amber-sile-yang/Pi-Hub-PCB/Rev A/Media/PCB_NFC_PI_1.png

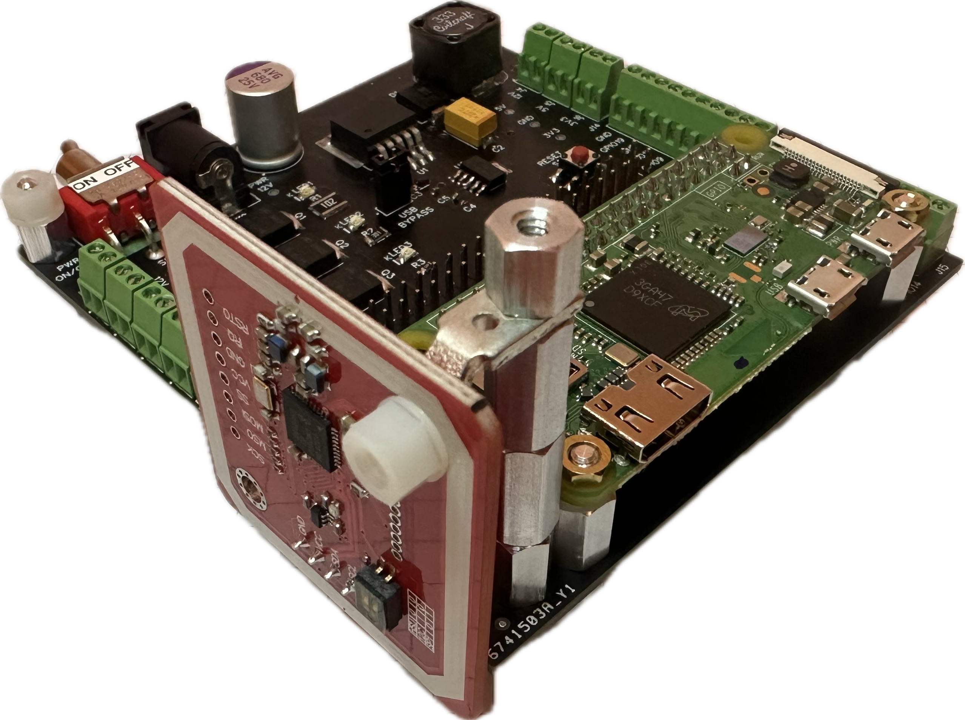
Rev A/Media/PCB_NFC_PI_1.png
