amber-sile-yang/Pi-Hub-PCB/Rev A/Media/PCB_Front_Side_View_1600_840.png

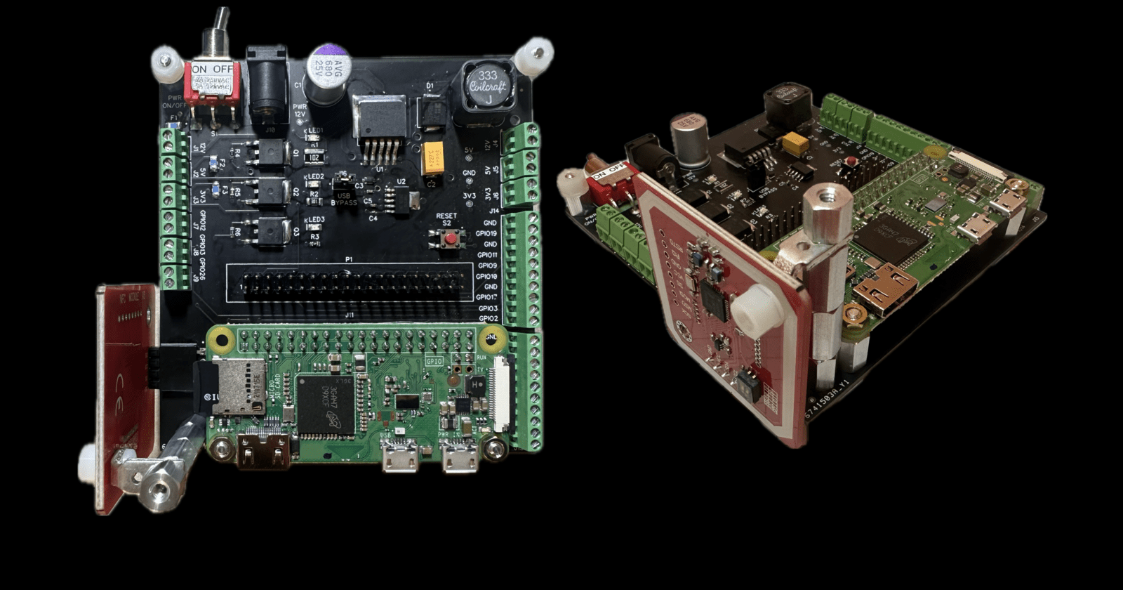
Rev A/Media/PCB_Front_Side_View_1600_840.png
