amber-sile-yang/Pi-Hub-PCB/Rev A/Regulator Circuit/TPS79633_5 to 3V_Regulator Circuit.pdf

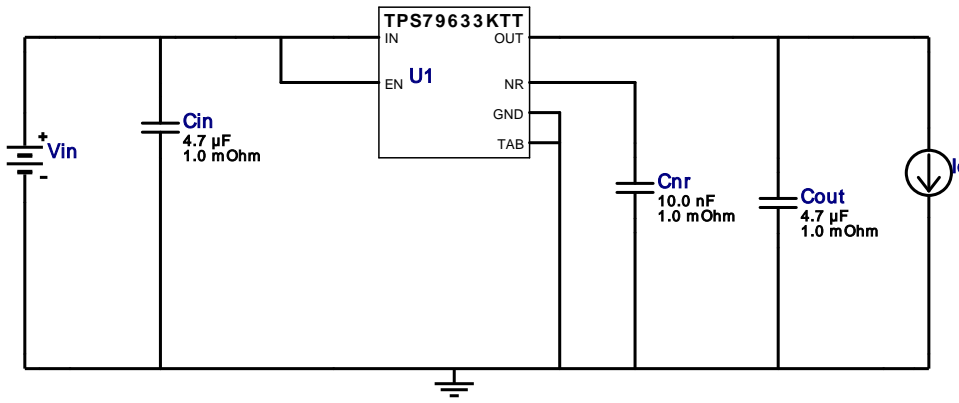
[picture p7: figure]
Cin 4.7 µF 1.0 m Ohm; Cnr 10.0 nF 1.0 m Ohm; Cout 4.7 µF 1.0 m Ohm; TPS7 9 6 3 3 KTT; GND; OUT; TAB; Vin

Copyright © 2023, Texas Instruments Incorporated | 1 | ti.com/webench

WEBENCH®
Design Report TPS79633KTTR : TPS79633KTTR 3.64V-5.08V to 3.30V @ 1A October 2, 2023 13:13:07 GMT-05:00

## WEBENCH ® Design Report

Design : 3 TPS79633KTTR
TPS79633KTTR 3.64V-5.08V to 3.30V @ 1A

VinMin = 3.64V
VinMax = 5.08V
Vout = 3.3V
Iout = 1.0A

Device = TPS79633KTTR
Topology = LDO
Created = 2023-10-02 13:11:06.164 BOM Cost = $1.58
BOM Count = 4
Total Pd = 1.78W

Vout = 3.3V
Iout = 1.0A

Iout

## Electrical BOM

Name | Manufacturer | Part Number | Properties | Qty Price | Footprint
Cin | MuRata | GRM155R60J475ME87D Series= X5R | Cap= 4.7 uF ESR= 1.0 mOhm VDC= 6.3 V IRMS= 0.0 A
1 | $0.01
| | | | | 0402_065 3 mm²
Cnr | MuRata | GRM033R70J103KA01D (http://search.murata.co.jp/Ceramy/PnsearchViewAction.do) Series= X7R

Cap= 10.0 nF
ESR= 1.0 mOhm
VDC= 6.3 V
IRMS= 0.0 A

1 $0.01
0201 2 mm²
Cout | MuRata | GRM155R60J475ME87D Series= X5R

Cap= 4.7 uF
ESR= 1.0 mOhm
VDC= 6.3 V
IRMS= 0.0 A

1 $0.01
0402_065 3 mm²
U1 | Texas Instruments | TPS79633KTTR (http://www.ti.com/product/TPS796) | Switcher | 1 | $1.55

KTT0005A_N 210 mm²

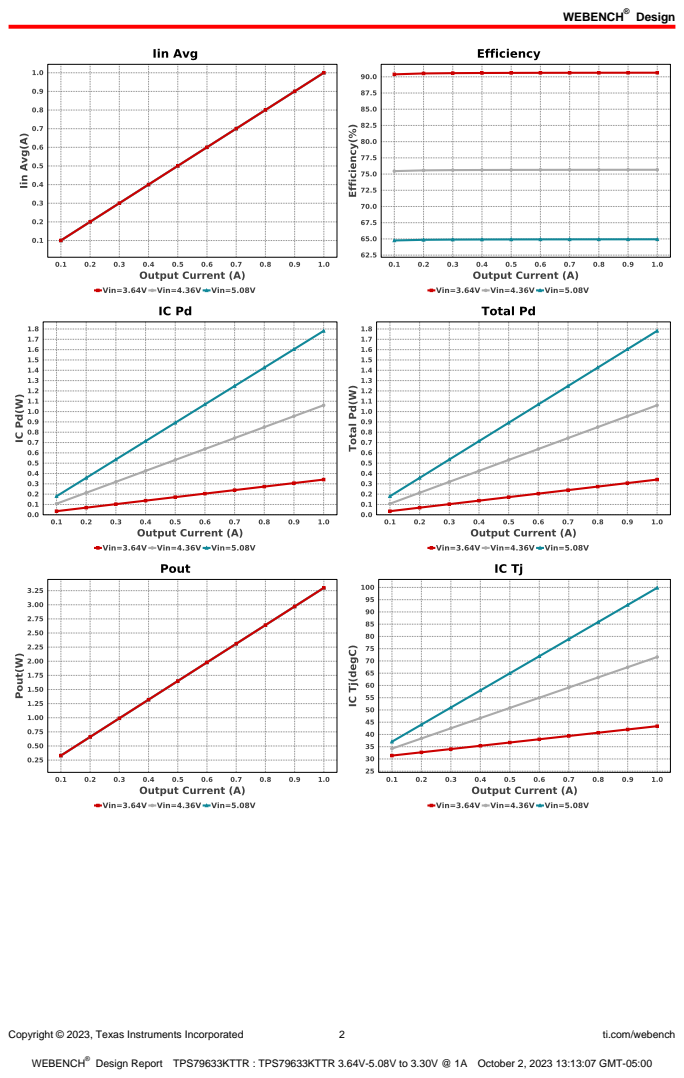
[picture p8: page 2]
Design; Copyright © 2023, Texas Instruments Incorporated; ti.com/webench

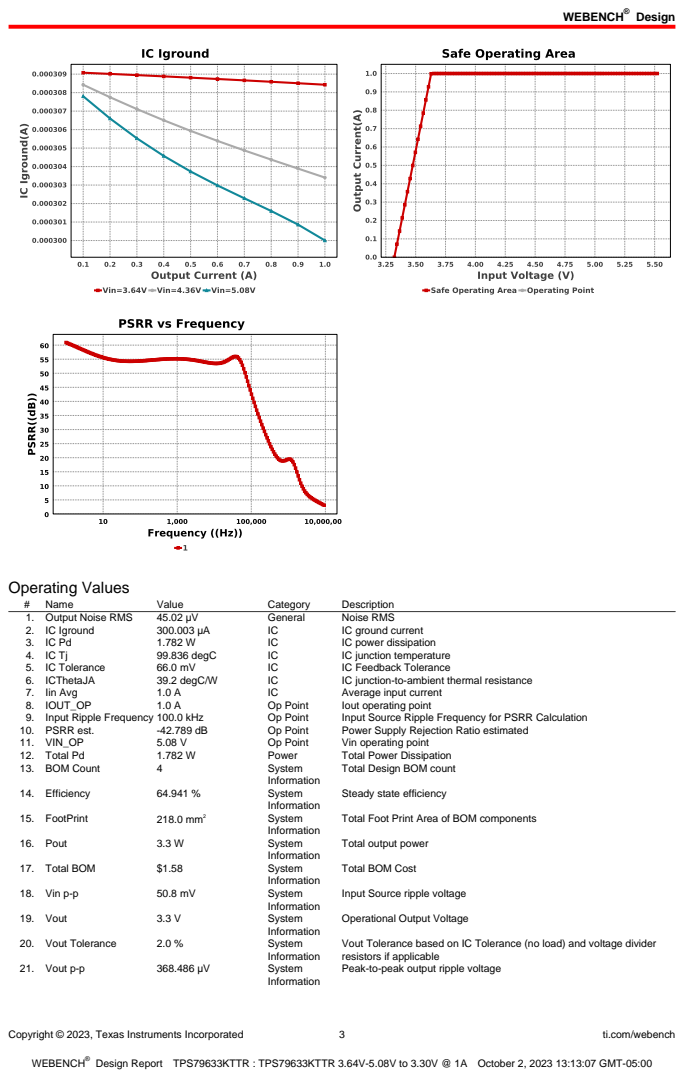
[picture p9: page 3]
Copyright © 2023, Texas Instruments Incorporated; ti.com/webench; Operating Values; Name; Value; Category; Description; 1. Output Noise RMS; General; Noise RMS; 2. IC Iground; IC ground current; IC power dissipation; 99.836 degC; IC junction temperature; 5. IC Tolerance; IC Feedback Tolerance; 6. ICThetaJA; 39.2 degC/W; IC junction-to-ambient thermal resistance; 7. Iin Avg; Average input current; 8. IOUT_OP; Op Point; Iout operating point; 9. Input Ripple Frequency 100.0 kHz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

Total Design BOM count

Steady state efficiency

Total Foot Print Area of BOM components

Total output power

Total BOM Cost

Input Source ripple voltage

Operational Output Voltage

Vout Tolerance based on IC Tolerance (no load) and voltage divider
resistors if applicable
Peak-to-peak output ripple voltage

Copyright © 2023, Texas Instruments Incorporated | 4 | ti.com/webench

## Design Inputs

Name | Value | Description
Iout | 1.0 | Maximum Output Current
VinMax | 5.08 | Maximum input voltage
VinMin | 3.64 | Minimum input voltage
Vout | 3.3 | Output Voltage
base_pn | TPS79633 | Base Product Number
source | DC | Input Source Type
Ta | 30.0 | Ambient temperature


Copyright © 2023, Texas Instruments Incorporated | 5 | ti.com/webench

## Assembly

## Component Testing

Some published data on components in datasheets such as Capacitor ESR and Inductor DC resistance is based on conservative values that will guarantee that the components always exceed the specification. For design purposes it is usually better to work with typical values. Since this data is not always available it is a good practice to measure the Capacitance and ESR values of Cin and Cout, and the inductance and DC resistance of L1 before assembly of the board. Any large discrepancies in values should be electrically simulated in WEBENCH to check for instabilities and thermally simulated in WebTHERM to make sure critical temperatures are not exceeded.

## Soldering Component to Board

If board assembly is done in house it is best to tack down one terminal of a component on the board then solder the other terminal. For surface mount parts with large tabs, such as the DPAK, the tab on the back of the package should be pre-tinned with solder, then tacked into place by one of the pins. To solder the tab town to the board place the iron down on the board while resting against the tab, heating both surfaces simultaneously. Apply light pressure to the top of the plastic case until the solder flows around the part and the part is flush with the PCB. If the solder is not flowing around the board you may need a higher wattage iron (generally 25W to 30W is enough).

## Initial Startup of Circuit

It is best to initially power up the board by setting the input supply voltage to the lowest operating input voltage 3.64V and set the input supply's current limit to zero. With the input supply off connect up the input supply to Vin and GND. Connect a digital volt meter and a load if needed to set the minimum Iout of the design from Vout and GND. Turn on the input supply and slowly turn up the current limit on the input supply.
If the voltage starts to rise on the input supply continue increasing the input supply current limit while watching the output voltage. If the current increases on the input supply, but the voltage remains near zero, then there may be a short or a component misplaced on the board. Power down the board and visually inspect for solder bridges and recheck the diode and capacitor polarities. Once the power supply circuit is operational then more extensive testing may include full load testing, transient load and line tests to compare with simulation results.

## Load Testing

The setup is the same as the initial startup, except that an additional digital voltmeter is connected between Vin and GND, a load is connected between Vout and GND and a current meter is connected in series between Vout and the load. The load must be able to handle at least rated output power + 50% ( 7.5 watts for this design). Ideally the load is supplied in the form of a variable load test unit. It can also be done in the form of suitably large power resistors. When using an oscilloscope to measure waveforms on the prototype board, the ground leads of the oscilloscope probes should be as short as possible and the area of the loop formed by the ground lead should be kept to a minimum. This will help reduce ground lead inductance and eliminate EMI noise that is not actually present in the circuit.

## Design Assistance

1.
2. Master key : 29F0C5E535570A6F9FC1D70942BDB839[v1]
3. TPS79633 Product Folder : http://www.ti.com/product/TPS796 : contains the data sheet and other resources.

Copyright © 2023, Texas Instruments Incorporated | 6 | ti.com/webench

Important Notice and Disclaimer

TI provides technical and reliability data (including datasheets), design resources (including reference designs), application or other design advice, web tools, safety information, and other resources AS IS and with all faults, and disclaims all warranties. These resources are intended for skilled developers designing with TI products. You are solely responsible for (1) selecting the appropriate TI products for your application, (2) designing, validating and testing your application, and (3) ensuring your application meets applicable standards, and any other safety, security, or other requirements.

These resources are subject to change without notice. TI grants you permission to use these resources only for development of an application that uses the TI products described in the resource. Other reproduction and display of these resources is prohibited. No license is granted to any other TI intellectual property right or to any third party intellectual property right. TI disclaims responsibility for, and you will fully indemnify TI and its representatives against, any claims, damages, costs, losses, and liabilities arising out of your use of these resources.

Providing these resources does not expand or otherwise alter TI's applicable Terms of Sale or other applicable terms available either on ti.com or provided in conjunction with TI products.
