amber-sile-yang/Pi-Hub-PCB/Rev A/History/PCB Connector Pinouts.pdf

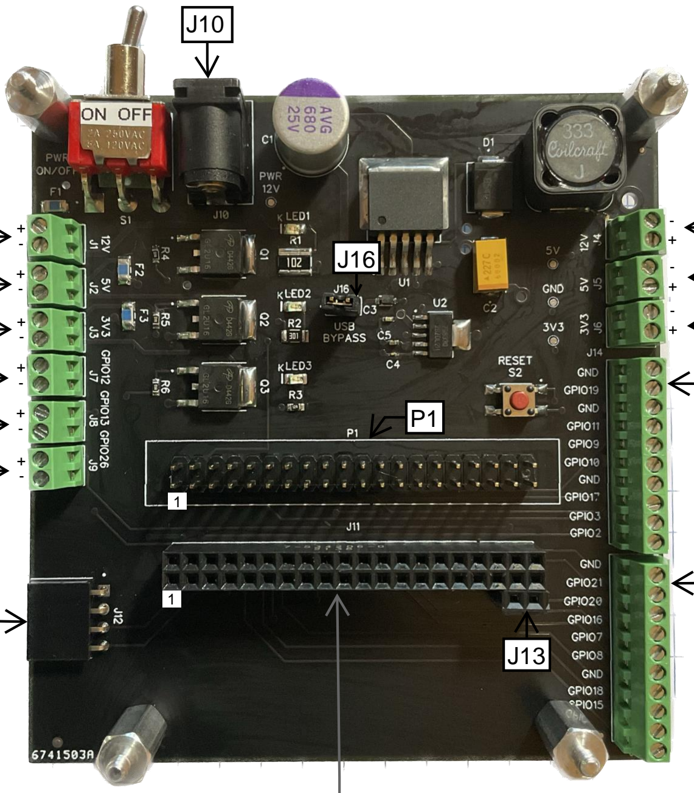
[picture p11: figure]
