amber-sile-yang/Pi-Hub-PCB/Rev A/Pinout_Rev A/PCB Connector Pinouts Diagram.pdf

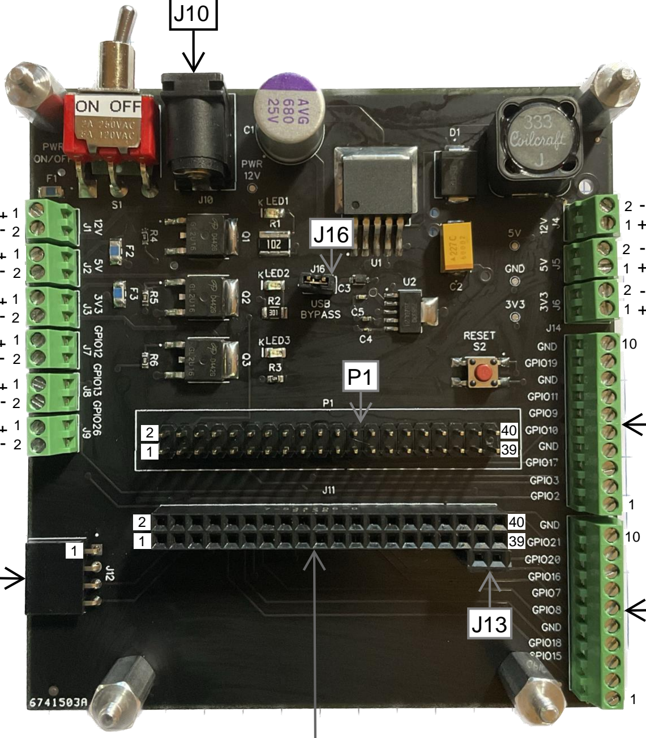
[picture p12: figure]
