amber-sile-yang/Pi-Hub-PCB/Rev A/Other/PCB_Invoice.pdf

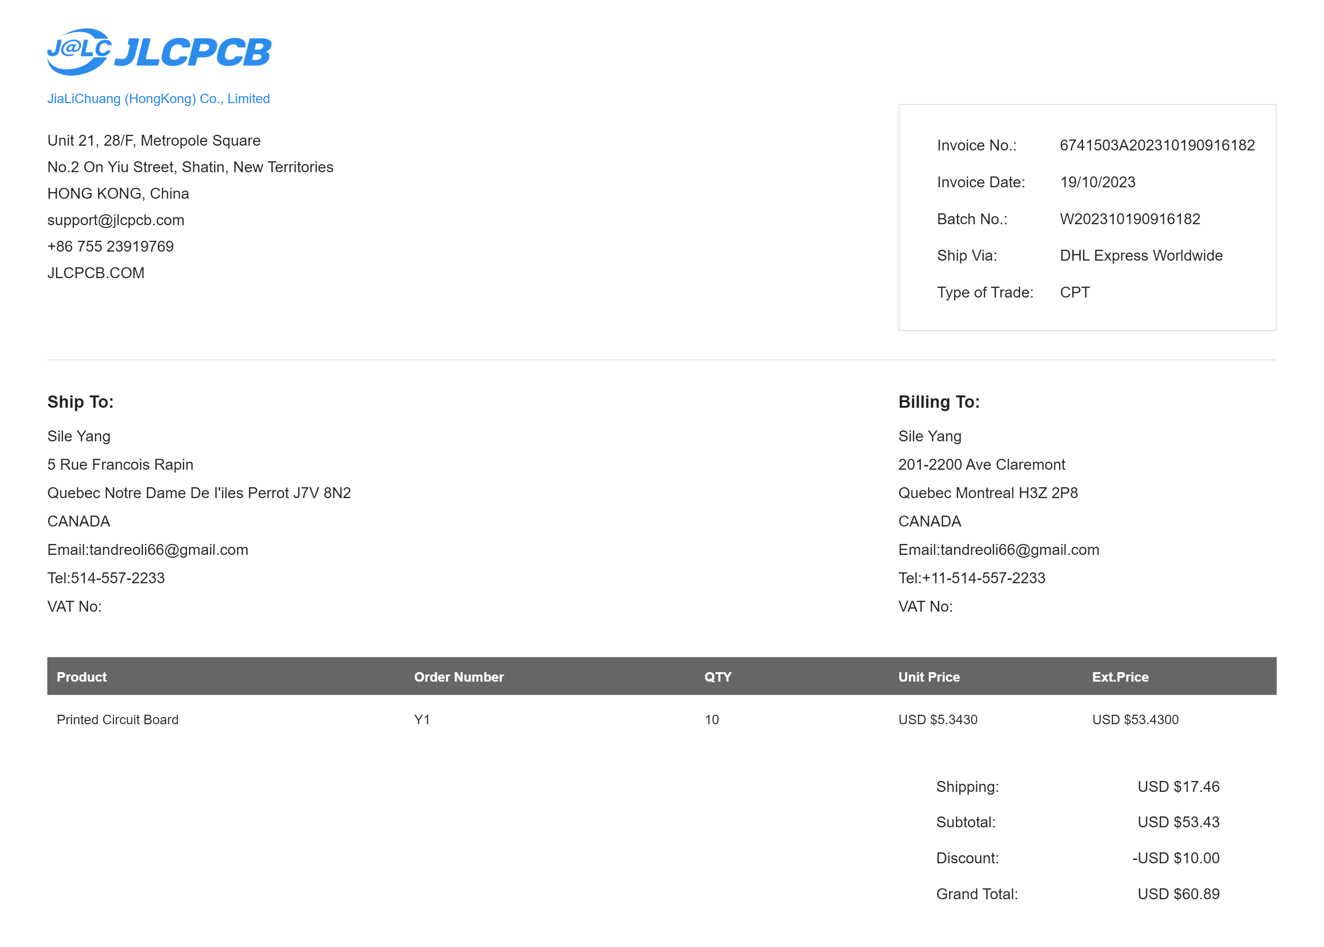
[picture p13: figure]
