amber-sile-yang/Pi-Hub-PCB/Layout_Rev B/Saturn_2A_Trace.png

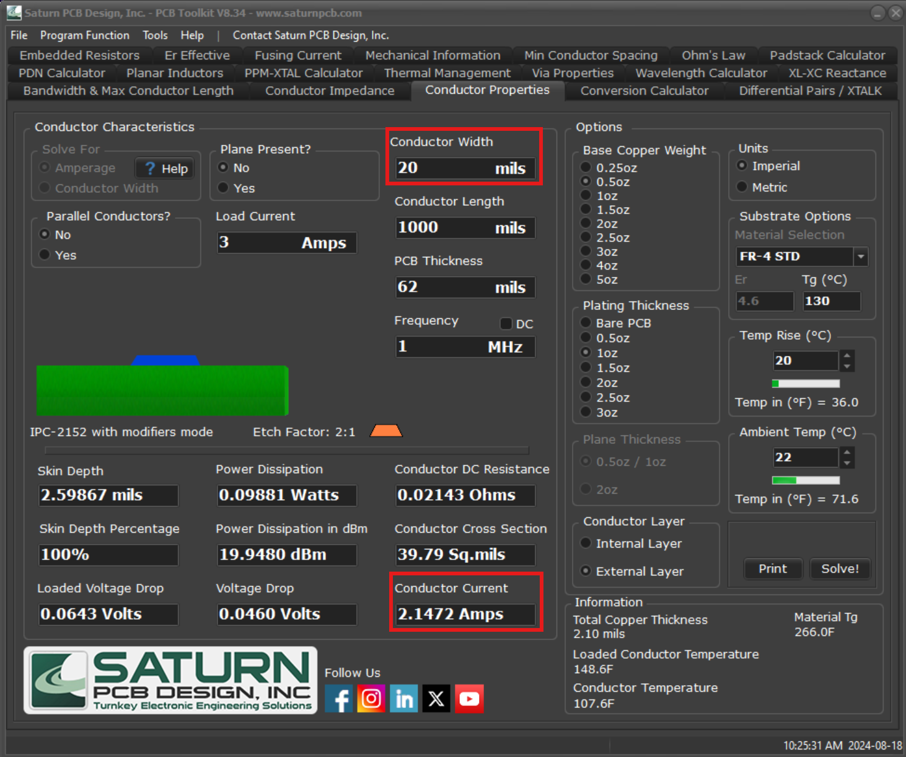
Layout_Rev B/Saturn_2A_Trace.png
