amber-sile-yang/Pi-Hub-PCB/Rev A/3D Model_Rev A/3D3.png

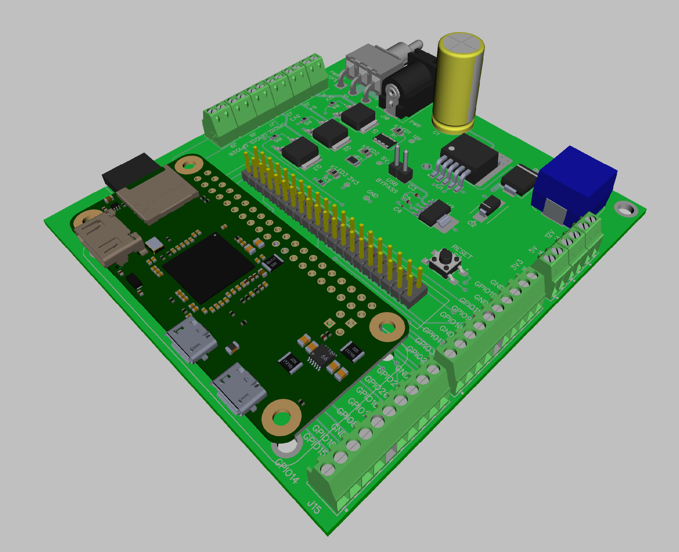
Rev A/3D Model_Rev A/3D3.png
