amber-sile-yang/Pi-Hub-PCB/Rev A/3D Model_Rev A/3D4.png

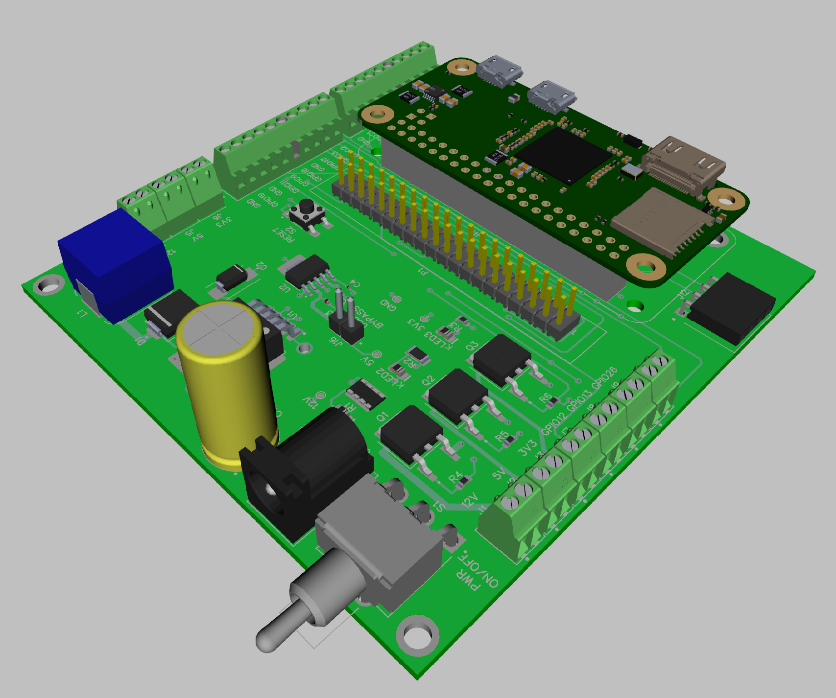
Rev A/3D Model_Rev A/3D4.png
