amber-sile-yang/Pi-Hub-PCB/Rev A/3D Model_Rev A/collage.jpg

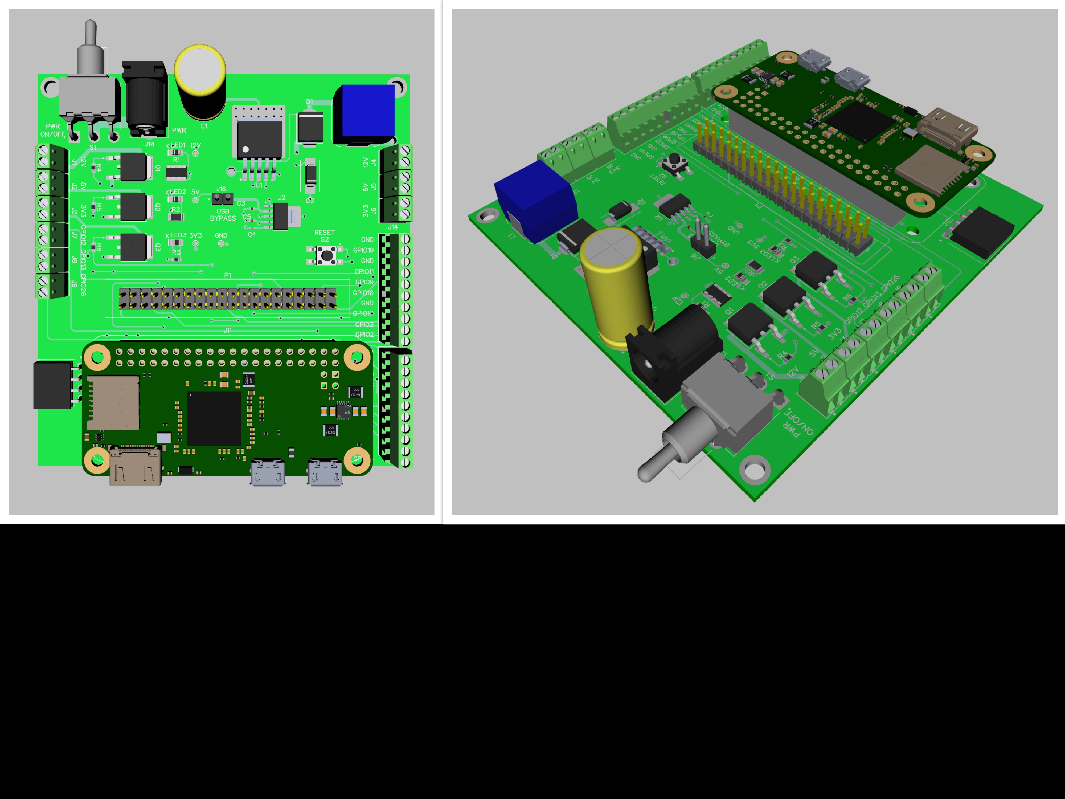
Rev A/3D Model_Rev A/collage.jpg
