amber-sile-yang/Pi-Hub-PCB/Rev A/History/Black PCB Design.png

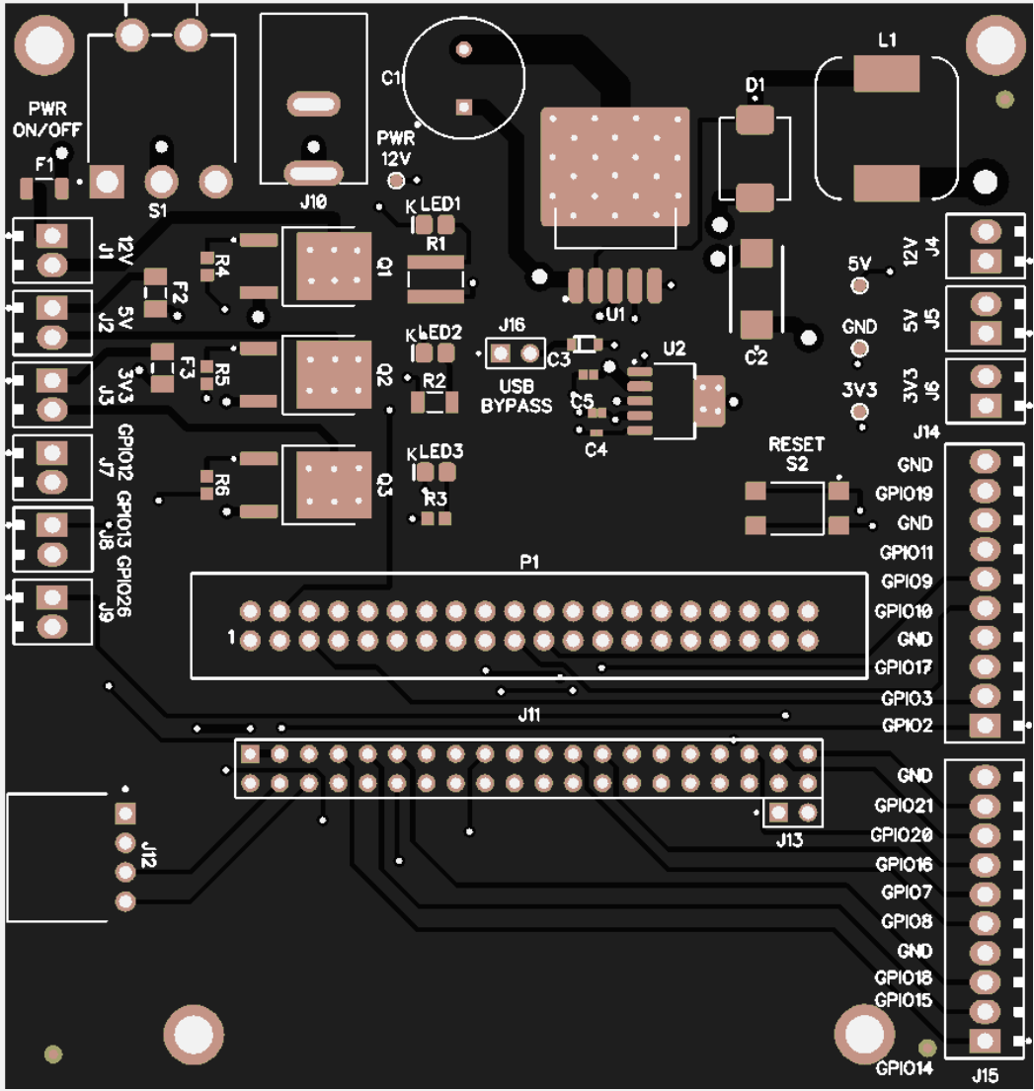
Rev A/History/Black PCB Design.png
