amber-sile-yang/Pi-Hub-PCB/Rev A/Layout_Rev A/Rev--.png

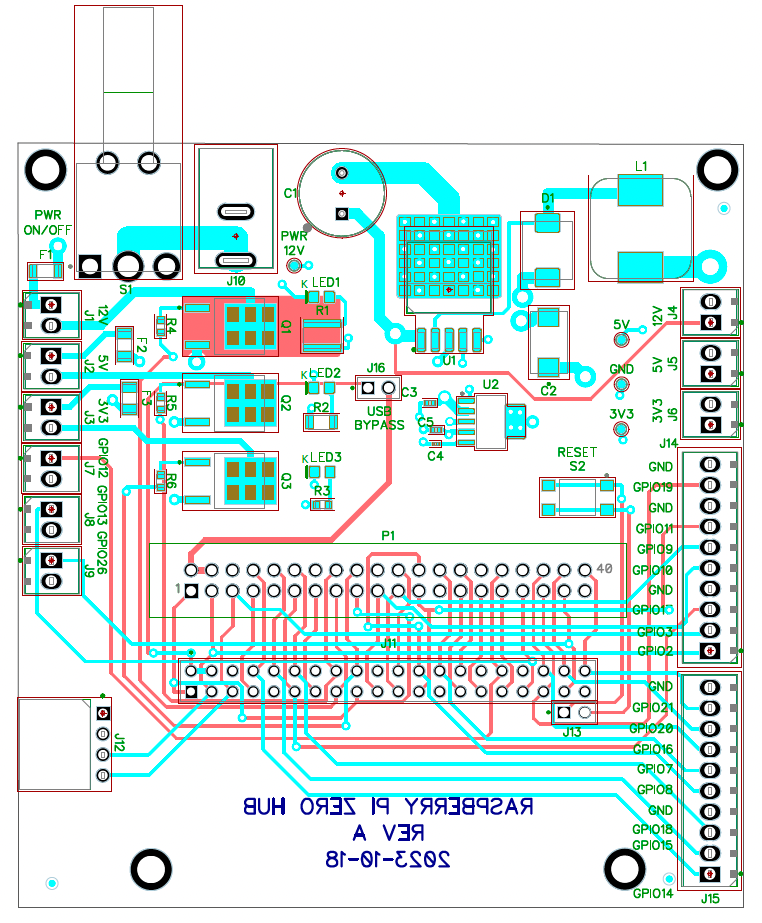
Rev A/Layout_Rev A/Rev--.png
