amber-sile-yang/Pi-Hub-PCB/Rev A/Media/History/PCB Connector Pinout.png

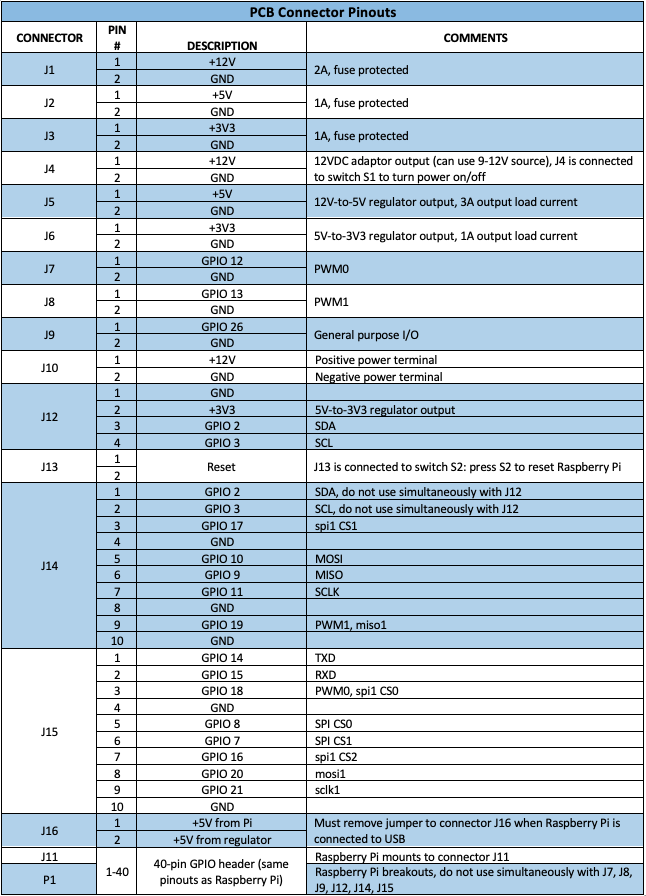
Rev A/Media/History/PCB Connector Pinout.png
