amber-sile-yang/Pi-Hub-PCB/Rev A/Media/History/schematic.jpg

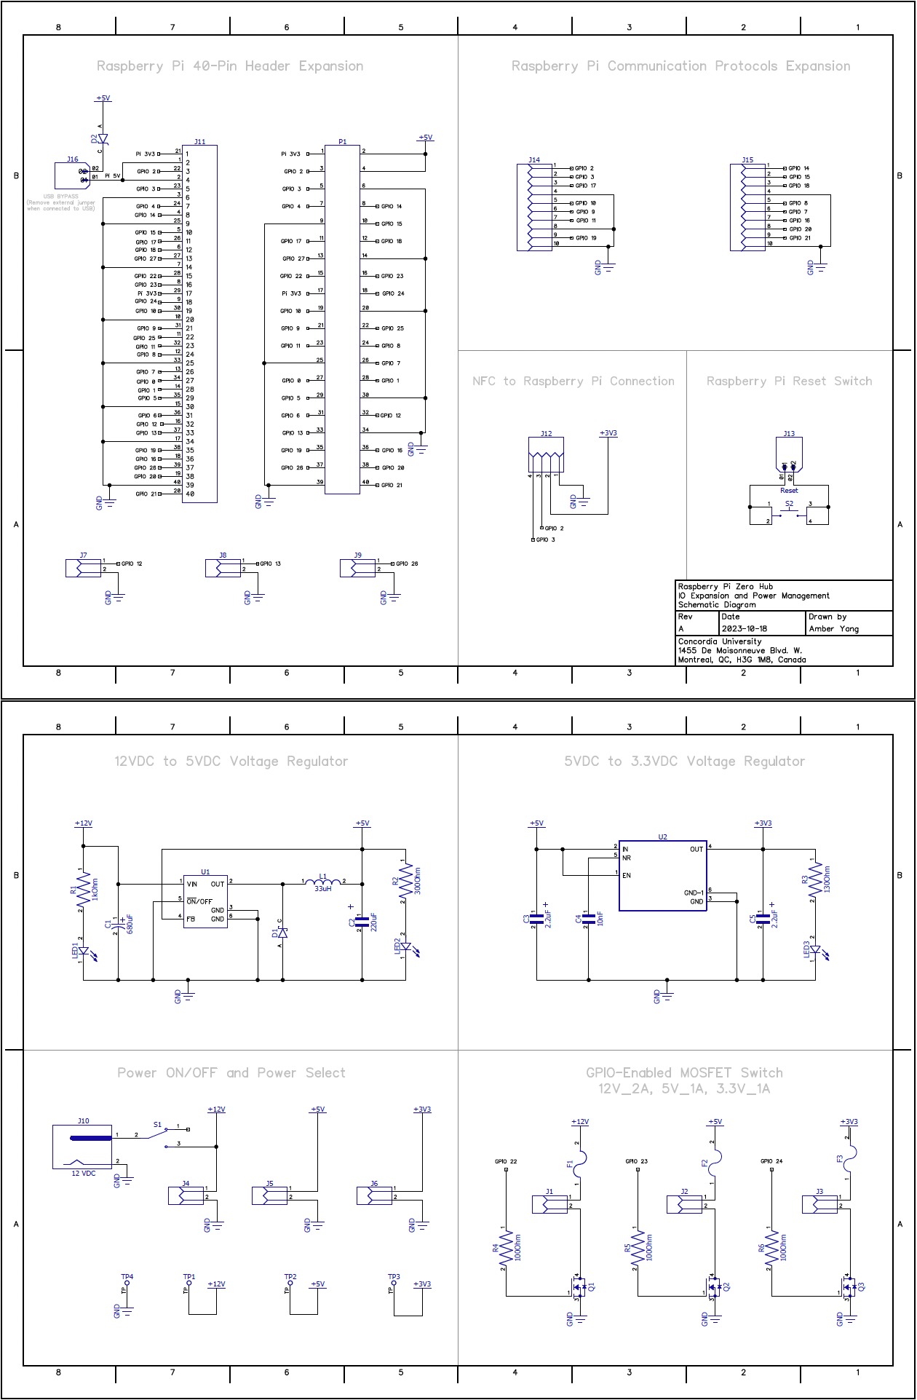
Rev A/Media/History/schematic.jpg
