amber-sile-yang/Pi-Hub-PCB/Rev A/Schematic_Rev A/revA 1.png

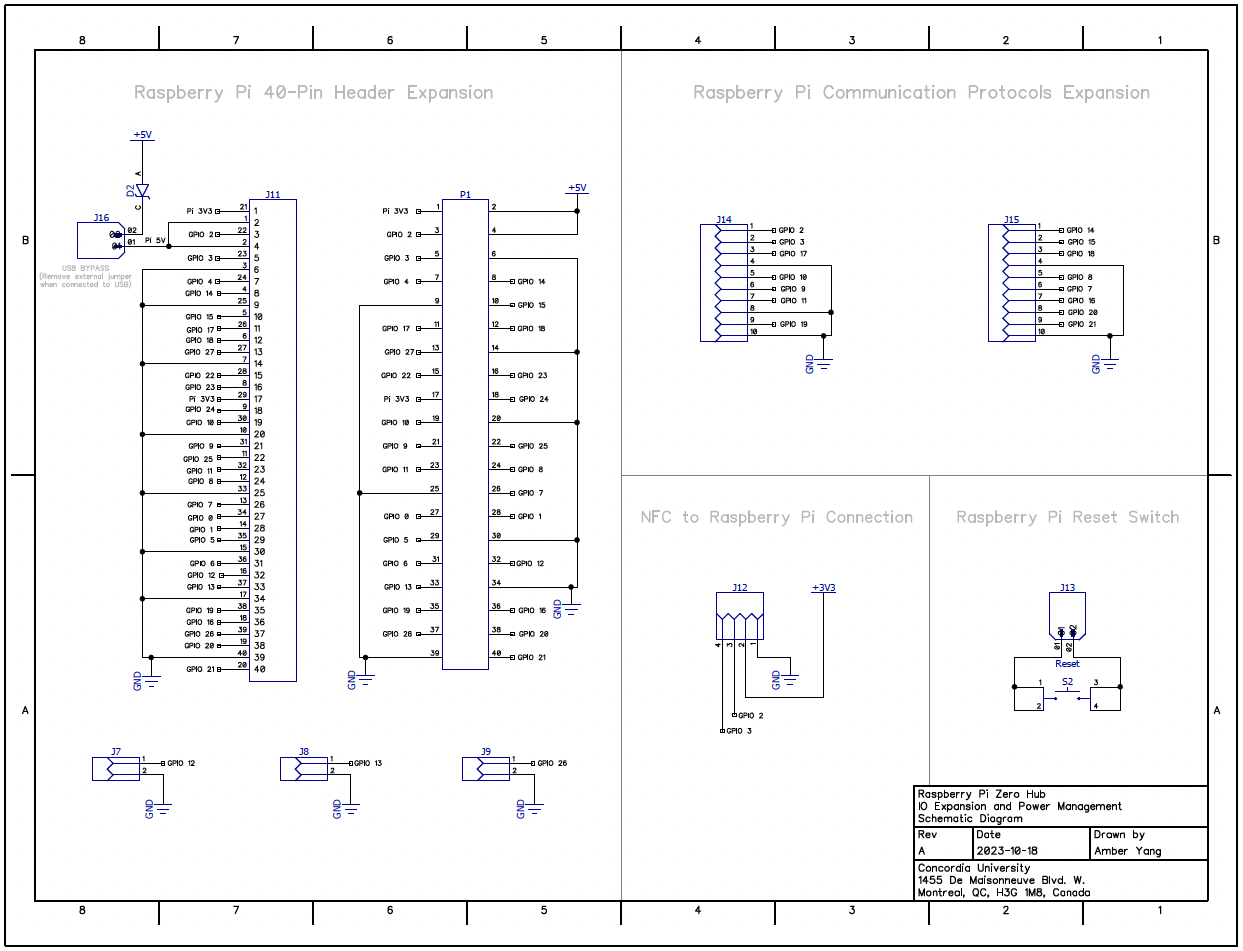
Rev A/Schematic_Rev A/revA 1.png
