amber-sile-yang/Pi-Hub-PCB/Rev A/Schematic_Rev A/revA 2.png

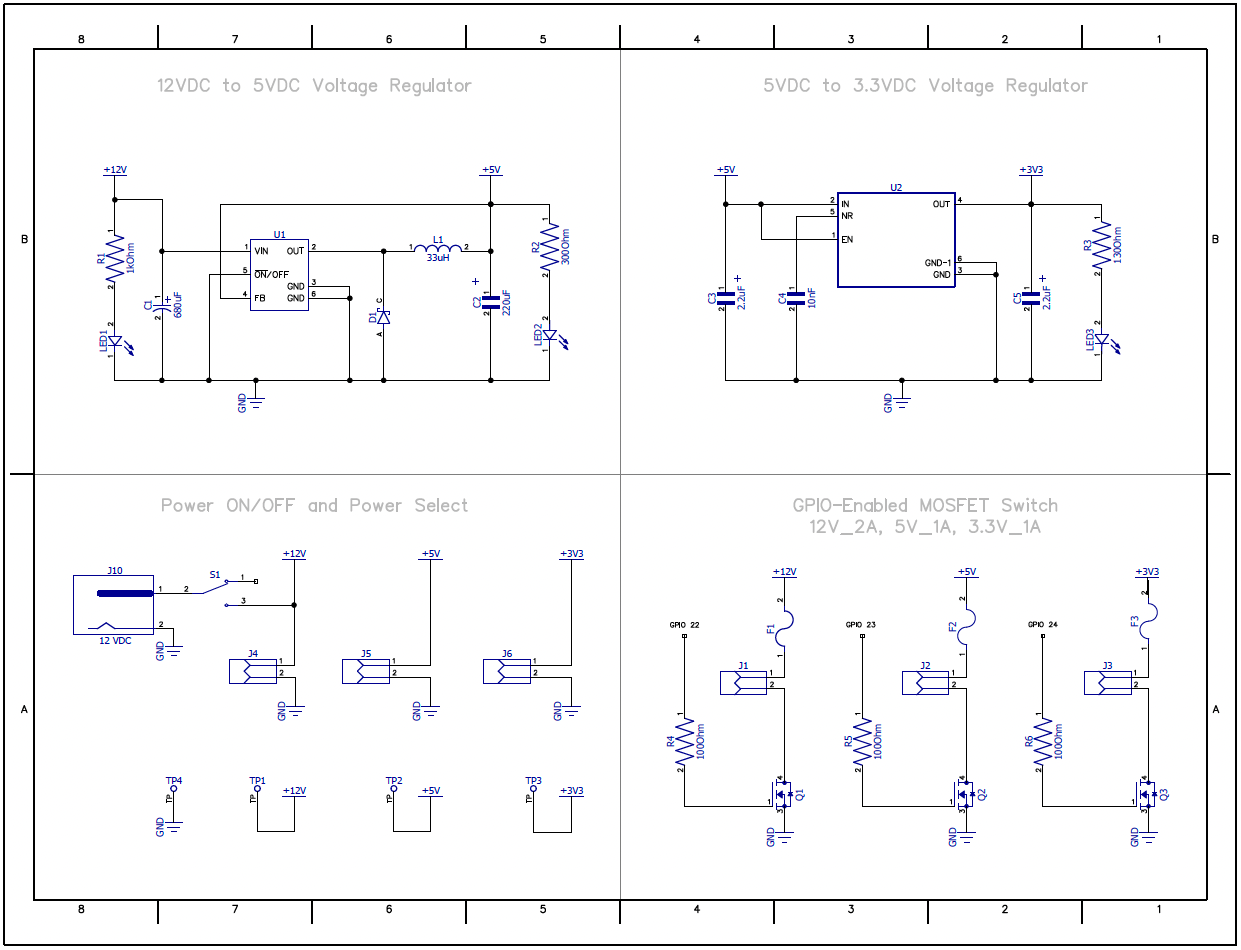
Rev A/Schematic_Rev A/revA 2.png
