amber-sile-yang/Pi-Hub-PCB/Rev A/BOM_Rev A/BOM.xlsx

PCB Bill of Materials
Item | Ref Des | Qty | Manufacturer | Mfg Part # | Description | Type | Unit Price | Website
1 | Q1-Q3 | 3 | Alpha & Omega | AOD442G | MOSFET N-CH 30V 9.5A 8-SOIC | SMD | 1 | Link (https://www.digikey.ca/en/products/detail/alpha-omega-semiconductor-inc/AOD442G/11567435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)
2 | R4- R6 | 3 | Stackpole | RMCF0603FT100R | RES 100 OHM 1% 1/10W 0603 | SMD |  | Link (https://www.digikey.ca/en/products/detail/stackpole-electronics-inc/RMCF0603FT100R/1761113)
3 | LED1-LED3 | 3 | VCC | LSM0805452V | LED SM 0805 2V 35MCD GREEN | SMD | 0.5 | Link (https://www.digikey.ca/en/products/detail/visual-communications-company-vcc/LSM0805452V/10229612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)
4 | S1 | 1 | E-Switch | 100SP1T2B4M6QE | SWITCH TOGGLE SPDT 5A 120V | Thru-Hole | 5.6 | Link (https://www.digikey.ca/en/products/detail/e-switch/100SP1T2B4M6QE/378831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)
5 | S3 | 1 | E-Switch | TL3305AF260QG | SWITCH TACTILE SPST-NO 50MA 12V | SMD |  | Link (https://www.digikey.ca/en/products/detail/e-switch/TL3305AF260QG/5816184)
6 | J1-J9 | 9 | On Shore | OSTVN02A150 | 2 Position Terminal Block 2.54mm, Screw-In | Thru-Hole | 1 | Link (https://www.digikey.ca/en/products/detail/on-shore-technology-inc/OSTVN02A150/1588862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)
7 | J10 | 1 | CUI Devices | PJ-037A | CONN PWR JACK 2X5.5MM SOLDER | Thru-Hole | 1 | Link (https://www.digikey.ca/en/products/detail/cui-devices/PJ-037A/1644545)
8 | J11 | 1 | TE Connectivity | 7-534206-0 | Headers & Wire Housings,40 Pin, Female | Thru-Hole | 7.6 | Link (https://www.mouser.ca/ProductDetail/TE-Connectivity/7-534206-0?qs=mDUKaTHq%2BXZkXItnxDtoig%3D%3D)
9 | P1 | 1 | SparkFun | PRT-14275 | RASPBERRYPI GPIO MALE HEADER | Thru-Hole | 1.5 | Link (https://www.digikey.ca/en/products/detail/sparkfun-electronics/PRT-14275/7428264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)
10 | J12 | 1 | Sullins | PPPC041LGBN-RC | CONN HDR 4POS 0.1 GOLD PCB, FEMALE | Thru-Hole | 0.6 | Link (https://www.digikey.ca/en/products/detail/sullins-connector-solutions/PPPC041LFBN-RC/810176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)
11 | J13 | 1 | Sullins | PPPC021LFBN-RC | CONN HDR 2POS 0.1 GOLD PCB, FEMALE | Thru-Hole | 0.5 | Link (https://www.digikey.ca/en/products/detail/sullins-connector-solutions/PPPC021LFBN-RC/810174)
12 | J14, J15 | 2 | On Shore | OSTVN10A150 | TERM BLK 10P SIDE ENT 2.54MM, SCREW-IN | Thru-Hole | 4.4 | Link (https://www.digikey.ca/en/products/detail/on-shore-technology-inc/OSTVN10A150/1588870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)
13 | J16 | 1 | Wurth | 61300211121 | CONN HEADER VERT 2POS 2.54MM | Thru-Hole |  | Link (https://www.digikey.ca/en/products/detail/w%C3%BCrth-elektronik/61300211121/4846823)
14 | F2,F3 | 2 | Bel Fuse | C1Q 1.5 | FUSE BRD MT 1.5A 125VAC 63VDC | SMD | 0.5 | Link (https://www.digikey.ca/en/products/detail/bel-fuse-inc/C1Q-1-5/615158?s=N4IgTCBcDaIMYEYCOBaBA6ArCAugXyA)
15 | F1 | 1 | Bel Fuse | C1Q 2.5 | FUSE BRD MT 2.5A 125VAC 63VDC | SMD | 0.5 | Link (https://www.digikey.ca/en/products/detail/bel-fuse-inc/C1Q-2-5/615152)
16 | D2 | 1 | Toshiba | CUS08F30,H3F | DIODE SCHOTTKY 30V 800MA USC | SMD | 0.5 | Link (https://www.digikey.ca/en/products/detail/toshiba-semiconductor-and-storage/CUS08F30-H3F/5114298)
17 | U1 | 1 | Texas Instruments | LM2596 | IC REG BUCK 5V 3A DDPAK | SMD | 9.6 | Link (https://www.digikey.ca/en/products/detail/texas-instruments/LM2596SX-5-0-NOPB/334927)
18 | R1 | 1 | YAGEO | RC1218JK-071KL | RES 1K OHM 5% 1W 1812 WIDE | SMD | 0.5 | Link (https://www.digikey.ca/en/products/detail/yageo/RC1218JK-071KL/5920849)
19 | R2 | 1 | YAGEO | RC1206JR-07300RL | RES 300 OHM 5% 1/4W 1206 | SMD |  | Link (https://www.digikey.ca/en/products/detail/yageo/RC1206JR-07300RL/729275)
20 | C1 | 1 | Cornell | 687AVG025MGBJ | CAP ALUM POLY 680UF 20% 25V T/H | Thru-Hole | 3.6 | Link (https://www.digikey.ca/en/products/detail/cornell-dubilier-illinois-capacitor/687AVG025MGBJ/5413286)
21 | C2 | 1 | Kyocera Avx | TPME227K016R0025 | CAP TANT 220UF 10% 16V 2917 | SMD | 6.5 | Link (https://www.digikey.ca/en/products/detail/kyocera-avx/TPME227K016R0025/929934)
22 | D1 | 1 | Diodes | B540C-13-F | DIODE SCHOTTKY 40V 5A SMC | SMD | 0.7 | Link (https://www.digikey.ca/en/products/detail/diodes-incorporated/B540C-13-F/768771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)
23 | L1 | 1 | Coilcraft | MSS1210-333MED | Power Inductors, 33uH Shld 20% 5.9A 39mOhms | SMD
24 | U2 | 1 | Texas Insruments | TPS79633 | IC REG LINEAR 3.3V 1A SOT223-6 | SMD | 5.7 | Link (https://www.digikey.ca/en/products/detail/texas-instruments/TPS79633QDCQRQ1/3431171)
25 | R3 | 1 | Stackpole | RMCF0603FT130R | RES 130 OHM 1% 1/10W 0603 | SMD |  | Link (https://www.digikey.ca/en/products/detail/stackpole-electronics-inc/RMCF0603FT130R/1761271)
26 | C3, C5 | 2 | Murata | GRM155R60J225ME01 | CAP CER 2.2UF 6.3V X5R 0402 | SMD |  | Link (https://www.digikey.ca/en/products/detail/murata-electronics/GRM155R60J225ME01D/10705507)
27 | C4 | 1 | Murata | GRM033R70J103KA01D | CAP CER 10000PF 6.3V X7R 0201 | SMD |  | Link (https://www.digikey.ca/en/products/detail/murata-electronics/GRM033R70J103KA01D/587251)
28 | NA | 1 | Raspberry Pi | RPI-0271 | Raspberry Pi Zero W | Header |  | Link (https://www.amazon.ca/dp/B06XFZC3BX?psc=1&ref=ppx_yo2ov_dt_b_product_details)
29 | NA | 1 | NXP | PN532 | NFC RFID Module NXP PN532 V3 Kit Read/Write | Header |  | Link (https://www.amazon.ca/gp/product/B083DY9F9K/ref=ppx_yo_dt_b_asin_title_o00_s00?ie=UTF8&psc=1)
30 | NA | 1 | Sparkfun | PRT-14275 | RASPBERRYPI GPIO MALE HEADER | Thru-Hole | 1.5 | Link (https://www.digikey.ca/en/products/detail/sparkfun-electronics/PRT-14275/7428264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)
31 | NA | 1 | Wurth | 61300211121 | CONN HEADER VERT 2POS 2.54MM | Thru-Hole |  | Link (https://www.digikey.ca/en/products/detail/w%C3%BCrth-elektronik/61300211121/4846823)
32 | NA | 1 | Wurth | 61300411121 | CONN HEADER VERT 4POS 2.54MM | Thru-Hole |  | Link (https://www.digikey.ca/en/products/detail/w%C3%BCrth-elektronik/61300411121/4846827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)
33 | NA | 1 | Gikfun | EK2107x2C | 9v Battery Holder with ON/Off Switch | External | 5 | Link (https://www.amazon.ca/Gikfun-Battery-Holder-Arduino-EK2107x2C/dp/B07G583G88)
34 | NA | 1 | ALITOVE | 61300211121 | 12V Power Supply 6A 72W AC to DC Adapter | External | 16 | Link (https://www.amazon.ca/Arkare-100V-240V-Security-Microphone-Receiver/dp/B0B51R6R2Y?s=electronics)
35 | NA | 1 | Wurth | 60900213421 | JUMPER W/TEST PNT 1X2PINS 2.54MMper | External
 |  |  |  |  |  |  | 90.2
