amber-sile-yang/Pi-Hub-PCB/PCB Workspace_Rev B.xlsx

Sheet: SPEC_Rev B
Iterm | P/N | Mount Type | Supply Voltage | Supply Current | Current Capacity | Power Rating | Supplier | Qty | Packaging | Manufacture | Schematic? | Symbol | Purchased?
Pi Zero W | RPI-0271 | Header | 5V | 150mA | 50mA - 150mA (3.3V pin & GPIOs) |  | Link (https://www.amazon.ca/dp/B06XFZC3BX?psc=1&ref=ppx_yo2ov_dt_b_product_details) | 1 |  |  | N/A |  | YES
NFC | PN532 | Header | 3.3V - 5V | 40mA | up to 1.2A (5V pin) |  | Link (https://www.amazon.ca/gp/product/B083DY9F9K/ref=ppx_yo_dt_b_asin_title_o00_s00?ie=UTF8&psc=1) | 1 |  |  | N/A |  | YES
IR | GP2Y0E03 | Wire | 2.7V - 5.5V (IO supply voltage: 1.8V - 3.3V) | 36mA |  |  |  | 1 |  |  | N/A |  | Not Used
PIR | NCS36000 | Wire | 3V - 5.75V | 50uA |  |  |  | 1 |  |  | N/A |  | Not Used
40-Pin Male Header for Pi | PRT-14275 | Through-Hole |  |  |  |  | Link (https://www.digikey.ca/en/products/detail/sparkfun-electronics/PRT-14275/7428264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) | 1 |  | Sparkfun | N/A |  | YES
2-Pin Male Header for Run |  | Through-Hole |  |  |  |  | Link (https://www.digikey.ca/en/products/detail/w%C3%BCrth-elektronik/61300211121/4846823) | 1 |  | Wurth | N/A |  | YES
4-Pin Male Header for NFC | 61300411121 | Through-Hole |  |  |  |  | Link (https://www.digikey.ca/en/products/detail/w%C3%BCrth-elektronik/61300411121/4846827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) | 1 |  | Wurth | N/A |  | YES
9V Battery Holder | EK2107x2C | External |  |  |  |  | Link (https://www.amazon.ca/Gikfun-Battery-Holder-Arduino-EK2107x2C/dp/B07G583G88) | 1 |  | Gikfun | N/A |  | YES
12V Power Adapter | 61300211121 | External |  |  |  |  | Link (https://www.amazon.ca/dp/B082PCR5YS?psc=1&ref=ppx_yo2ov_dt_b_product_details) | 1 |  | Arkare | N/A |  | YES
5V USB Bypass Jumper | 60900213421 |  |  |  |  |  | Link (https://www.digikey.ca/en/products/detail/w%C3%BCrth-elektronik/60900213421/2508447?productid=2508447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) | 1 |  | Wurth
MOSFET | AOD442G | Surface | VDS = 60V | ID = 25.5A (@100 °C) |  |  | Link (https://www.digikey.ca/en/products/detail/alpha-omega-semiconductor-inc/AOD442G/11567435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) | 3 | TO-252 | Alpha & Omega | YES | Q1, Q2, Q3 | YES
100 Ohm Resistor | RMCF0603FT100R | Surface |  |  |  |  | Link (https://www.digikey.ca/en/products/detail/stackpole-electronics-inc/RMCF0603FT100R/1761113) | 3 | 1608 | Stackpole | YES | R4, R5, R6 | YES
LED Indicator | LSM0805452V | Surface | 2V | 20mA |  |  | Link (https://www.digikey.ca/en/products/detail/visual-communications-company-vcc/LSM0805452V/10229612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) | 3 |  | VCC | YES | LED1, LED2, LED3 | YES
Power Selector Sw | 100SP1T2B4M6QE | Through-Hole | 120VAC/28VDC | 5A (AC/DC) |  |  | Link (https://www.digikey.ca/en/products/detail/e-switch/100SP1T2B4M6QE/378831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) | 1 |  | E-Switch | YES | S1 | YES
Run Sw | TL3305AF260QG | Surface |  |  |  |  | Link (https://www.digikey.ca/en/products/detail/e-switch/TL3305AF260QG/5816184) | 1 | SMD-4 | E-Switch | YES | S3 | YES
2-Pin Screw-In Output Connector | OSTVN02A150 | Through-Hole | 125V | 6A |  |  | Link (https://www.digikey.ca/en/products/detail/on-shore-technology-inc/OSTVN02A150/1588862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) | 9 |  |  | YES | J1, J2…J9 | YES
12V & 9V Power Adapter Connector | DCJ200-10-A-K1-K | Through-Hole | 12V | 5A |  |  | Link (https://www.digikey.ca/en/products/detail/gct/DCJ200-10-A-K1-K/9859579) | 1 |  | GCT | / | J10 | /
40-Pin Female Header for Pi | 7-534206-0 | Through-Hole |  |  |  |  | Link (https://www.mouser.ca/ProductDetail/TE-Connectivity/7-534206-0?qs=mDUKaTHq%2BXZkXItnxDtoig%3D%3D) | 1 |  | TE Connectivity | YES | J11 | YES
40-Pin Male Header for Pi | PRT-14275 | Through-Hole |  |  |  |  | Link (https://www.digikey.ca/en/products/detail/sparkfun-electronics/PRT-14275/7428264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) | 1 |  |  | YES | P1 | YES
4-Pin Female Header for NFC | PPPC041LGBN-RC | Through-Hole |  |  |  |  | Link (https://www.digikey.ca/en/products/detail/sullins-connector-solutions/PPPC041LFBN-RC/810176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) | 1 |  | Sullins | YES | J12 | YES
2-Pin Female Header for Run | PPPC021LFBN-RC | Through-Hole |  |  |  |  | Link (https://www.digikey.ca/en/products/detail/sullins-connector-solutions/PPPC021LFBN-RC/810174) | 1 |  | Sullins | YES | J13
10-Pin Header for Com | OSTVN10A150 | Through-Hole |  |  |  |  | Link (https://www.digikey.ca/en/products/detail/on-shore-technology-inc/OSTVN10A150/1588870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) | 2 |  | On Shore | YES | J14, J15 | YES
2-Pin Male Header 5V Isolation | 61300211121 | Through-Hole |  |  |  |  | Link (https://www.digikey.ca/en/products/detail/w%C3%BCrth-elektronik/61300211121/4846823) | 1 |  | Wurth | YES | J16 | YES
1.5A Fuse | C1Q 1.5 | Surface |  |  |  |  | Link (https://www.digikey.ca/en/products/detail/bel-fuse-inc/C1Q-1-5/615158?s=N4IgTCBcDaIMYEYCOBaBA6ArCAugXyA) | 2 | 1206 | Bel Fuse | YES | F2,F3 | YES
2.5A Fuse | C1Q 2.5 | Surface |  |  |  |  | Link (https://www.digikey.ca/en/products/detail/bel-fuse-inc/C1Q-2-5/615152) | 4 | 1206 | Bel Fuse | YES | F1 | YES
Schottky diode | CUS08F30,H3F | Surface |  |  |  |  | Link (https://www.digikey.ca/en/products/detail/toshiba-semiconductor-and-storage/CUS08F30-H3F/5114298) | 1 | SOD-323 | Toshiba |  | D2 | YES
12V-to-5V Regulator | LM2596 | Surface | 4.5V - 40V |  | 3A (@ Vin = 12V) |  | Link (https://www.digikey.ca/en/products/detail/texas-instruments/LM2596SX-5-0-NOPB/334927) | 1 | TO-263 |  | YES | U1 | YES
1000 Ohm Resistor | RC1218JK-071KL | Surface |  |  | 6A | 1W | Link (https://www.digikey.ca/en/products/detail/yageo/RC1218JK-071KL/5920849) | 1 | 1812 | YAGEO | YES | R1 | YES
300 Ohm Resistor | RC1206JR-07300RL | Surface |  |  |  | 0.25W | Link (https://www.digikey.ca/en/products/detail/yageo/RC1206JR-07300RL/729275) | 1 | 1206 | YAGEO | YES | R2 | YES
680 uF Capacitor | 687AVG025MGBJ | Through-Hole |  |  |  |  | Link (https://www.digikey.ca/en/products/detail/cornell-dubilier-illinois-capacitor/687AVG025MGBJ/5413286) | 1 |  | Cornell | YES | C1 | YES
220 uF Capacitor | TPME227K016R0025 | Surface |  |  |  |  | Link (https://www.digikey.ca/en/products/detail/kyocera-avx/TPME227K016R0025/929934) | 1 |  | Kyocera Avx | YES | C2 | YES
Schottky diode | B540C-13-F | Surface |  |  |  |  | Link (https://www.digikey.ca/en/products/detail/diodes-incorporated/B540C-13-F/768771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) | 1 |  | Diodes | YES | D1 | YES
Power inductor | MSS1210-333MED | Surface |  |  |  |  | Link (https://www.mouser.ca/ProductDetail/Coilcraft/MSS1210-333MED?qs=zCSbvcPd3pYfSbsW0sApcA%3D%3D) | 1 |  |  |  | L1 | YES
5V-to-3.3V Regulator | TPS79633 | Surface | 2.7 - 5.5V |  | 1A |  | Link (https://www.digikey.ca/en/products/detail/texas-instruments/TPS79633QDCQRQ1/3431171) | 1 | TPS79633QDCQRQ1 |  | YES | U2 | YES
130 Ohm Resistor | RMCF0603FT130R | Surface |  |  |  |  | Link (https://www.digikey.ca/en/products/detail/stackpole-electronics-inc/RMCF0603FT130R/1761271) | 1 | 1508 | Stackpole | YES | R3 | YES
2.2 uF Capacitor | GRM155R60J225ME01 | Surface |  |  |  |  | Link (https://www.digikey.ca/en/products/detail/murata-electronics/GRM155R60J225ME01D/10705507) | 2 | 402 | Murata | YES | C3, C5 | YES
10 nF Capacitor | GRM033R70J103KA01D | Surface |  |  |  |  | Link (https://www.digikey.ca/en/products/detail/murata-electronics/GRM033R70J103KA01D/587251) | 1 |  | Murata | YES | C4 | YES

Sheet: BOM_Rev B
PCB Bill of Materials
Item | Ref Des | Qty | Manufacturer | Mfg Part # | Description | Type | Package
1 | Q1-Q3 | 3 | Alpha & Omega | AOD442G | MOSFET N-CH 30V 9.5A 8-SOIC | SMD | TO-252 | Link (https://www.digikey.ca/en/products/detail/alpha-omega-semiconductor-inc/AOD442G/11567435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)
2 | R4- R6 | 3 | Stackpole | RMCF0603FT100R | RES 100 OHM 1% 1/10W 0603 | SMD | 1608 | Link (https://www.digikey.ca/en/products/detail/stackpole-electronics-inc/RMCF0603FT100R/1761113)
3 | LED1-LED3 | 3 | VCC | LSM0805452V | LED SM 0805 2V 35MCD GREEN | SMD | 0805 | Link (https://www.digikey.ca/en/products/detail/visual-communications-company-vcc/LSM0805452V/10229612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)
4 | S1 | 1 | E-Switch | 100SP1T2B4M6QE | SWITCH TOGGLE SPDT 5A 120V | Thru-Hole |  | Link (https://www.digikey.ca/en/products/detail/e-switch/100SP1T2B4M6QE/378831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)
5 | S3 | 1 | E-Switch | TL3305AF260QG | SWITCH TACTILE SPST-NO 50MA 12V | SMD |  | Link (https://www.digikey.ca/en/products/detail/e-switch/TL3305AF260QG/5816184)
6 | J1-J9 | 9 | On Shore | OSTVN02A150 | 2 Position Terminal Block 2.54mm, Screw-In | Thru-Hole |  | Link (https://www.digikey.ca/en/products/detail/on-shore-technology-inc/OSTVN02A150/1588862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)
7 | J10 | 1 | CUI Devices | DCJ200-10-A-K1-K | Power Barrel Connector Jack | Thru-Hole |  | Link (https://www.digikey.ca/en/products/detail/gct/DCJ200-10-A-K1-K/9859579?gad_source=1)
8 | J11 | 1 | TE Connectivity | 7-534206-0 | Headers & Wire Housings,40 Pin, Female | Thru-Hole |  | Link (https://www.mouser.ca/ProductDetail/TE-Connectivity/7-534206-0?qs=mDUKaTHq%2BXZkXItnxDtoig%3D%3D)
9 | P1 | 1 | SparkFun | PRT-14275 | RASPBERRYPI GPIO MALE HEADER | Thru-Hole |  | Link (https://www.digikey.ca/en/products/detail/sparkfun-electronics/PRT-14275/7428264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)
10 | J12 | 1 | Sullins | PPPC041LGBN-RC | CONN HDR 4POS 0.1 GOLD PCB, FEMALE | Thru-Hole |  | Link (https://www.digikey.ca/en/products/detail/sullins-connector-solutions/PPPC041LFBN-RC/810176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)
11 | J13 | 1 | Sullins | PPPC021LFBN-RC | CONN HDR 2POS 0.1 GOLD PCB, FEMALE | Thru-Hole |  | Link (https://www.digikey.ca/en/products/detail/sullins-connector-solutions/PPPC021LFBN-RC/810174)
12 | J14, J15 | 2 | On Shore | OSTVN10A150 | TERM BLK 10P SIDE ENT 2.54MM, SCREW-IN | Thru-Hole |  | Link (https://www.digikey.ca/en/products/detail/on-shore-technology-inc/OSTVN10A150/1588870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)
13 | J16 | 1 | Wurth | 61300211121 | CONN HEADER VERT 2POS 2.54MM | Thru-Hole |  | Link (https://www.digikey.ca/en/products/detail/w%C3%BCrth-elektronik/61300211121/4846823)
14 | F3, F6 | 2 | Bel Fuse | C1Q 1.5 | FUSE BRD MT 1.5A 125VAC 63VDC | SMD | 1206 | Link (https://www.digikey.ca/en/products/detail/bel-fuse-inc/C1Q-1-5/615158?s=N4IgTCBcDaIMYEYCOBaBA6ArCAugXyA)
15 | F1,F2,F4,F5 | 4 | Bel Fuse | C1Q 2.5 | FUSE BRD MT 2.5A 125VAC 63VDC | SMD | 1206 | Link (https://www.digikey.ca/en/products/detail/bel-fuse-inc/C1Q-2-5/615152)
16 | D2 | 1 | Toshiba | CUS08F30,H3F | DIODE SCHOTTKY 30V 800MA USC | SMD | SOD-323 | Link (https://www.digikey.ca/en/products/detail/toshiba-semiconductor-and-storage/CUS08F30-H3F/5114298)
17 | U1 | 1 | Texas Instruments | LM2596 | IC REG BUCK 5V 3A DDPAK | SMD | LM2596SX-5.0/NOPB | Link (https://www.digikey.ca/en/products/detail/texas-instruments/LM2596SX-5-0-NOPB/334927)
18 | R1 | 1 | YAGEO | RC1218JK-071KL | RES 1K OHM 5% 1W 1812 WIDE | SMD | 1812 | Link (https://www.digikey.ca/en/products/detail/yageo/RC1218JK-071KL/5920849)
19 | R2 | 1 | YAGEO | RC1206JR-07300RL | RES 300 OHM 5% 1/4W 1206 | SMD | 1206 | Link (https://www.digikey.ca/en/products/detail/yageo/RC1206JR-07300RL/729275)
20 | C1 | 1 | Cornell | 687AVG025MGBJ | CAP ALUM POLY 680UF 20% 25V T/H | Thru-Hole |  | Link (https://www.digikey.ca/en/products/detail/cornell-dubilier-illinois-capacitor/687AVG025MGBJ/5413286)
21 | C2 | 1 | Kyocera Avx | TPME227K016R0025 | CAP TANT 220UF 10% 16V 2917 | SMD | 2917 | Link (https://www.digikey.ca/en/products/detail/kyocera-avx/TPME227K016R0025/929934)
22 | D1 | 1 | Diodes | B540C-13-F | DIODE SCHOTTKY 40V 5A SMC | SMD | DO-214AB | Link (https://www.digikey.ca/en/products/detail/diodes-incorporated/B540C-13-F/768771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)
23 | L1 | 1 | Coilcraft | MSS1210-333MED | Power Inductors, 33uH Shld 20% 5.9A 39mOhms | SMD
24 | U2 | 1 | Texas Insruments | TPS79633 | IC REG LINEAR 3.3V 1A SOT223-6 | SMD | TPS79633QDCQRQ1 | Link (https://www.digikey.ca/en/products/detail/texas-instruments/TPS79633QDCQRQ1/3431171)
25 | R3 | 1 | Stackpole | RMCF0603FT130R | RES 130 OHM 1% 1/10W 0603 | SMD | 1508 | Link (https://www.digikey.ca/en/products/detail/stackpole-electronics-inc/RMCF0603FT130R/1761271)
26 | C3, C5 | 2 | Murata | GRM155R60J225ME01 | CAP CER 2.2UF 6.3V X5R 0402 | SMD | 0402 | Link (https://www.digikey.ca/en/products/detail/murata-electronics/GRM155R60J225ME01D/10705507)
27 | C4 | 1 | Murata | GRM033R70J103KA01D | CAP CER 10000PF 6.3V X7R 0201 | SMD | 201 | Link (https://www.digikey.ca/en/products/detail/murata-electronics/GRM033R70J103KA01D/587251)
28 | NA | 1 | Raspberry Pi | RPI-0271 | Raspberry Pi Zero W | Header |  | Link (https://www.amazon.ca/dp/B06XFZC3BX?psc=1&ref=ppx_yo2ov_dt_b_product_details)
29 | NA | 1 | NXP | PN532 | NFC RFID Module NXP PN532 V3 Kit Read/Write | Header |  | Link (https://www.amazon.ca/gp/product/B083DY9F9K/ref=ppx_yo_dt_b_asin_title_o00_s00?ie=UTF8&psc=1)
30 | NA | 1 | Sparkfun | PRT-14275 | RASPBERRYPI GPIO MALE HEADER | Thru-Hole |  | Link (https://www.digikey.ca/en/products/detail/sparkfun-electronics/PRT-14275/7428264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)
31 | NA | 1 | Wurth | 61300211121 | CONN HEADER VERT 2POS 2.54MM | Thru-Hole |  | Link (https://www.digikey.ca/en/products/detail/w%C3%BCrth-elektronik/61300211121/4846823)
32 | NA | 1 | Wurth | 61300411121 | CONN HEADER VERT 4POS 2.54MM | Thru-Hole |  | Link (https://www.digikey.ca/en/products/detail/w%C3%BCrth-elektronik/61300411121/4846827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)
33 | NA | 1 | Gikfun | EK2107x2C | 9v Battery Holder with ON/Off Switch | External |  | Link (https://www.amazon.ca/Gikfun-Battery-Holder-Arduino-EK2107x2C/dp/B07G583G88)
34 | NA | 1 | ALITOVE | 61300211121 | 12V Power Supply 6A 72W AC to DC Adapter | External |  | Link (https://www.amazon.ca/Arkare-100V-240V-Security-Microphone-Receiver/dp/B0B51R6R2Y?s=electronics)
35 | NA | 1 | Wurth | 60900213421 | JUMPER W/TEST PNT 1X2PINS 2.54MMper | External

Sheet: PCB Pinout_Rev B
PCB Connector Pinouts
CONNECTOR | PIN # | DESCRIPTION | COMMENTS
J1 | 1 | +12V | 2A max current capability from 12V sources (J1 & J4 togethter)
 | 2 | GND
J2 | 1 | +5V | 2A max current capability from 5V sources (J2 & J5 togethter)
 | 2 | GND
J3 | 1 | +3V3 | 1A max current capability from 3.3V sources (J3 & J6 togethter)
 | 2 | GND
J4 | 1 | +12V | 2A max current capability from 12V sources (J1 & J4 togethter)
 | 2 | GND
J5 | 1 | +5V | 2A max current capability from 5V sources (J2 & J5 togethter)
 | 2 | GND
J6 | 1 | +3V3 | 1A max current capability from 3.3V sources (J3 & J6 togethter)
 | 2 | GND
J7 | 1 | GPIO 12 | PWM0
 | 2 | GND
J8 | 1 | GPIO 13 | PWM1
 | 2 | GND
J9 | 1 | GPIO 26 | General purpose I/O
 | 2 | GND
J10 | 1 | +12V | Positive power terminal
 | 2 | GND | Negative power terminal
J12 | 1 | GND
 | 2 | +3V3 | 5V-to-3V3 regulator output
 | 3 | GPIO 2 | SDA
 | 4 | GPIO 3 | SCL
J13 | 1 | Reset | J13 is connected to switch S2: press S2 to reset Raspberry Pi
 | 2
J14 | 1 | GPIO 2 | SDA, do not use simultaneously with J12
 | 2 | GPIO 3 | SCL, do not use simultaneously with J12
 | 3 | GPIO 17 | spi1 CS1
 | 4 | GND
 | 5 | GPIO 10 | MOSI
 | 6 | GPIO 9 | MISO
 | 7 | GPIO 11 | SCLK
 | 8 | GND
 | 9 | GPIO 19 | PWM1, miso1
 | 10 | GND
J15 | 1 | GPIO 14 | TXD
 | 2 | GPIO 15 | RXD
 | 3 | GPIO 18 | PWM0, spi1 CS0
 | 4 | GND
 | 5 | GPIO 8 | SPI CS0
 | 6 | GPIO 7 | SPI CS1
 | 7 | GPIO 16 | spi1 CS2
 | 8 | GPIO 20 | mosi1
 | 9 | GPIO 21 | sclk1
 | 10 | GND
J16 | 1 | +5V from Pi | Must remove jumper to connector J16 when Raspberry Pi is connected to USB
 | 2 | +5V from regulator
J11 | 1-40 | 40-pin GPIO (same pinouts as Raspberry Pi) | Raspberry Pi mounts to connector J11
P1 |  |  | Raspberry Pi breakouts, do not use simultaneously with J7, J8, J9, J12, J14, J15
Note: LED1, LED2, and LED3 indicate 12V, 5V, and 3.3V, respectively.

Sheet: Rev B_Updates
Reverse-polarity protection for battery terminals
make micro components bigger
separate power connector and switch more apart
put polarity (+, -) for the components
C3 writing not in the right place | done
D2 writing is not present | done
Test points need to be clippable
Change power jack (PJ-037A) with higher current ratings(DCJ200-10-A-K1-K), update foot print & traces | done
Fuse current rating needs to be updated for J1, J2, J3 | done
Fuse should be added for J4, J5, J6 | done

Sheet: BOM_Rev A
PCB Bill of Materials
Item | Ref Des | Qty | Manufacturer | Mfg Part # | Description | Type | Package
1 | Q1-Q3 | 3 | Alpha & Omega | AOD442G | MOSFET N-CH 30V 9.5A 8-SOIC | SMD | TO-252 | Link (https://www.digikey.ca/en/products/detail/alpha-omega-semiconductor-inc/AOD442G/11567435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)
2 | R4- R6 | 3 | Stackpole | RMCF0603FT100R | RES 100 OHM 1% 1/10W 0603 | SMD | 1608 | Link (https://www.digikey.ca/en/products/detail/stackpole-electronics-inc/RMCF0603FT100R/1761113)
3 | LED1-LED3 | 3 | VCC | LSM0805452V | LED SM 0805 2V 35MCD GREEN | SMD | 0805 | Link (https://www.digikey.ca/en/products/detail/visual-communications-company-vcc/LSM0805452V/10229612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)
4 | S1 | 1 | E-Switch | 100SP1T2B4M6QE | SWITCH TOGGLE SPDT 5A 120V | Thru-Hole |  | Link (https://www.digikey.ca/en/products/detail/e-switch/100SP1T2B4M6QE/378831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)
5 | S3 | 1 | E-Switch | TL3305AF260QG | SWITCH TACTILE SPST-NO 50MA 12V | SMD |  | Link (https://www.digikey.ca/en/products/detail/e-switch/TL3305AF260QG/5816184)
6 | J1-J9 | 9 | On Shore | OSTVN02A150 | 2 Position Terminal Block 2.54mm, Screw-In | Thru-Hole |  | Link (https://www.digikey.ca/en/products/detail/on-shore-technology-inc/OSTVN02A150/1588862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)
7 | J10 | 1 | CUI Devices | PJ-037A | CONN PWR JACK 2X5.5MM SOLDER | Thru-Hole |  | Link (https://www.digikey.ca/en/products/detail/cui-devices/PJ-037A/1644545)
8 | J11 | 1 | TE Connectivity | 7-534206-0 | Headers & Wire Housings,40 Pin, Female | Thru-Hole |  | Link (https://www.mouser.ca/ProductDetail/TE-Connectivity/7-534206-0?qs=mDUKaTHq%2BXZkXItnxDtoig%3D%3D)
9 | P1 | 1 | SparkFun | PRT-14275 | RASPBERRYPI GPIO MALE HEADER | Thru-Hole |  | Link (https://www.digikey.ca/en/products/detail/sparkfun-electronics/PRT-14275/7428264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)
10 | J12 | 1 | Sullins | PPPC041LGBN-RC | CONN HDR 4POS 0.1 GOLD PCB, FEMALE | Thru-Hole |  | Link (https://www.digikey.ca/en/products/detail/sullins-connector-solutions/PPPC041LFBN-RC/810176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)
11 | J13 | 1 | Sullins | PPPC021LFBN-RC | CONN HDR 2POS 0.1 GOLD PCB, FEMALE | Thru-Hole |  | Link (https://www.digikey.ca/en/products/detail/sullins-connector-solutions/PPPC021LFBN-RC/810174)
12 | J14, J15 | 2 | On Shore | OSTVN10A150 | TERM BLK 10P SIDE ENT 2.54MM, SCREW-IN | Thru-Hole |  | Link (https://www.digikey.ca/en/products/detail/on-shore-technology-inc/OSTVN10A150/1588870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)
13 | J16 | 1 | Wurth | 61300211121 | CONN HEADER VERT 2POS 2.54MM | Thru-Hole |  | Link (https://www.digikey.ca/en/products/detail/w%C3%BCrth-elektronik/61300211121/4846823)
14 | F2,F3 | 2 | Bel Fuse | C1Q 1.5 | FUSE BRD MT 1.5A 125VAC 63VDC | SMD | 1206 | Link (https://www.digikey.ca/en/products/detail/bel-fuse-inc/C1Q-1-5/615158?s=N4IgTCBcDaIMYEYCOBaBA6ArCAugXyA)
15 | F1 | 1 | Bel Fuse | C1Q 2.5 | FUSE BRD MT 2.5A 125VAC 63VDC | SMD | 1206 | Link (https://www.digikey.ca/en/products/detail/bel-fuse-inc/C1Q-2-5/615152)
16 | D2 | 1 | Toshiba | CUS08F30,H3F | DIODE SCHOTTKY 30V 800MA USC | SMD | SOD-323 | Link (https://www.digikey.ca/en/products/detail/toshiba-semiconductor-and-storage/CUS08F30-H3F/5114298)
17 | U1 | 1 | Texas Instruments | LM2596 | IC REG BUCK 5V 3A DDPAK | SMD | LM2596SX-5.0/NOPB | Link (https://www.digikey.ca/en/products/detail/texas-instruments/LM2596SX-5-0-NOPB/334927)
18 | R1 | 1 | YAGEO | RC1218JK-071KL | RES 1K OHM 5% 1W 1812 WIDE | SMD | 1812 | Link (https://www.digikey.ca/en/products/detail/yageo/RC1218JK-071KL/5920849)
19 | R2 | 1 | YAGEO | RC1206JR-07300RL | RES 300 OHM 5% 1/4W 1206 | SMD | 1206 | Link (https://www.digikey.ca/en/products/detail/yageo/RC1206JR-07300RL/729275)
20 | C1 | 1 | Cornell | 687AVG025MGBJ | CAP ALUM POLY 680UF 20% 25V T/H | Thru-Hole |  | Link (https://www.digikey.ca/en/products/detail/cornell-dubilier-illinois-capacitor/687AVG025MGBJ/5413286)
21 | C2 | 1 | Kyocera Avx | TPME227K016R0025 | CAP TANT 220UF 10% 16V 2917 | SMD | 2917 | Link (https://www.digikey.ca/en/products/detail/kyocera-avx/TPME227K016R0025/929934)
22 | D1 | 1 | Diodes | B540C-13-F | DIODE SCHOTTKY 40V 5A SMC | SMD | DO-214AB | Link (https://www.digikey.ca/en/products/detail/diodes-incorporated/B540C-13-F/768771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)
23 | L1 | 1 | Coilcraft | MSS1210-333MED | Power Inductors, 33uH Shld 20% 5.9A 39mOhms | SMD
24 | U2 | 1 | Texas Insruments | TPS79633 | IC REG LINEAR 3.3V 1A SOT223-6 | SMD | TPS79633QDCQRQ1 | Link (https://www.digikey.ca/en/products/detail/texas-instruments/TPS79633QDCQRQ1/3431171)
25 | R3 | 1 | Stackpole | RMCF0603FT130R | RES 130 OHM 1% 1/10W 0603 | SMD | 1508 | Link (https://www.digikey.ca/en/products/detail/stackpole-electronics-inc/RMCF0603FT130R/1761271)
26 | C3, C5 | 2 | Murata | GRM155R60J225ME01 | CAP CER 2.2UF 6.3V X5R 0402 | SMD | 0402 | Link (https://www.digikey.ca/en/products/detail/murata-electronics/GRM155R60J225ME01D/10705507)
27 | C4 | 1 | Murata | GRM033R70J103KA01D | CAP CER 10000PF 6.3V X7R 0201 | SMD | 201 | Link (https://www.digikey.ca/en/products/detail/murata-electronics/GRM033R70J103KA01D/587251)
28 | NA | 1 | Raspberry Pi | RPI-0271 | Raspberry Pi Zero W | Header |  | Link (https://www.amazon.ca/dp/B06XFZC3BX?psc=1&ref=ppx_yo2ov_dt_b_product_details)
29 | NA | 1 | NXP | PN532 | NFC RFID Module NXP PN532 V3 Kit Read/Write | Header |  | Link (https://www.amazon.ca/gp/product/B083DY9F9K/ref=ppx_yo_dt_b_asin_title_o00_s00?ie=UTF8&psc=1)
30 | NA | 1 | Sparkfun | PRT-14275 | RASPBERRYPI GPIO MALE HEADER | Thru-Hole |  | Link (https://www.digikey.ca/en/products/detail/sparkfun-electronics/PRT-14275/7428264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)
31 | NA | 1 | Wurth | 61300211121 | CONN HEADER VERT 2POS 2.54MM | Thru-Hole |  | Link (https://www.digikey.ca/en/products/detail/w%C3%BCrth-elektronik/61300211121/4846823)
32 | NA | 1 | Wurth | 61300411121 | CONN HEADER VERT 4POS 2.54MM | Thru-Hole |  | Link (https://www.digikey.ca/en/products/detail/w%C3%BCrth-elektronik/61300411121/4846827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)
33 | NA | 1 | Gikfun | EK2107x2C | 9v Battery Holder with ON/Off Switch | External |  | Link (https://www.amazon.ca/Gikfun-Battery-Holder-Arduino-EK2107x2C/dp/B07G583G88)
34 | NA | 1 | ALITOVE | 61300211121 | 12V Power Supply 6A 72W AC to DC Adapter | External |  | Link (https://www.amazon.ca/Arkare-100V-240V-Security-Microphone-Receiver/dp/B0B51R6R2Y?s=electronics)
35 | NA | 1 | Wurth | 60900213421 | JUMPER W/TEST PNT 1X2PINS 2.54MMper | External

Sheet: SPEC_Rev A
Iterm | P/N | Mount Type | Supply Voltage | Supply Current | Current Capacity | Power Rating | Supplier | Qty | Packaging | Manufacture | Schematic? | Symbol | Purchased?
Pi Zero W | RPI-0271 | Header | 5V | 150mA | 50mA - 150mA (3.3V pin & GPIOs) |  | Link (https://www.amazon.ca/dp/B06XFZC3BX?psc=1&ref=ppx_yo2ov_dt_b_product_details) | 1 |  |  | N/A |  | YES
NFC | PN532 | Header | 3.3V - 5V | 40mA | up to 1.2A (5V pin) |  | Link (https://www.amazon.ca/gp/product/B083DY9F9K/ref=ppx_yo_dt_b_asin_title_o00_s00?ie=UTF8&psc=1) | 1 |  |  | N/A |  | YES
IR | GP2Y0E03 | Wire | 2.7V - 5.5V (IO supply voltage: 1.8V - 3.3V) | 36mA |  |  |  | 1 |  |  | N/A |  | Not Used
PIR | NCS36000 | Wire | 3V - 5.75V | 50uA |  |  |  | 1 |  |  | N/A |  | Not Used
40-Pin Male Header for Pi | PRT-14275 | Through-Hole |  |  |  |  | Link (https://www.digikey.ca/en/products/detail/sparkfun-electronics/PRT-14275/7428264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) | 1 |  | Sparkfun | N/A |  | YES
2-Pin Male Header for Run |  | Through-Hole |  |  |  |  | Link (https://www.digikey.ca/en/products/detail/w%C3%BCrth-elektronik/61300211121/4846823) | 1 |  | Wurth | N/A |  | YES
4-Pin Male Header for NFC | 61300411121 | Through-Hole |  |  |  |  | Link (https://www.digikey.ca/en/products/detail/w%C3%BCrth-elektronik/61300411121/4846827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) | 1 |  | Wurth | N/A |  | YES
9V Battery Holder | EK2107x2C | External |  |  |  |  | Link (https://www.amazon.ca/Gikfun-Battery-Holder-Arduino-EK2107x2C/dp/B07G583G88) | 1 |  | Gikfun | N/A |  | YES
12V Power Adapter | 61300211121 | External |  |  |  |  | Link (https://www.amazon.ca/dp/B082PCR5YS?psc=1&ref=ppx_yo2ov_dt_b_product_details) | 1 |  | Arkare | N/A |  | YES
5V USB Bypass Jumper | 60900213421 |  |  |  |  |  | Link (https://www.digikey.ca/en/products/detail/w%C3%BCrth-elektronik/60900213421/2508447?productid=2508447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) | 1 |  | Wurth
MOSFET | AOD442G | Surface | VDS = 60V | ID = 25.5A (@100 °C) |  |  | Link (https://www.digikey.ca/en/products/detail/alpha-omega-semiconductor-inc/AOD442G/11567435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) | 3 | TO-252 | Alpha & Omega | YES | Q1, Q2, Q3 | YES
100 Ohm Resistor | RMCF0603FT100R | Surface |  |  |  |  | Link (https://www.digikey.ca/en/products/detail/stackpole-electronics-inc/RMCF0603FT100R/1761113) | 3 | 1608 | Stackpole | YES | R4, R5, R6 | YES
LED Indicator | LSM0805452V | Surface | 2V | 20mA |  |  | Link (https://www.digikey.ca/en/products/detail/visual-communications-company-vcc/LSM0805452V/10229612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) | 3 |  | VCC | YES | LED1, LED2, LED3 | YES
Power Selector Sw | 100SP1T2B4M6QE | Through-Hole | 120VAC/28VDC | 5A (AC/DC) |  |  | Link (https://www.digikey.ca/en/products/detail/e-switch/100SP1T2B4M6QE/378831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) | 1 |  | E-Switch | YES | S1 | YES
Run Sw | TL3305AF260QG | Surface |  |  |  |  | Link (https://www.digikey.ca/en/products/detail/e-switch/TL3305AF260QG/5816184) | 1 | SMD-4 | E-Switch | YES | S3 | YES
2-Pin Screw-In Output Connector | OSTVN02A150 | Through-Hole | 125V | 6A |  |  | Link (https://www.digikey.ca/en/products/detail/on-shore-technology-inc/OSTVN02A150/1588862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) | 9 |  |  | YES | J1, J2…J9 | YES
12V & 9V Power Adapter Connector | PJ-037A | Through-Hole | 12V | 5A |  |  | Link (https://www.digikey.ca/en/products/detail/cui-devices/PJ-037A/1644545) | 1 |  |  | YES | J10 | YES
40-Pin Female Header for Pi | 7-534206-0 | Through-Hole |  |  |  |  | Link (https://www.mouser.ca/ProductDetail/TE-Connectivity/7-534206-0?qs=mDUKaTHq%2BXZkXItnxDtoig%3D%3D) | 1 |  | TE Connectivity | YES | J11 | YES
40-Pin Male Header for Pi | PRT-14275 | Through-Hole |  |  |  |  | Link (https://www.digikey.ca/en/products/detail/sparkfun-electronics/PRT-14275/7428264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) | 1 |  |  | YES | P1 | YES
4-Pin Female Header for NFC | PPPC041LGBN-RC | Through-Hole |  |  |  |  | Link (https://www.digikey.ca/en/products/detail/sullins-connector-solutions/PPPC041LFBN-RC/810176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) | 1 |  | Sullins | YES | J12 | YES
2-Pin Female Header for Run | PPPC021LFBN-RC | Through-Hole |  |  |  |  | Link (https://www.digikey.ca/en/products/detail/sullins-connector-solutions/PPPC021LFBN-RC/810174) | 1 |  | Sullins | YES | J13
10-Pin Header for Com | OSTVN10A150 | Through-Hole |  |  |  |  | Link (https://www.digikey.ca/en/products/detail/on-shore-technology-inc/OSTVN10A150/1588870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) | 2 |  | On Shore | YES | J14, J15 | YES
2-Pin Male Header 5V Isolation | 61300211121 | Through-Hole |  |  |  |  | Link (https://www.digikey.ca/en/products/detail/w%C3%BCrth-elektronik/61300211121/4846823) | 1 |  | Wurth | YES | J16 | YES
1.5A Fuse | C1Q 1.5 | Surface |  |  |  |  | Link (https://www.digikey.ca/en/products/detail/bel-fuse-inc/C1Q-1-5/615158?s=N4IgTCBcDaIMYEYCOBaBA6ArCAugXyA) | 2 | 1206 | Bel Fuse | YES | F2,F3 | YES
2.5A Fuse | C1Q 2.5 | Surface |  |  |  |  | Link (https://www.digikey.ca/en/products/detail/bel-fuse-inc/C1Q-2-5/615152) | 1 | 1206 | Bel Fuse | YES | F1 | YES
Schottky diode | CUS08F30,H3F | Surface |  |  |  |  | Link (https://www.digikey.ca/en/products/detail/toshiba-semiconductor-and-storage/CUS08F30-H3F/5114298) | 1 | SOD-323 | Toshiba |  | D2 | YES
12V-to-5V Regulator | LM2596 | Surface | 4.5V - 40V |  | 3A (@ Vin = 12V) |  | Link (https://www.digikey.ca/en/products/detail/texas-instruments/LM2596SX-5-0-NOPB/334927) | 1 | LM2596SX-5.0/NOPB |  | YES | U1 | YES
1000 Ohm Resistor | RC1218JK-071KL | Surface |  |  | 6A | 1W | Link (https://www.digikey.ca/en/products/detail/yageo/RC1218JK-071KL/5920849) | 1 | 1812 | YAGEO | YES | R1 | YES
300 Ohm Resistor | RC1206JR-07300RL | Surface |  |  |  | 0.25W | Link (https://www.digikey.ca/en/products/detail/yageo/RC1206JR-07300RL/729275) | 1 | 1206 | YAGEO | YES | R2 | YES
680 uF Capacitor | 687AVG025MGBJ | Through-Hole |  |  |  |  | Link (https://www.digikey.ca/en/products/detail/cornell-dubilier-illinois-capacitor/687AVG025MGBJ/5413286) | 1 |  | Cornell | YES | C1 | YES
220 uF Capacitor | TPME227K016R0025 | Surface |  |  |  |  | Link (https://www.digikey.ca/en/products/detail/kyocera-avx/TPME227K016R0025/929934) | 1 |  | Kyocera Avx | YES | C2 | YES
Schottky diode | B540C-13-F | Surface |  |  |  |  | Link (https://www.digikey.ca/en/products/detail/diodes-incorporated/B540C-13-F/768771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) | 1 |  | Diodes | YES | D1 | YES
Power inductor | MSS1210-333MED | Surface |  |  |  |  | Link (https://www.mouser.ca/ProductDetail/Coilcraft/MSS1210-333MED?qs=zCSbvcPd3pYfSbsW0sApcA%3D%3D) | 1 |  |  |  | L1 | YES
5V-to-3.3V Regulator | TPS79633 | Surface | 2.7 - 5.5V |  | 1A |  | Link (https://www.digikey.ca/en/products/detail/texas-instruments/TPS79633QDCQRQ1/3431171) | 1 | TPS79633QDCQRQ1 |  | YES | U2 | YES
130 Ohm Resistor | RMCF0603FT130R | Surface |  |  |  |  | Link (https://www.digikey.ca/en/products/detail/stackpole-electronics-inc/RMCF0603FT130R/1761271) | 1 | 1508 | Stackpole | YES | R3 | YES
2.2 uF Capacitor | GRM155R60J225ME01 | Surface |  |  |  |  | Link (https://www.digikey.ca/en/products/detail/murata-electronics/GRM155R60J225ME01D/10705507) | 2 | 402 | Murata | YES | C3, C5 | YES
10 nF Capacitor | GRM033R70J103KA01D | Surface |  |  |  |  | Link (https://www.digikey.ca/en/products/detail/murata-electronics/GRM033R70J103KA01D/587251) | 1 |  | Murata | YES | C4 | YES

Sheet: PCB Pinout_Rev A
PCB Connector Pinouts
CONNECTOR | PIN # | DESCRIPTION | COMMENTS
J1 | 1 | +12V | Max 2A, with 2.5A fuse protection
 | 2 | GND
J2 | 1 | +5V | Max 1A, with 1.5A fuse protection
 | 2 | GND
J3 | 1 | +3V3 | Max 0.5A, with 1.5A fuse protection
 | 2 | GND
J4 | 1 | +12V | 12VDC adaptor output (can use 9-12V source), J4 is connected to switch S1 to turn power on/off
 | 2 | GND
J5 | 1 | +5V | 12V-to-5V regulator output, 3A output load current
 | 2 | GND
J6 | 1 | +3V3 | 5V-to-3V3 regulator output, 1A output load current
 | 2 | GND
J7 | 1 | GPIO 12 | PWM0
 | 2 | GND
J8 | 1 | GPIO 13 | PWM1
 | 2 | GND
J9 | 1 | GPIO 26 | General purpose I/O
 | 2 | GND
J10 | 1 | +12V | Positive power terminal
 | 2 | GND | Negative power terminal
J12 | 1 | GND
 | 2 | +3V3 | 5V-to-3V3 regulator output
 | 3 | GPIO 2 | SDA
 | 4 | GPIO 3 | SCL
J13 | 1 | Reset | J13 is connected to switch S2: press S2 to reset Raspberry Pi
 | 2
J14 | 1 | GPIO 2 | SDA, do not use simultaneously with J12
 | 2 | GPIO 3 | SCL, do not use simultaneously with J12
 | 3 | GPIO 17 | spi1 CS1
 | 4 | GND
 | 5 | GPIO 10 | MOSI
 | 6 | GPIO 9 | MISO
 | 7 | GPIO 11 | SCLK
 | 8 | GND
 | 9 | GPIO 19 | PWM1, miso1
 | 10 | GND
J15 | 1 | GPIO 14 | TXD
 | 2 | GPIO 15 | RXD
 | 3 | GPIO 18 | PWM0, spi1 CS0
 | 4 | GND
 | 5 | GPIO 8 | SPI CS0
 | 6 | GPIO 7 | SPI CS1
 | 7 | GPIO 16 | spi1 CS2
 | 8 | GPIO 20 | mosi1
 | 9 | GPIO 21 | sclk1
 | 10 | GND
J16 | 1 | +5V from Pi | Must remove jumper to connector J16 when Raspberry Pi is connected to USB
 | 2 | +5V from regulator
J11 | 1-40 | 40-pin GPIO (same pinouts as Raspberry Pi) | Raspberry Pi mounts to connector J11
P1 |  |  | Raspberry Pi breakouts, do not use simultaneously with J7, J8, J9, J12, J14, J15
Note: LED1, LED2, and LED3 indicate 12V, 5V, and 3.3V, respectively.

Sheet: Calculation
Iterm | P/N | RDS(ON) [ohm] | TJ(MAX) [°C] | TA [°C] | RθJA [°C/W] | Load current draw [A] | Load pwr dissipation [W] | Max pwr dissipation without heatsink [W]
MOSFET | AOD442G | 0.023 | 150 | 25 | 50 | 2 | 0.092 | 2.5
Iterm | P/N | LED Forward Current [A] | Half Forward Current | LED Forward Voltage [V] | Supply Voltage [V] | Resistance Needed [ohm] | Power Dissapation through R [W] | Resistor's Required Power Rating [W]
LED | LSM0805452V | 0.02 | 0.01 | 2 | 12 | 1000 | 0.1 | 0.5
LED | LSM0805452V | 0.02 | 0.01 | 2 | 5 | 300 | 0.03 | 0.15
LED | LSM0805452V | 0.02 | 0.01 | 2 | 3.3 | 130 | 0.013 | 0.065
 | Supply Voltage [V] | Forward Voltage [V] | Half Forward Current [A] | Resistance [Ω] | Power Dissapation [W] | Power Rating [W]
 | 12 | 2 | 0.01 | 1000 | 0.1 | 0.5
 | 5 | 2 | 0.01 | 300 | 0.03 | 0.15
 | 3.3 | 2 | 0.01 | 130 | 0.013 | 0.065

Sheet: Design Consideration
Component | Pin Num | Pin Name | Via | Thermal Via | Trace Thickness | Copper Pour Thickness | Comment
GND PLANE |  |  |  |  |  | 2 oz
U1 | 1 | VIN |  |  | LARGE
U1, U2 |  | GND |  | LARGE | LARGE
Q1, Q2, Q3 |  | GND |  | LARGE | LARGE
U1, U2 |  | I/P, O/P | LARGE |  | LARGE
12V, 5V, 3V3 |  | I/P, O/P | LARGE |  | LARGE
Q1, Q2, Q3 |  | I/P, O/P | LARGE |  | LARGE
S1 |  | I/P, O/P | LARGE |  | LARGE
Calculate trace thickness based on current (https://www.4pcb.com/trace-width-calculator.html)
Calculate via size (https://saturnpcb.com/saturn-pcb-toolkit/)

Sheet: Connector Assignment
CONNECTOR | PIN NUM | ASSIGNMENT
J7 | 1 | GPIO 12
 | 2 | GND
J8 | 1 | GPIO 13
 | 2 | GND
J9 | 1 | GPIO 26
 | 2 | GND
J14 | 1 | GPIO 2
 | 2 | GPIO 3
 | 3 | GPIO 17
 | 4 | GND
 | 5 | GPIO 10
 | 6 | GPIO 9
 | 7 | GPIO 11
 | 8 | GND
 | 9 | GPIO 19
 | 10 | GND
J15 | 1 | GPIO 14
 | 2 | GPIO 15
 | 3 | GPIO 18
 | 4 | GND
 | 5 | GPIO 8
 | 6 | GPIO 7
 | 7 | GPIO 16
 | 8 | GPIO 20
 | 9 | GPIO 21
 | 10 | GND
J12 | 1 | GND
 | 2 | 3V3
 | 3 | GPIO 2
 | 4 | GPIO 3

Sheet: Raspberry-Pi Pinout
Raspbarry Pi
 | Raspberry Pi Documentation - Raspberry Pi hardware (https://www.raspberrypi.com/documentation/computers/raspberry-pi.html)
 | PN532 - NFC RFID Module
https://microcontrollerslab.com/pn532-nfc-rfid-module-pinout-arduino-interfacing-applications/
 | GP2Y0E03 - IR Range Sensor (Sharp) - 4cm to 50cm
 | GP2Y0E03 Sharp Microelectronics | Mouser Canada (https://www.mouser.ca/ProductDetail/Sharp-Microelectronics/GP2Y0E03?qs=2FIyTMJ0hNk7Anrxo3D7Gw%3D%3D)
 | NCS36000 - Passive Infrared (PIR) Detector Controller

Sheet: Schedule
Date | Oct 2- 8 | Oct 9 - 15 | Oct 16 - 22 | Oct 23 - 29 | Oct 30 - Nov 5
Task 1 | Diptrace schematic | Gaber file | Order PCB | Test components | Assemble the board
Task 2 | Simulate circuit in P-Spice |  |  | Protoype the board | Test the board
Task 3 |  |  |  | Develop data sheet
