amber-sile-yang/Pi-Hub-PCB/Rev A/Test_Rev A/5V Ripple_1A Load.jpg

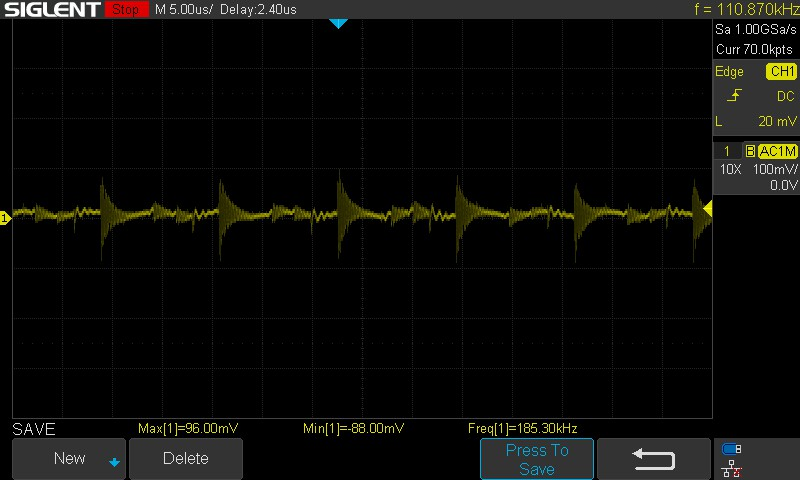
Rev A/Test_Rev A/5V Ripple_1A Load.jpg
