amber-sile-yang/Pi-Hub-PCB/Rev A/History/pcb pic - Copy.pdf

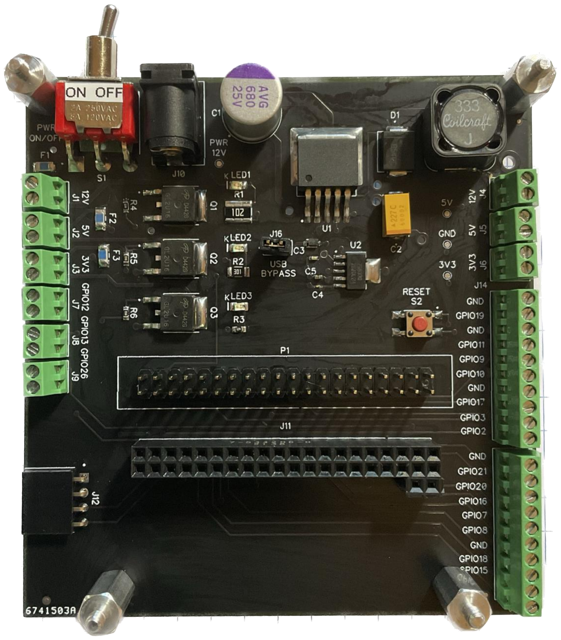
[picture p31: figure]
