amber-sile-yang/Pi-Hub-PCB/Rev A/3D Model_Rev A/History/History/Pi-Hub PCB_3D Model_ver03_view3.png

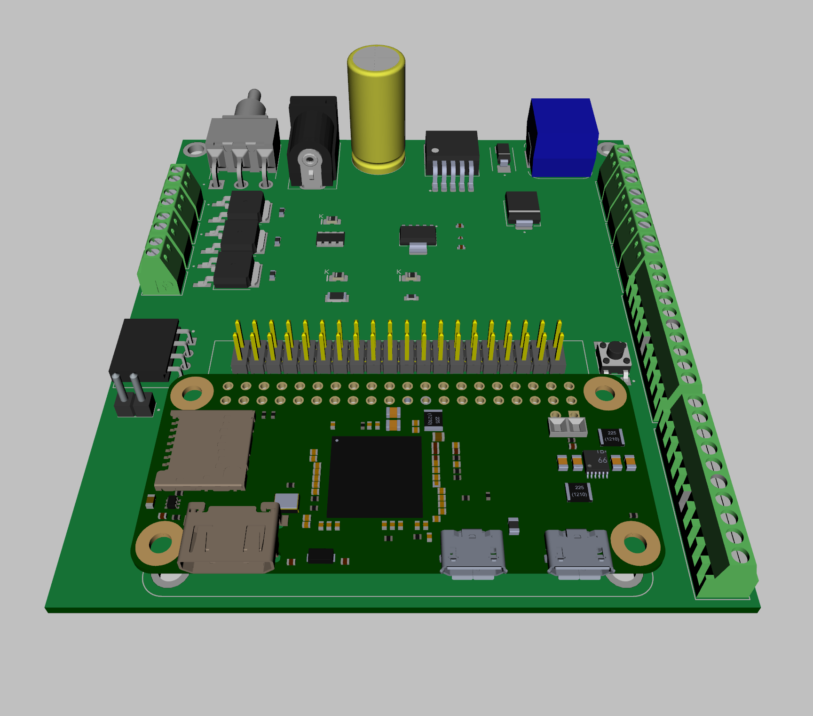
Rev A/3D Model_Rev A/History/History/Pi-Hub PCB_3D Model_ver03_view3.png
