amber-sile-yang/Pi-Hub-PCB/Rev A/3D Model_Rev A/History/Pi-Hub PCB_3D_2.png

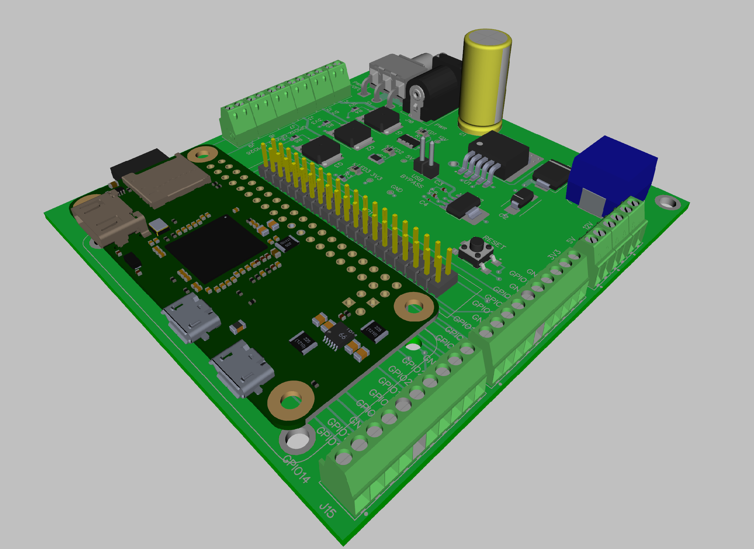
Rev A/3D Model_Rev A/History/Pi-Hub PCB_3D_2.png
