amber-sile-yang/Pi-Hub-PCB/Rev A/History/Screenshot 2023-10-14 135401.png

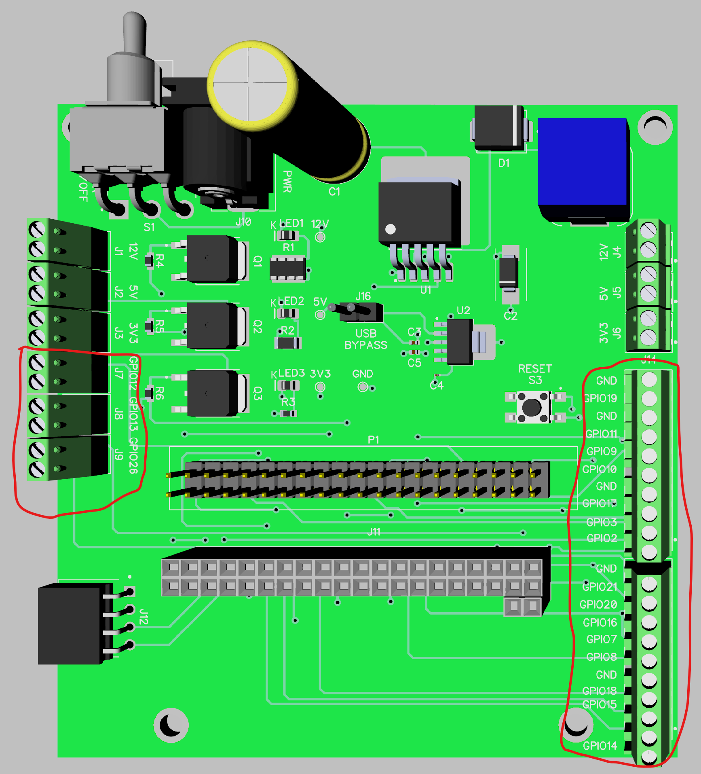
Rev A/History/Screenshot 2023-10-14 135401.png
