amber-sile-yang/Pi-Hub-PCB/Rev A/History/Pi-Hub Schematic_v06.pdf

J11

J16 | J14 | J15 GND GND

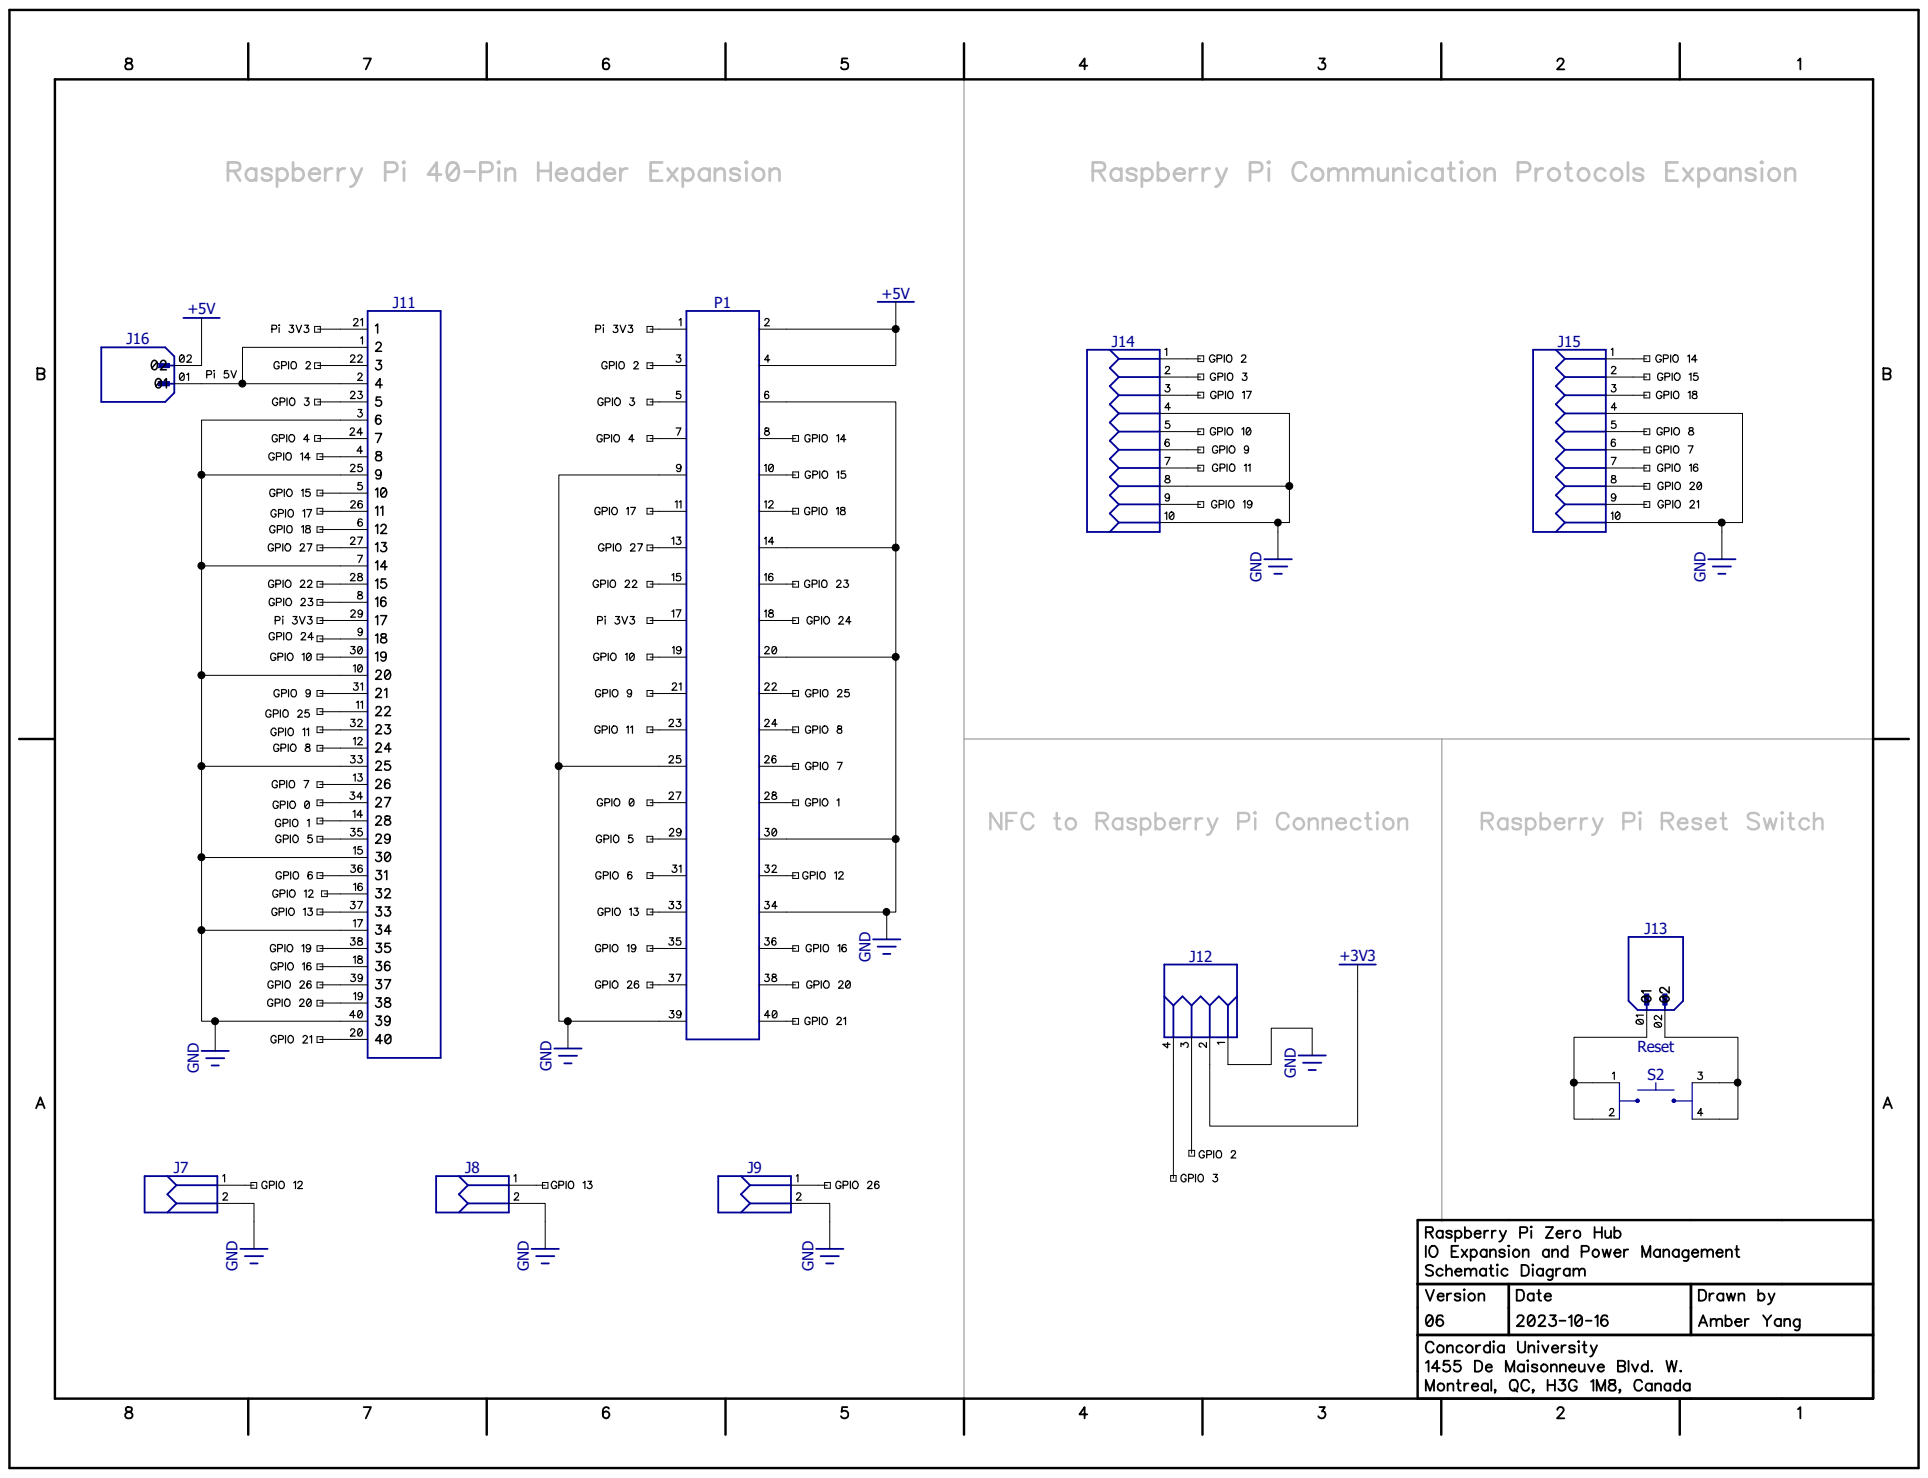
[picture p39: page 1]
Reset; GND GND; GND GND GND; GND

+12V | +5V | +5V | +3V3 GND
U2

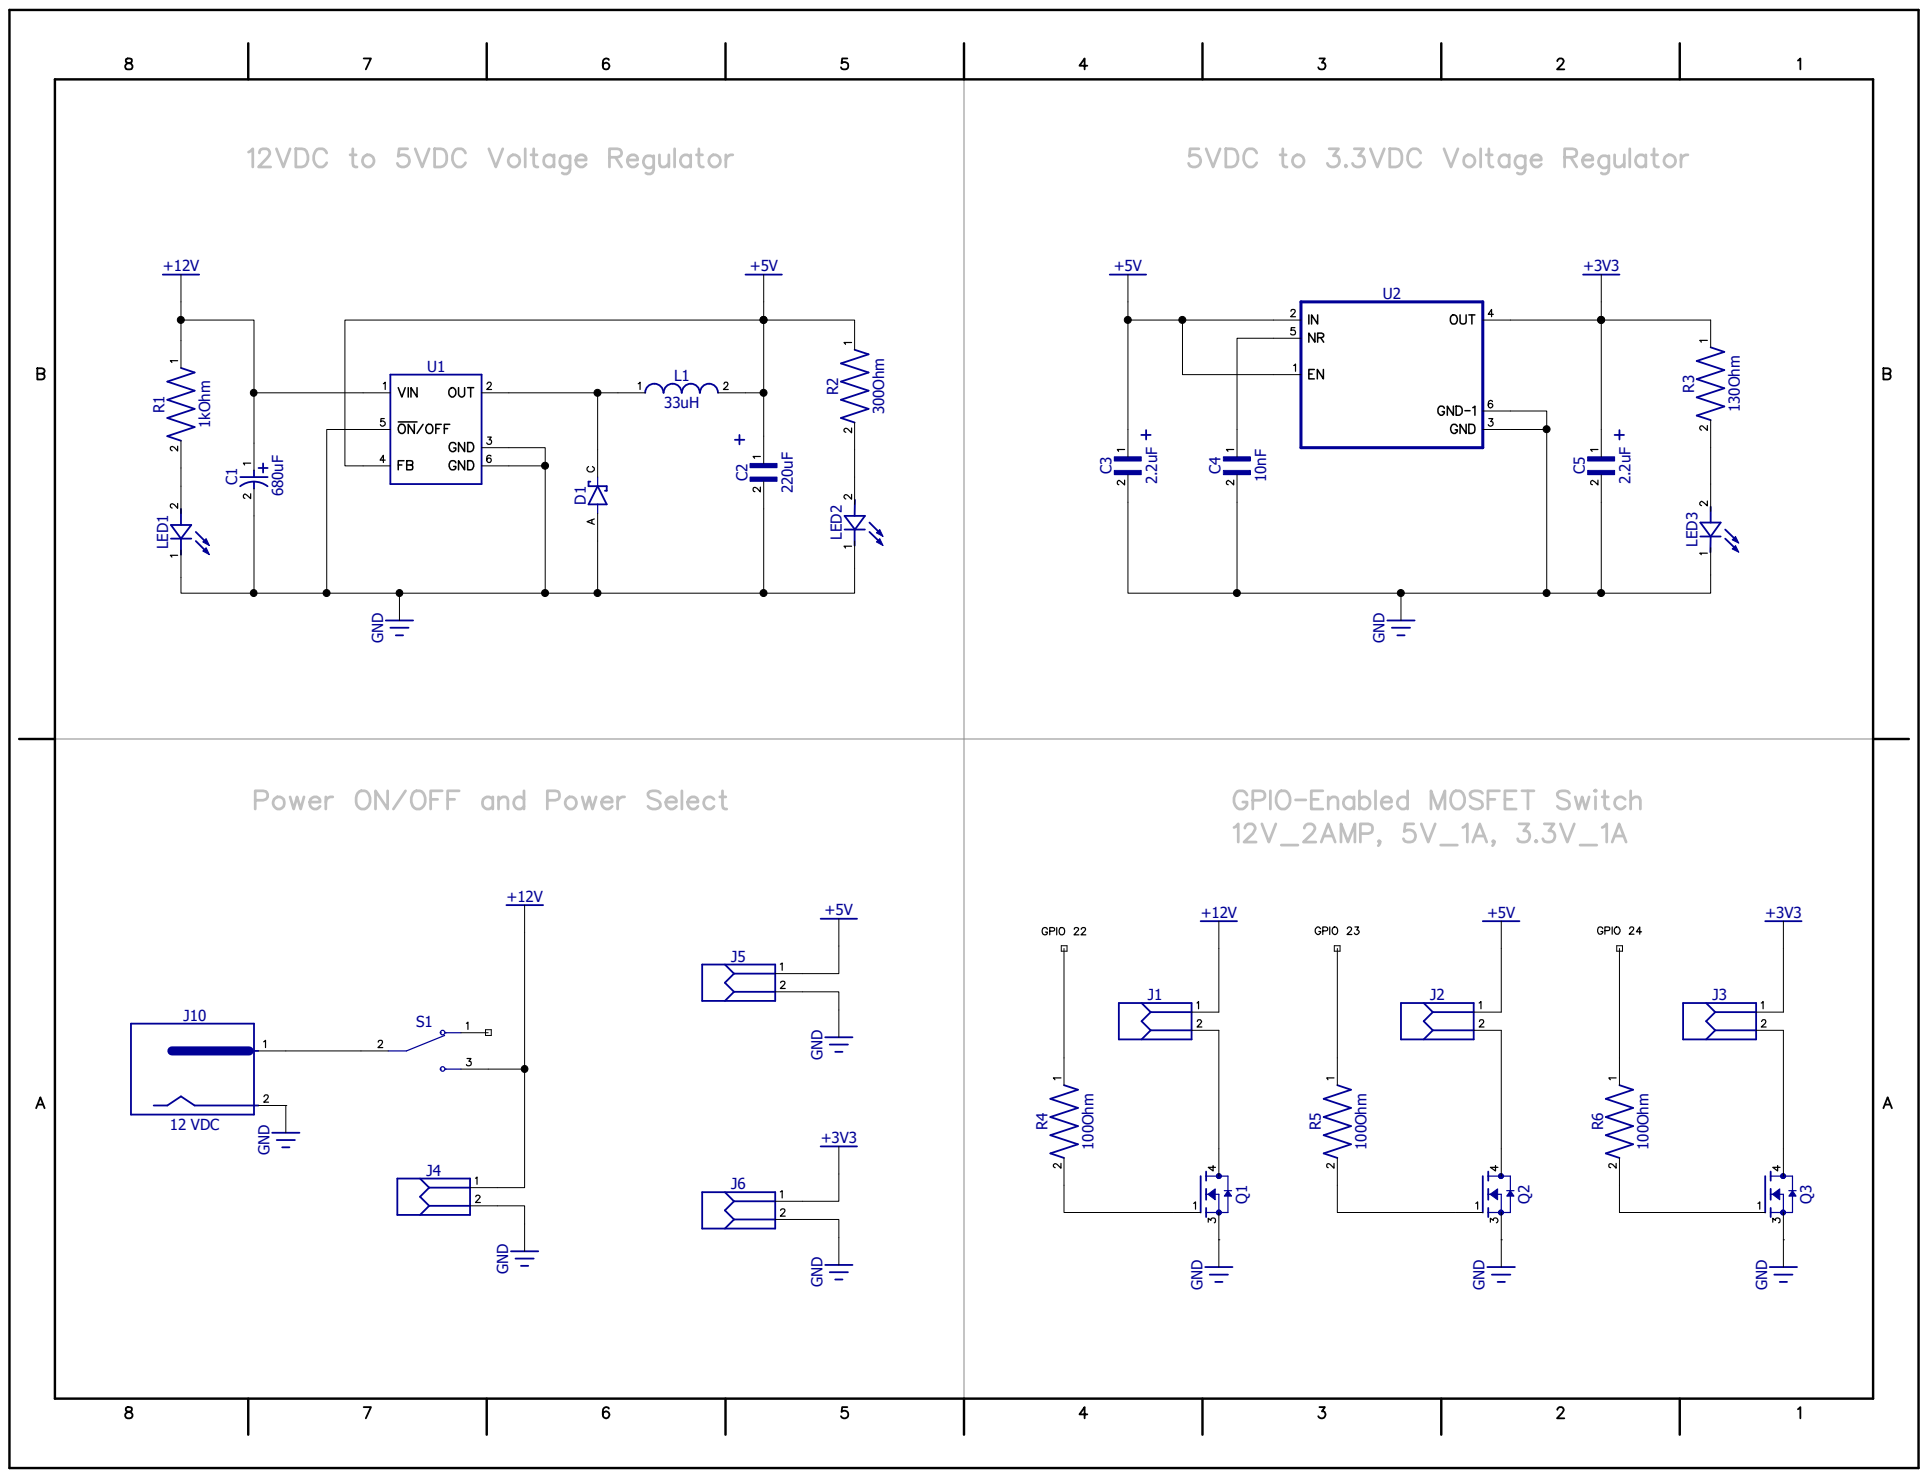
[picture p40: page 2]
