amber-sile-yang/Pi-Hub-PCB/Rev A/History/Pi-Hub PCB Layout_Rev--.pdf

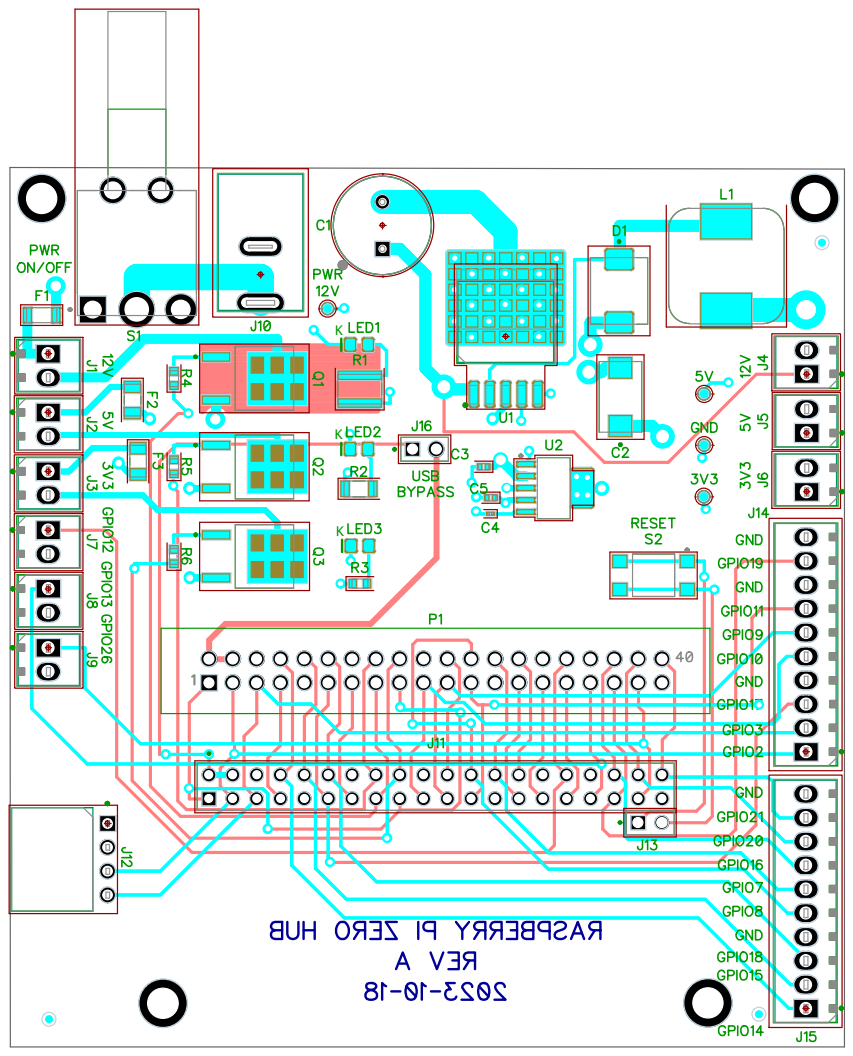
[picture p41: page 1]
KKK
