amber-sile-yang/Pi-Hub-PCB/Rev A/History/Pi-Hub PCB_Block Diagram_ver00_Markup.pdf

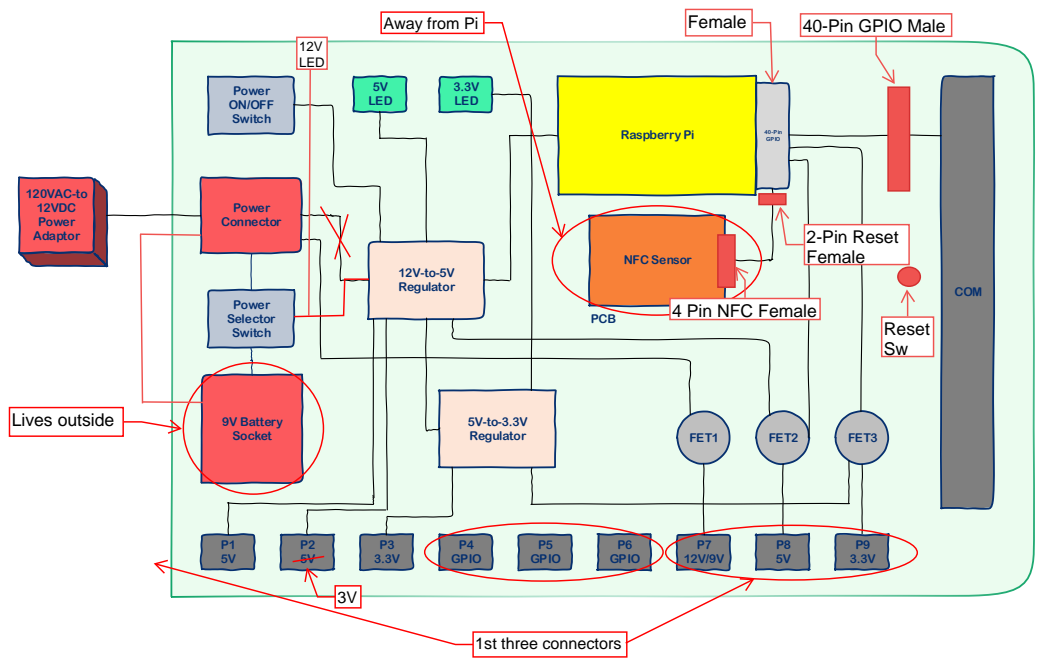
[picture p42: page 1]
