amber-sile-yang/Pi-Hub-PCB/Rev A/History/Pi-Hub PCB_Rev A_Layout.pdf

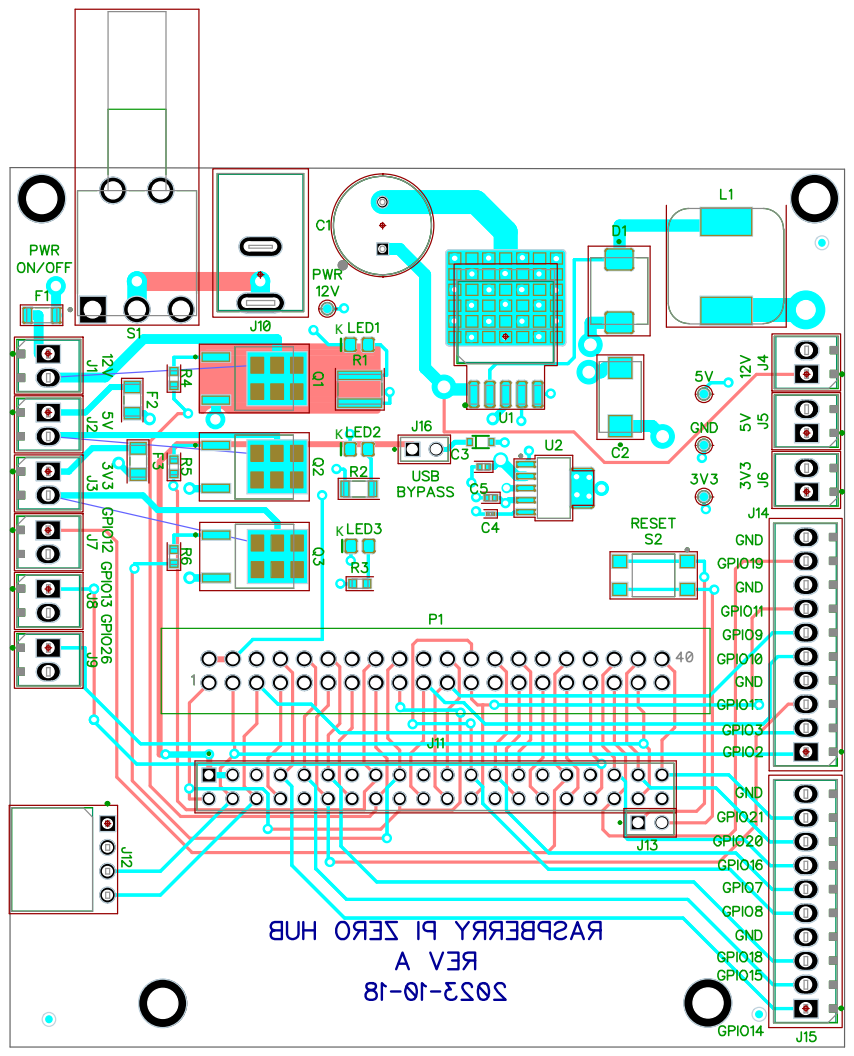
[picture p43: page 1]
KKK
