amber-sile-yang/Pi-Hub-PCB/Schematic_Rev B/Schematic_Rev B.pdf

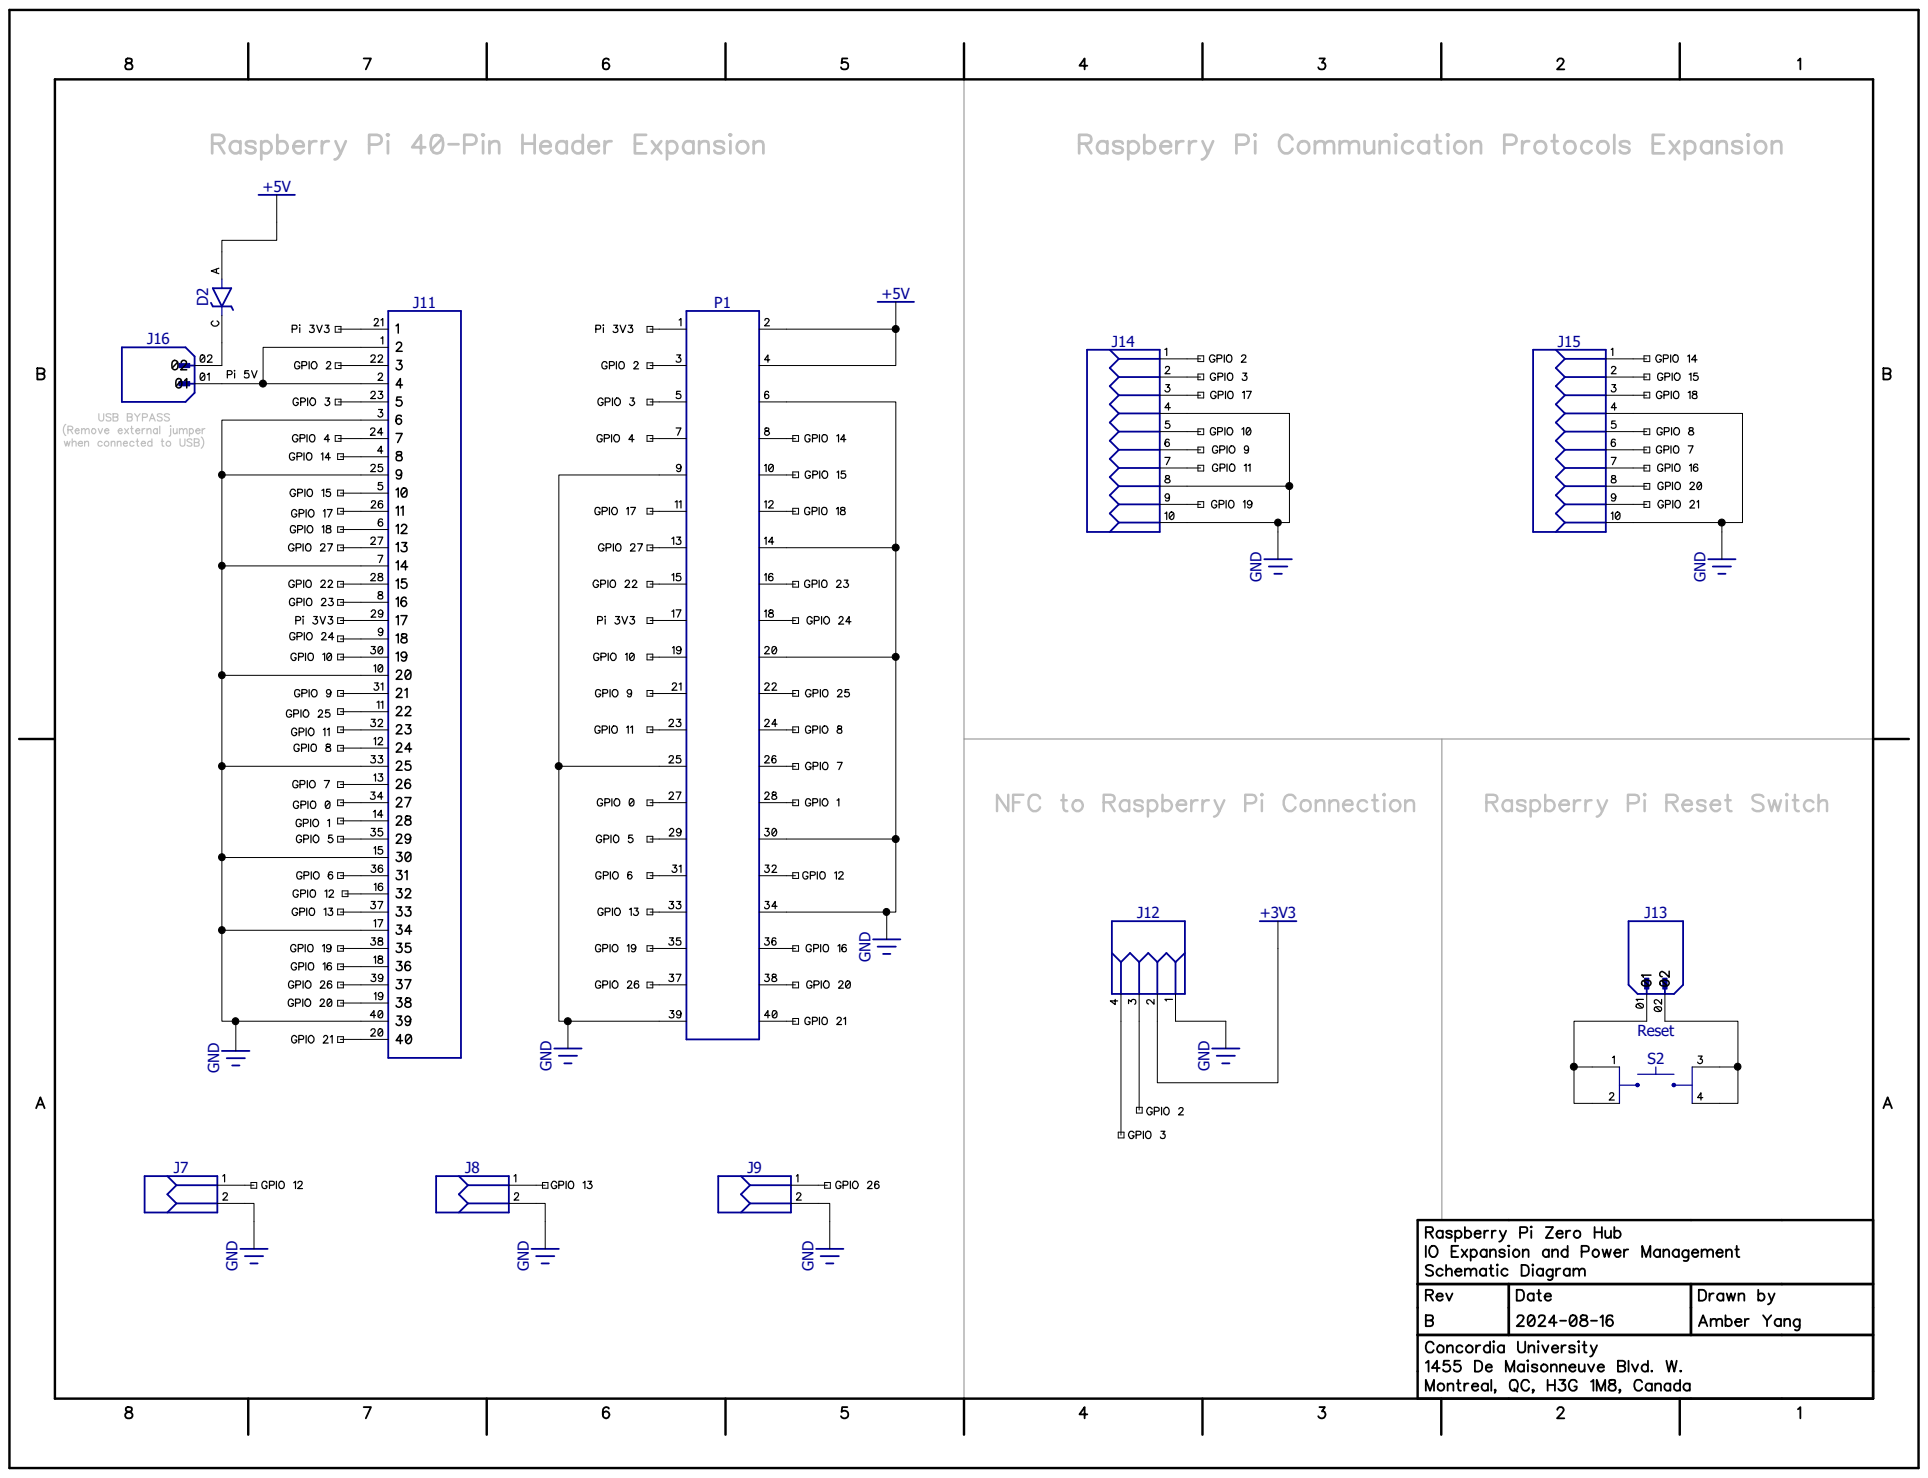
[picture p44: page 1]

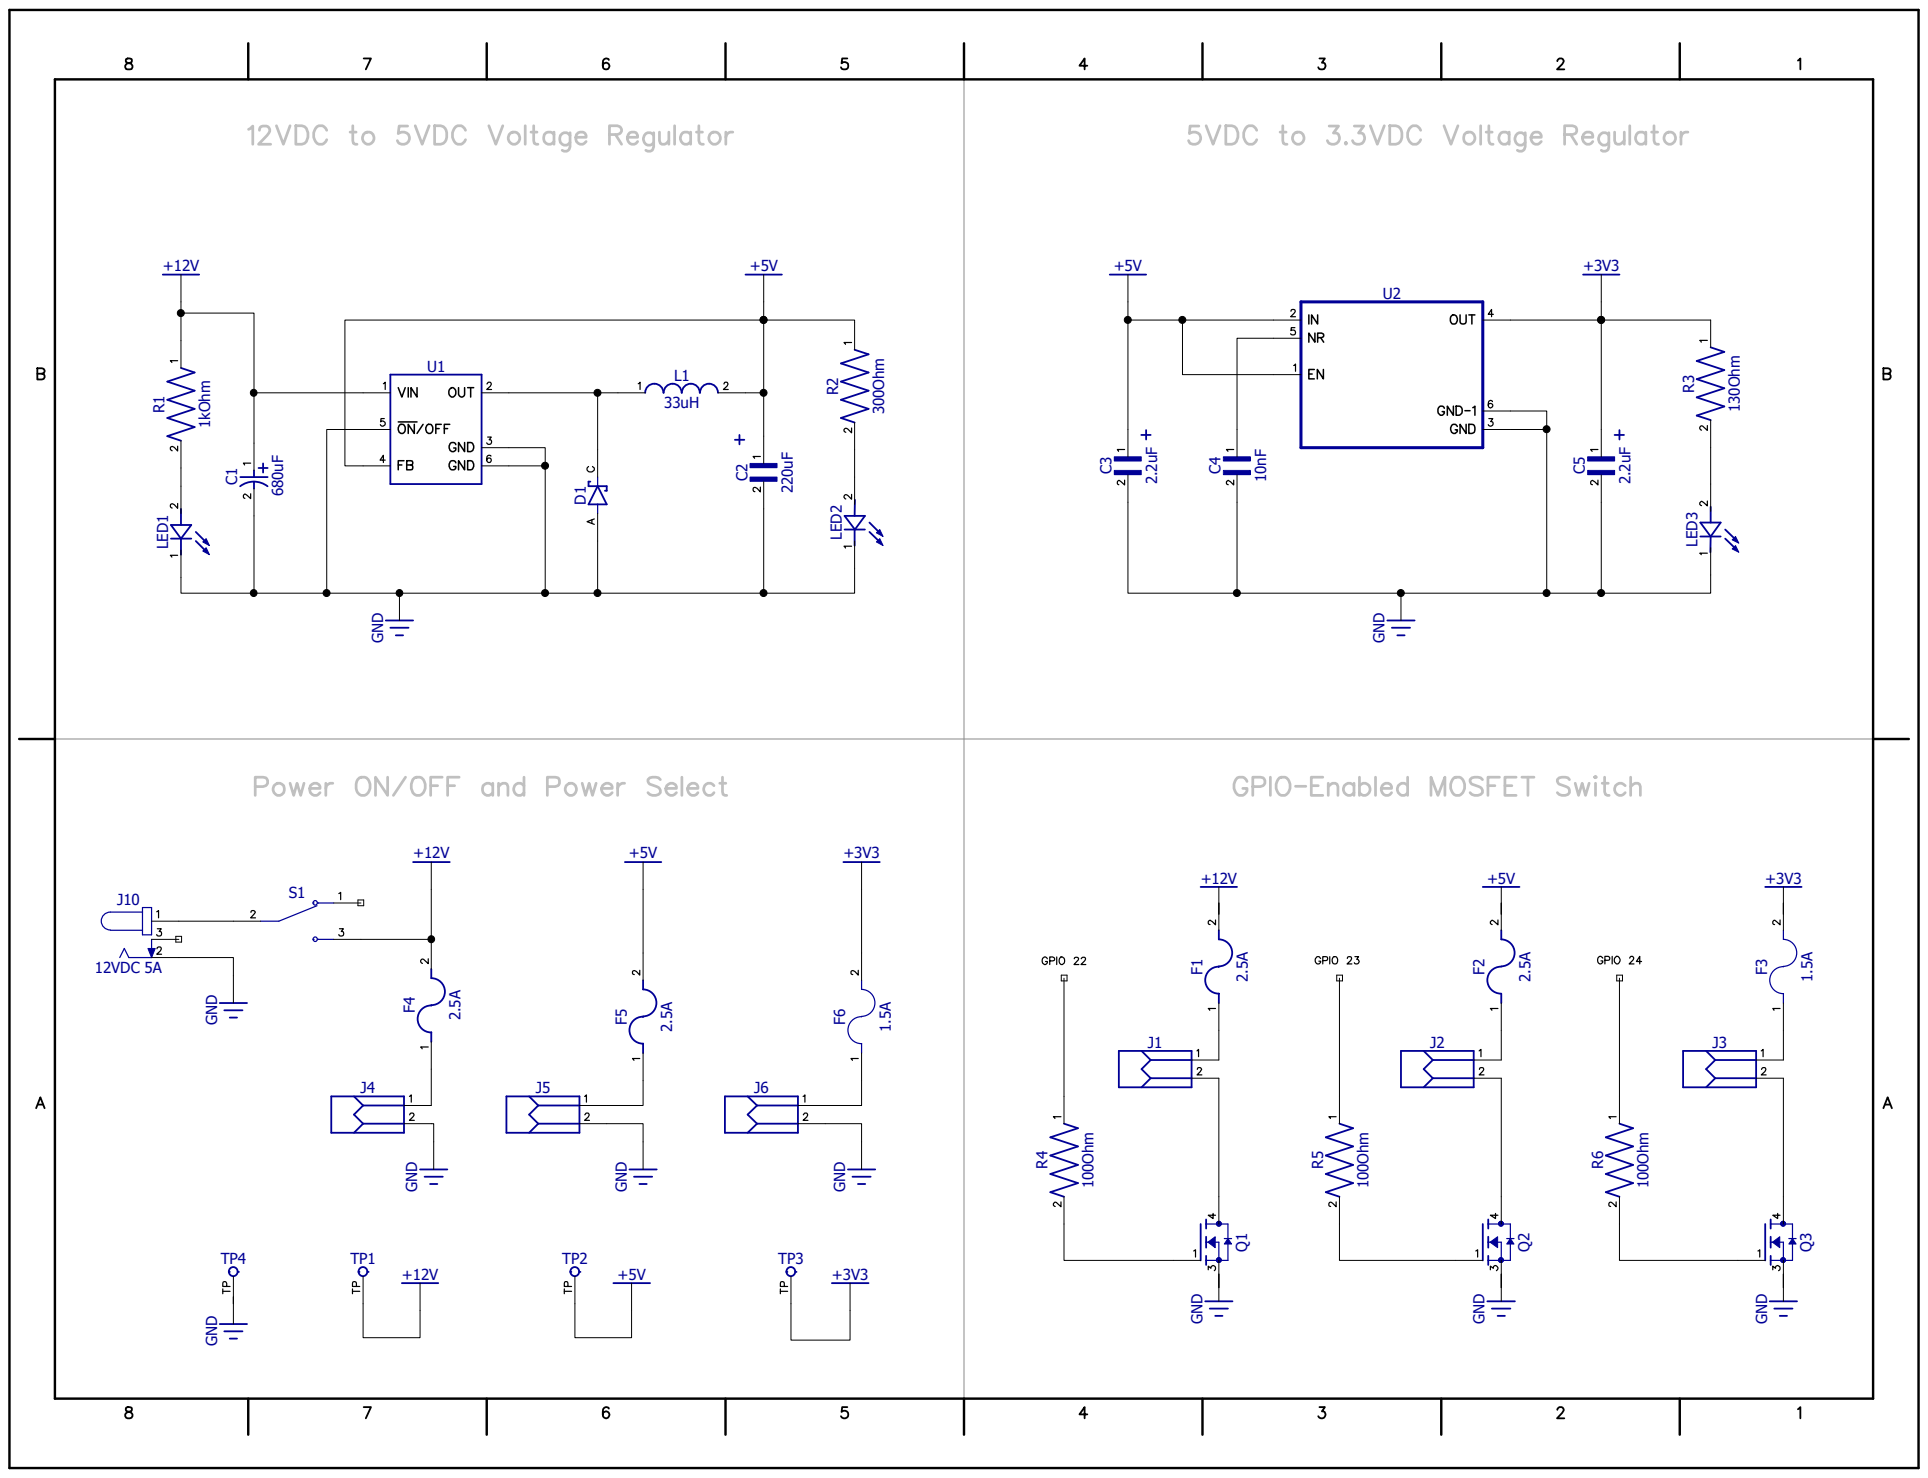
[picture p45: page 2]
