amber-sile-yang/Pi-Hub-PCB/Rev A/History/Pi-Hub PCB Schematic_Rev--.pdf

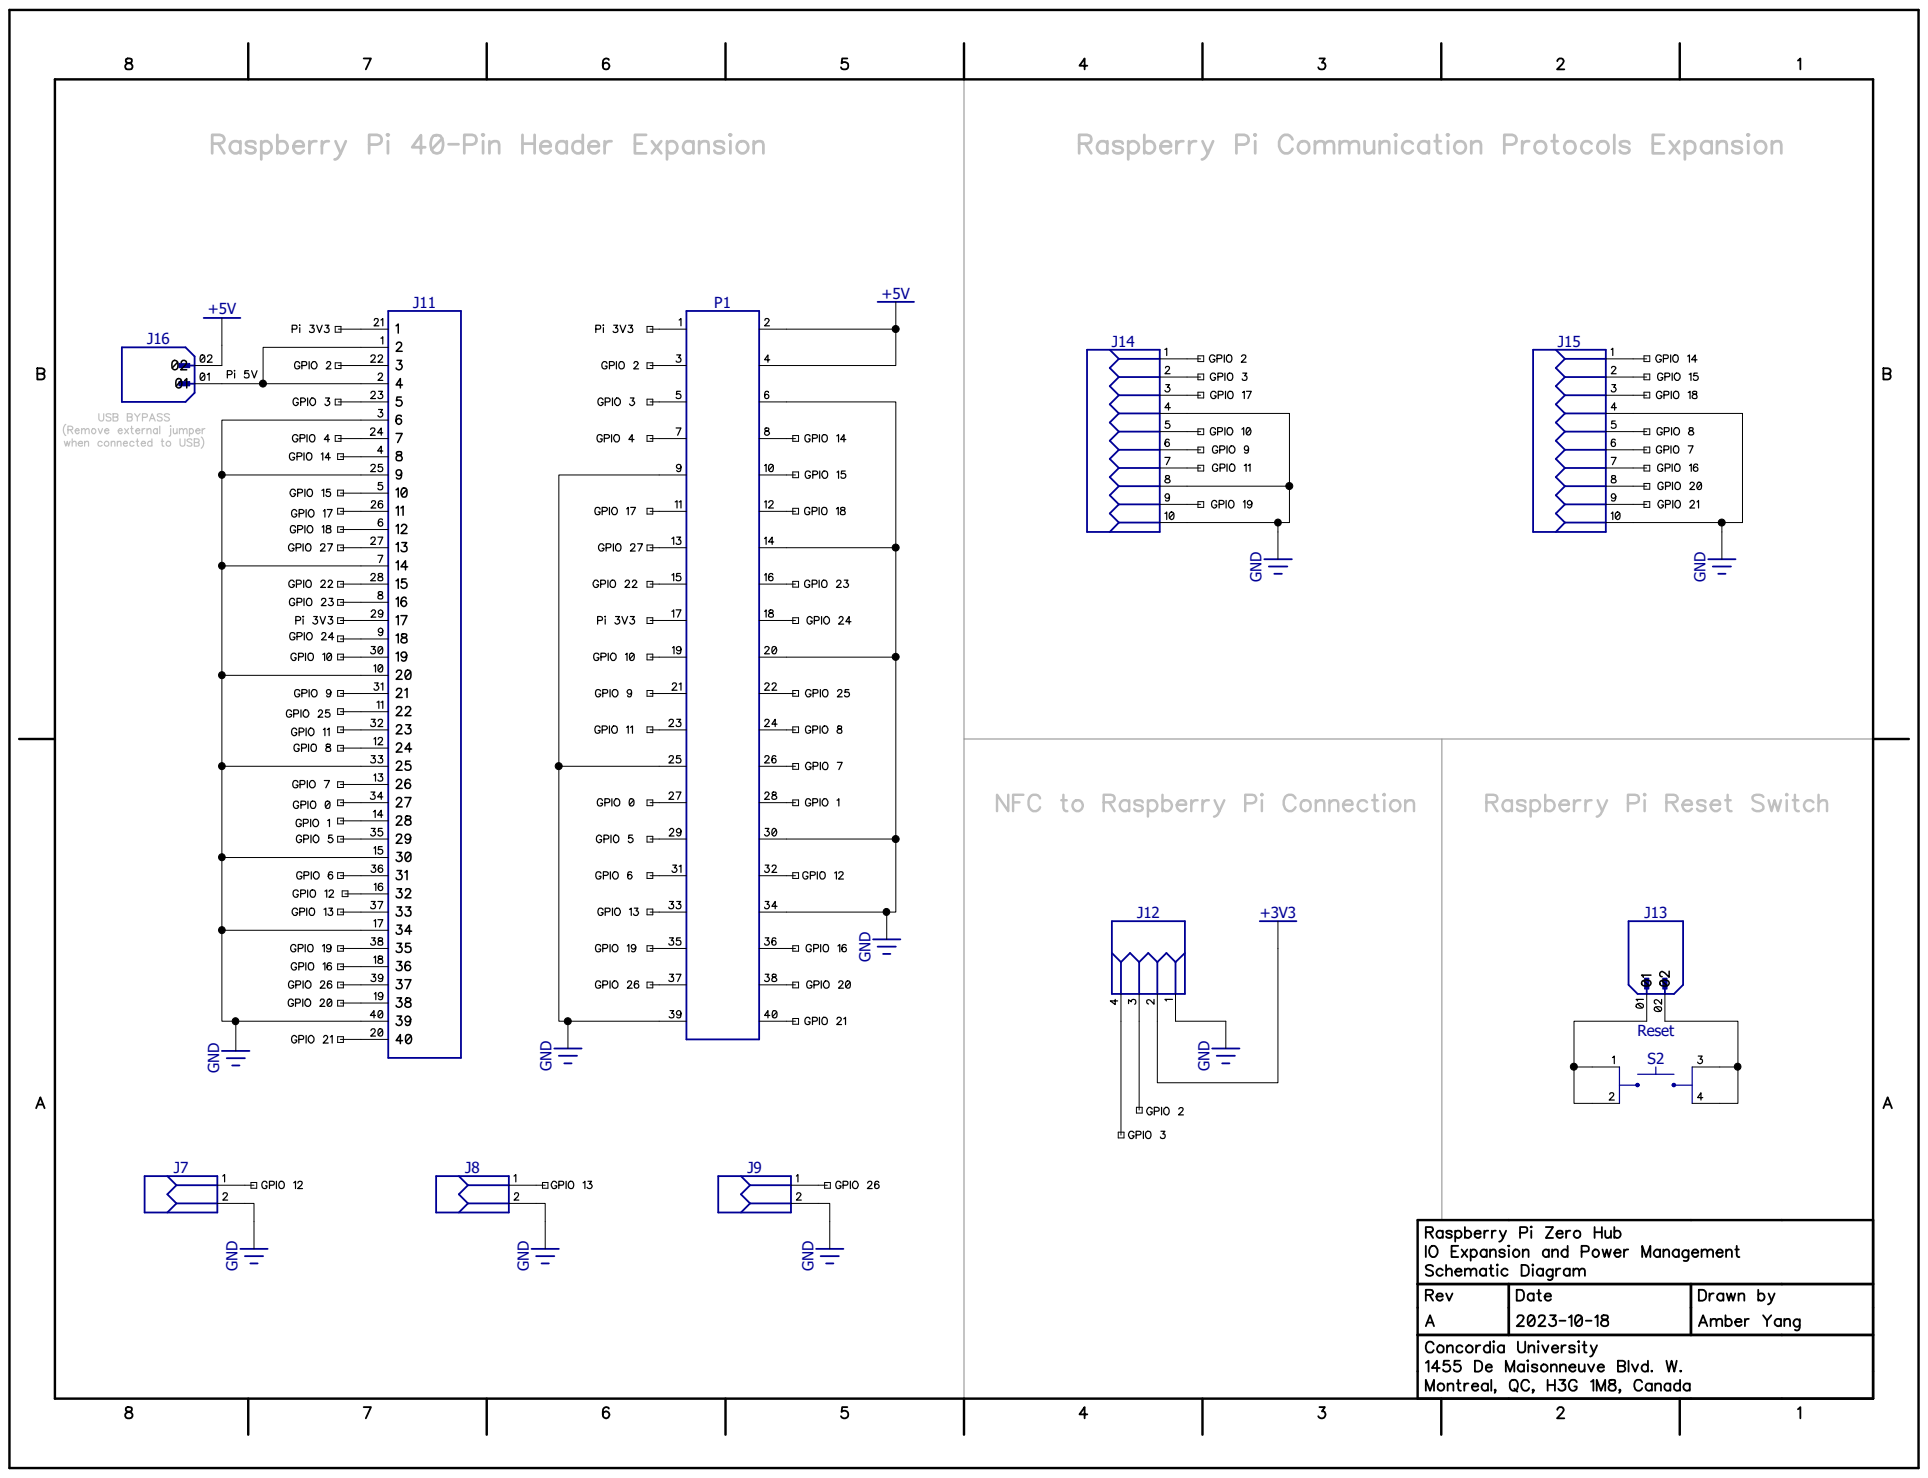
[picture p46: page 1]

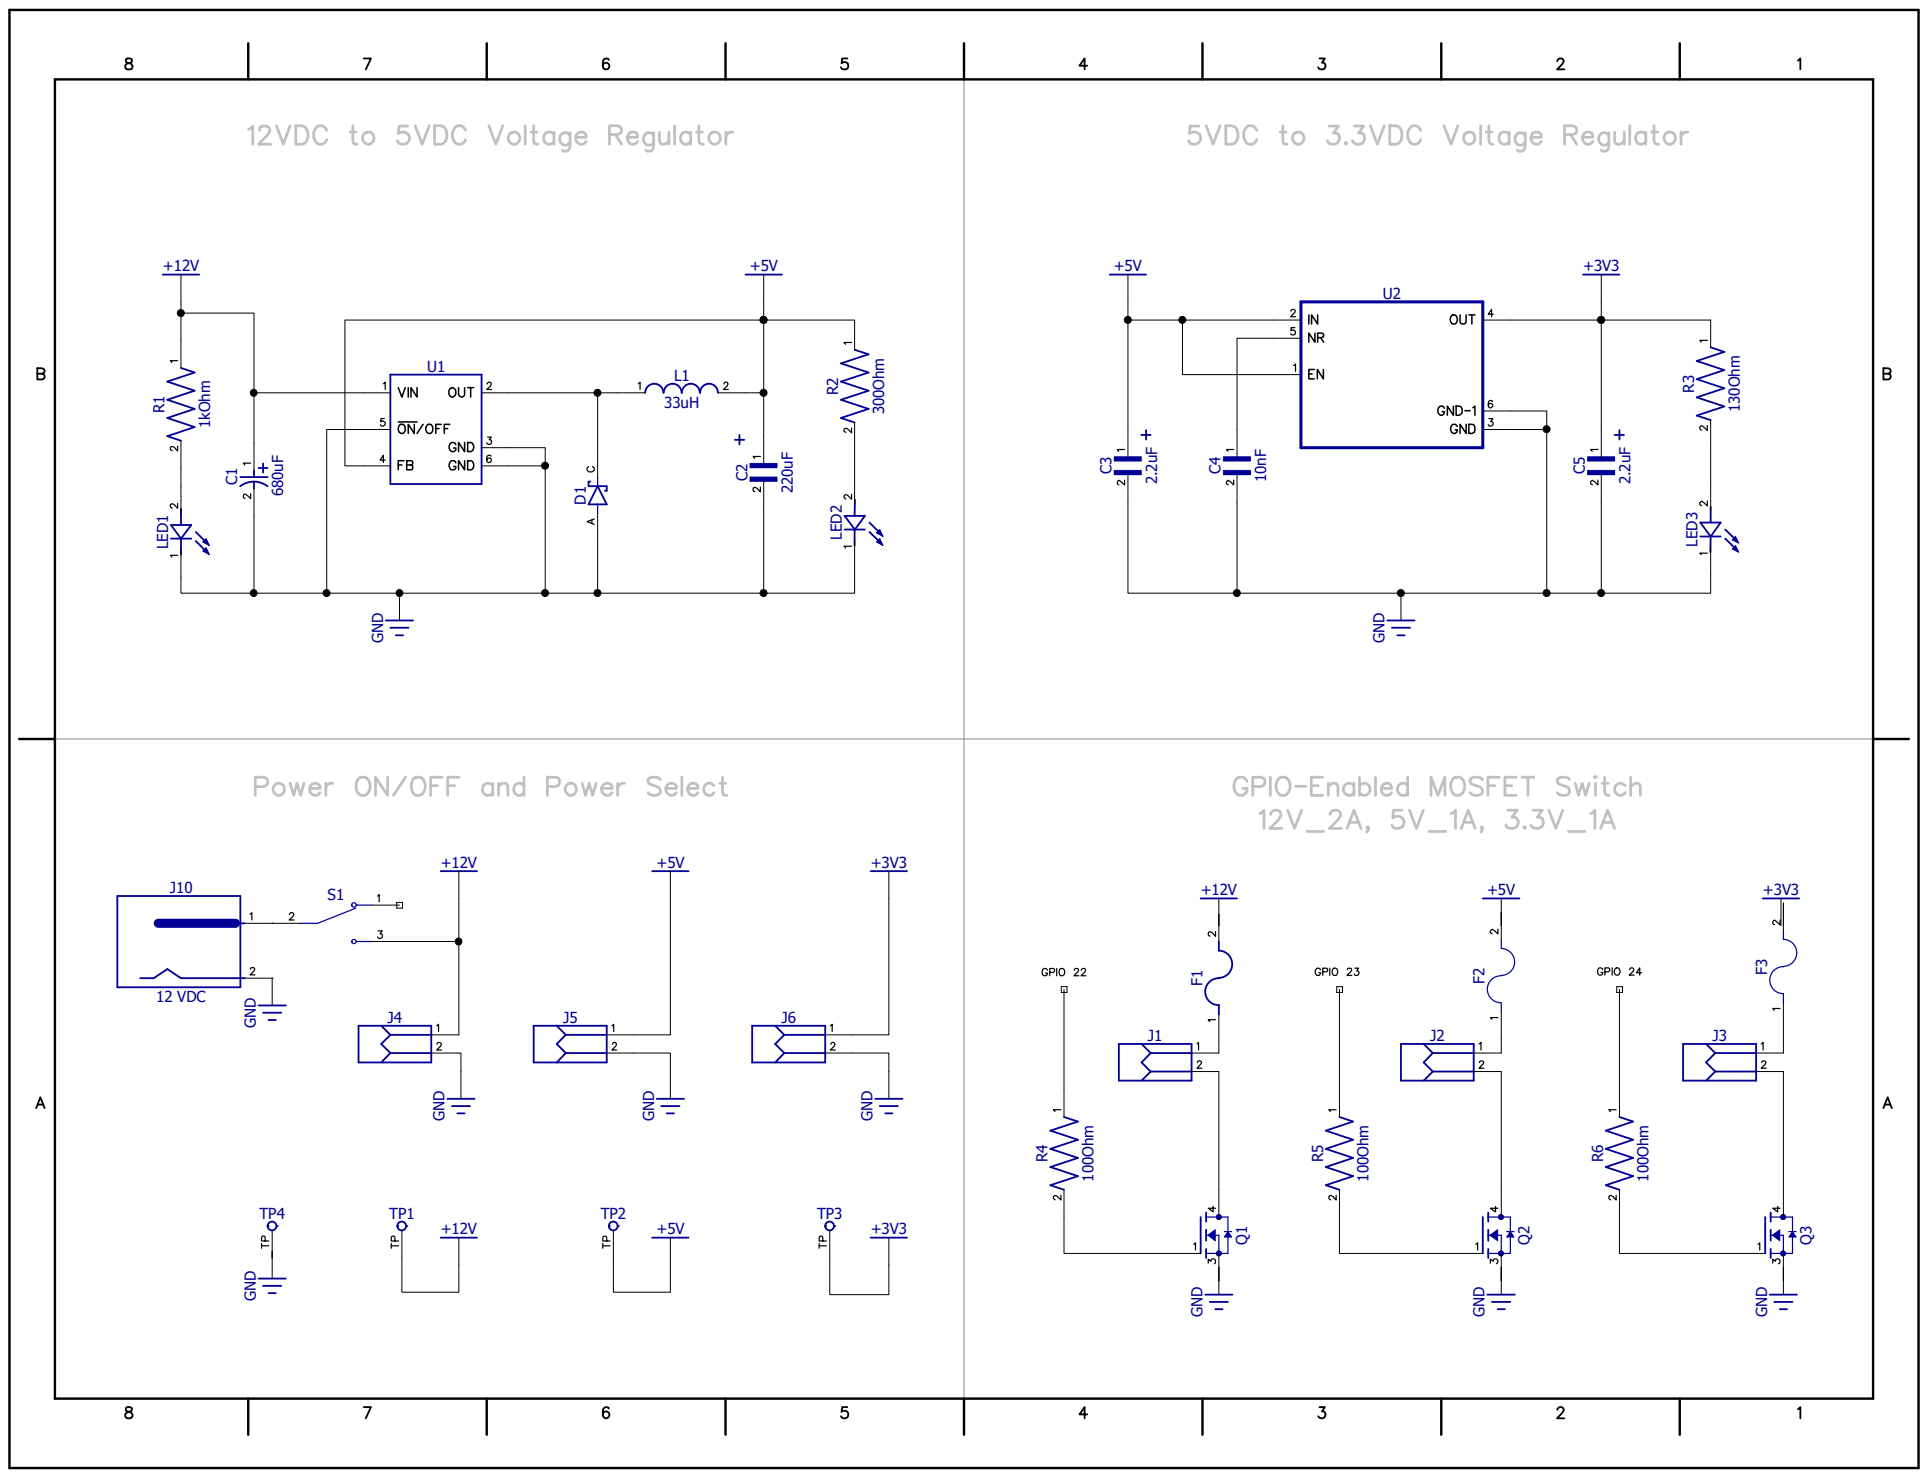
[picture p47: page 2]
