amber-sile-yang/Pi-Hub-PCB/Rev A/History/Pi-Hub PCB_Rev A_Schematic.pdf

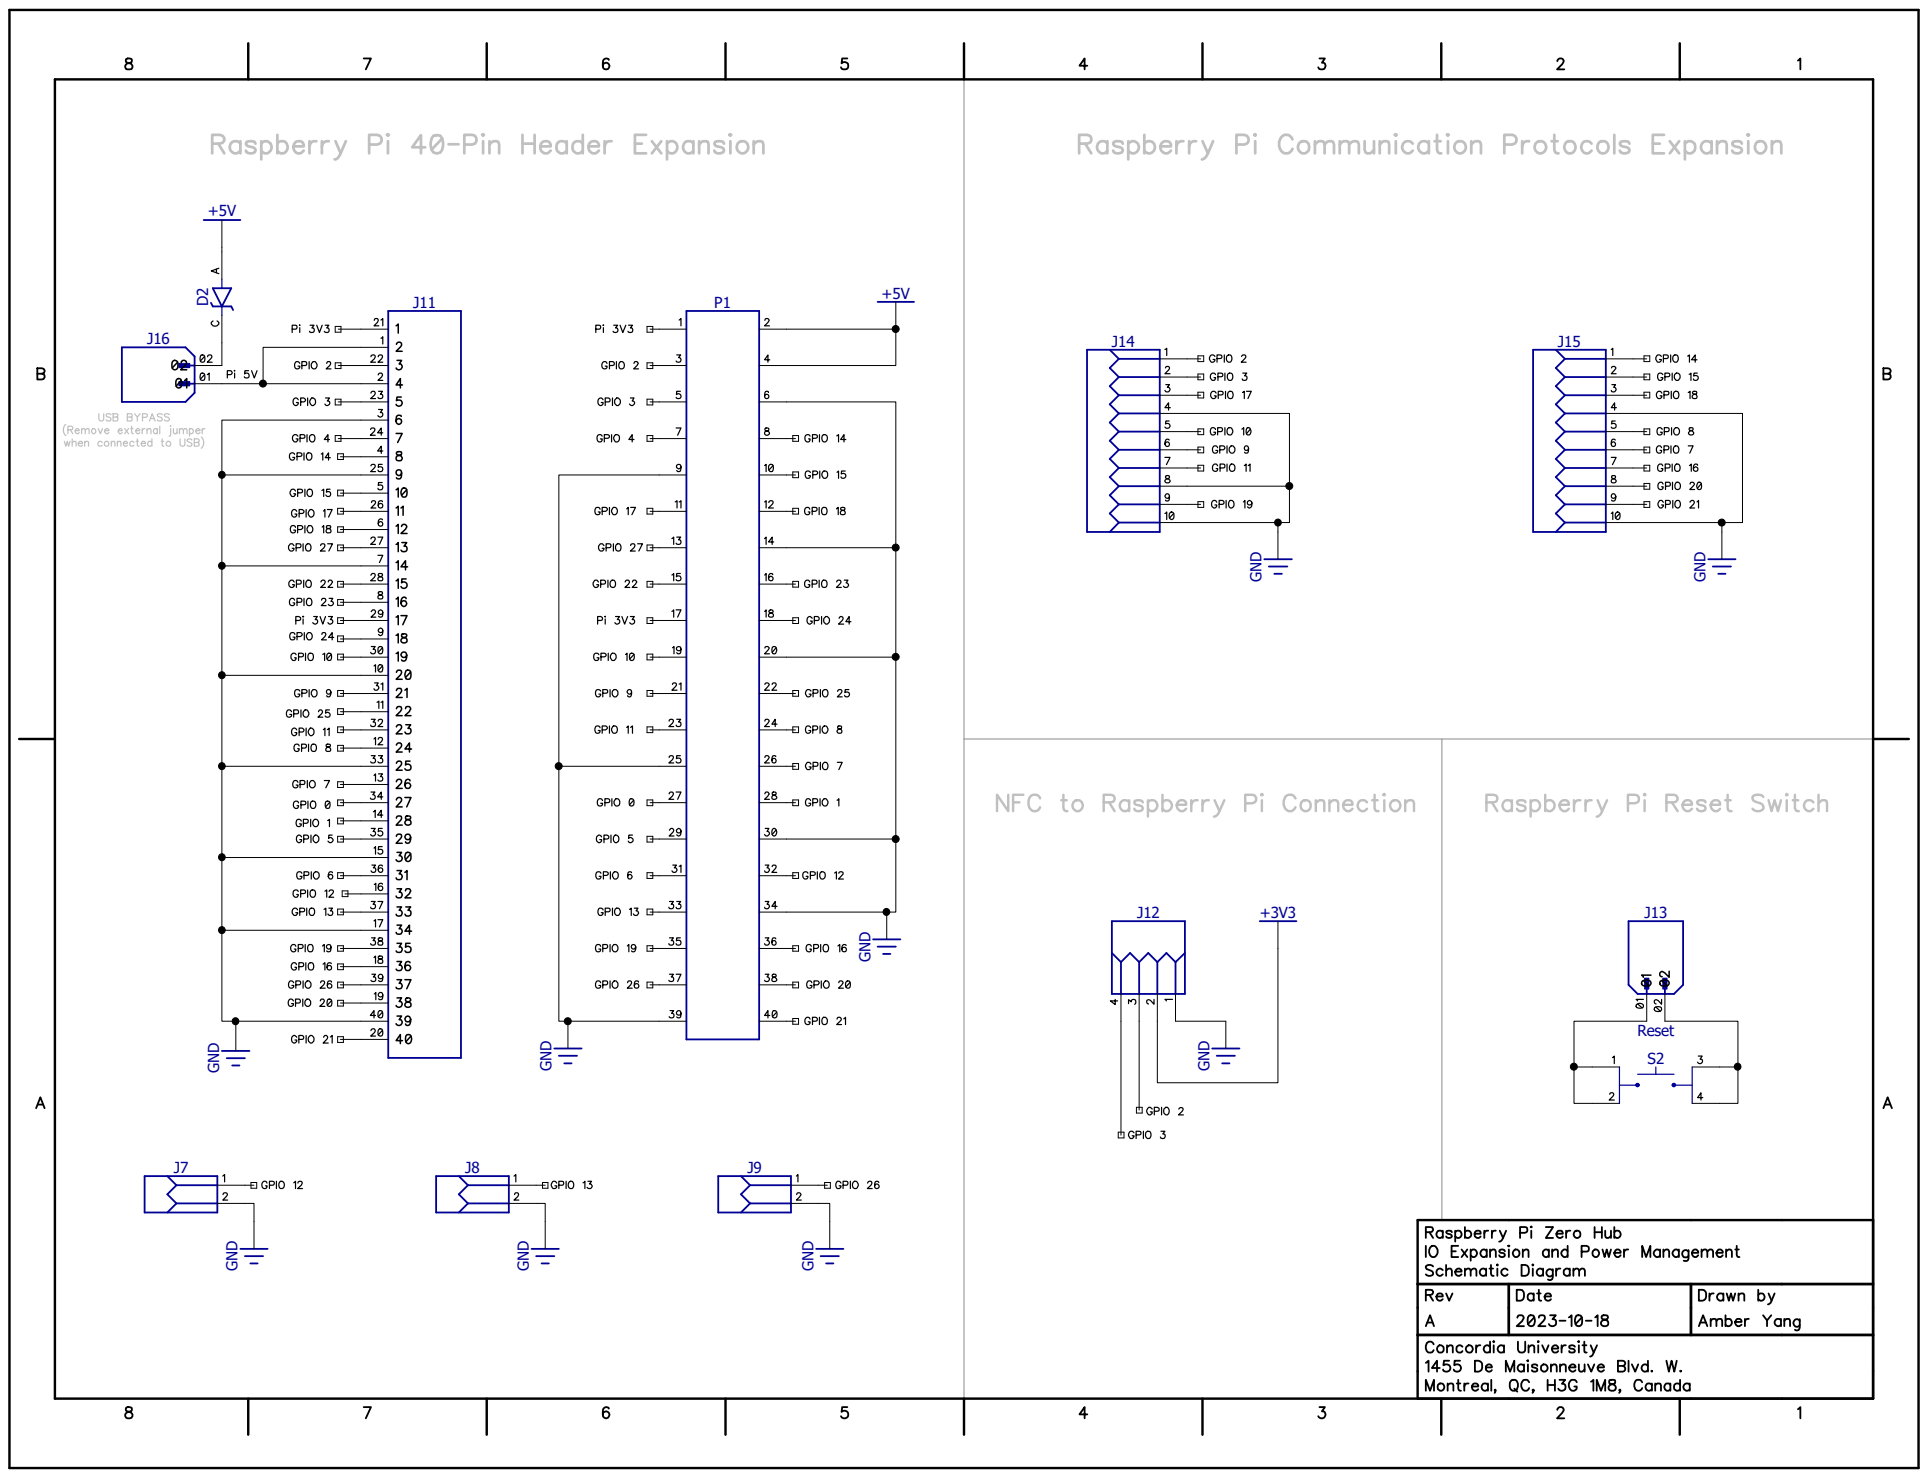
[picture p48: page 1]
