amber-sile-yang/Pi-Hub-PCB/Rev A/History/Pi-Hub Schematic_v01_For Spice.pdf

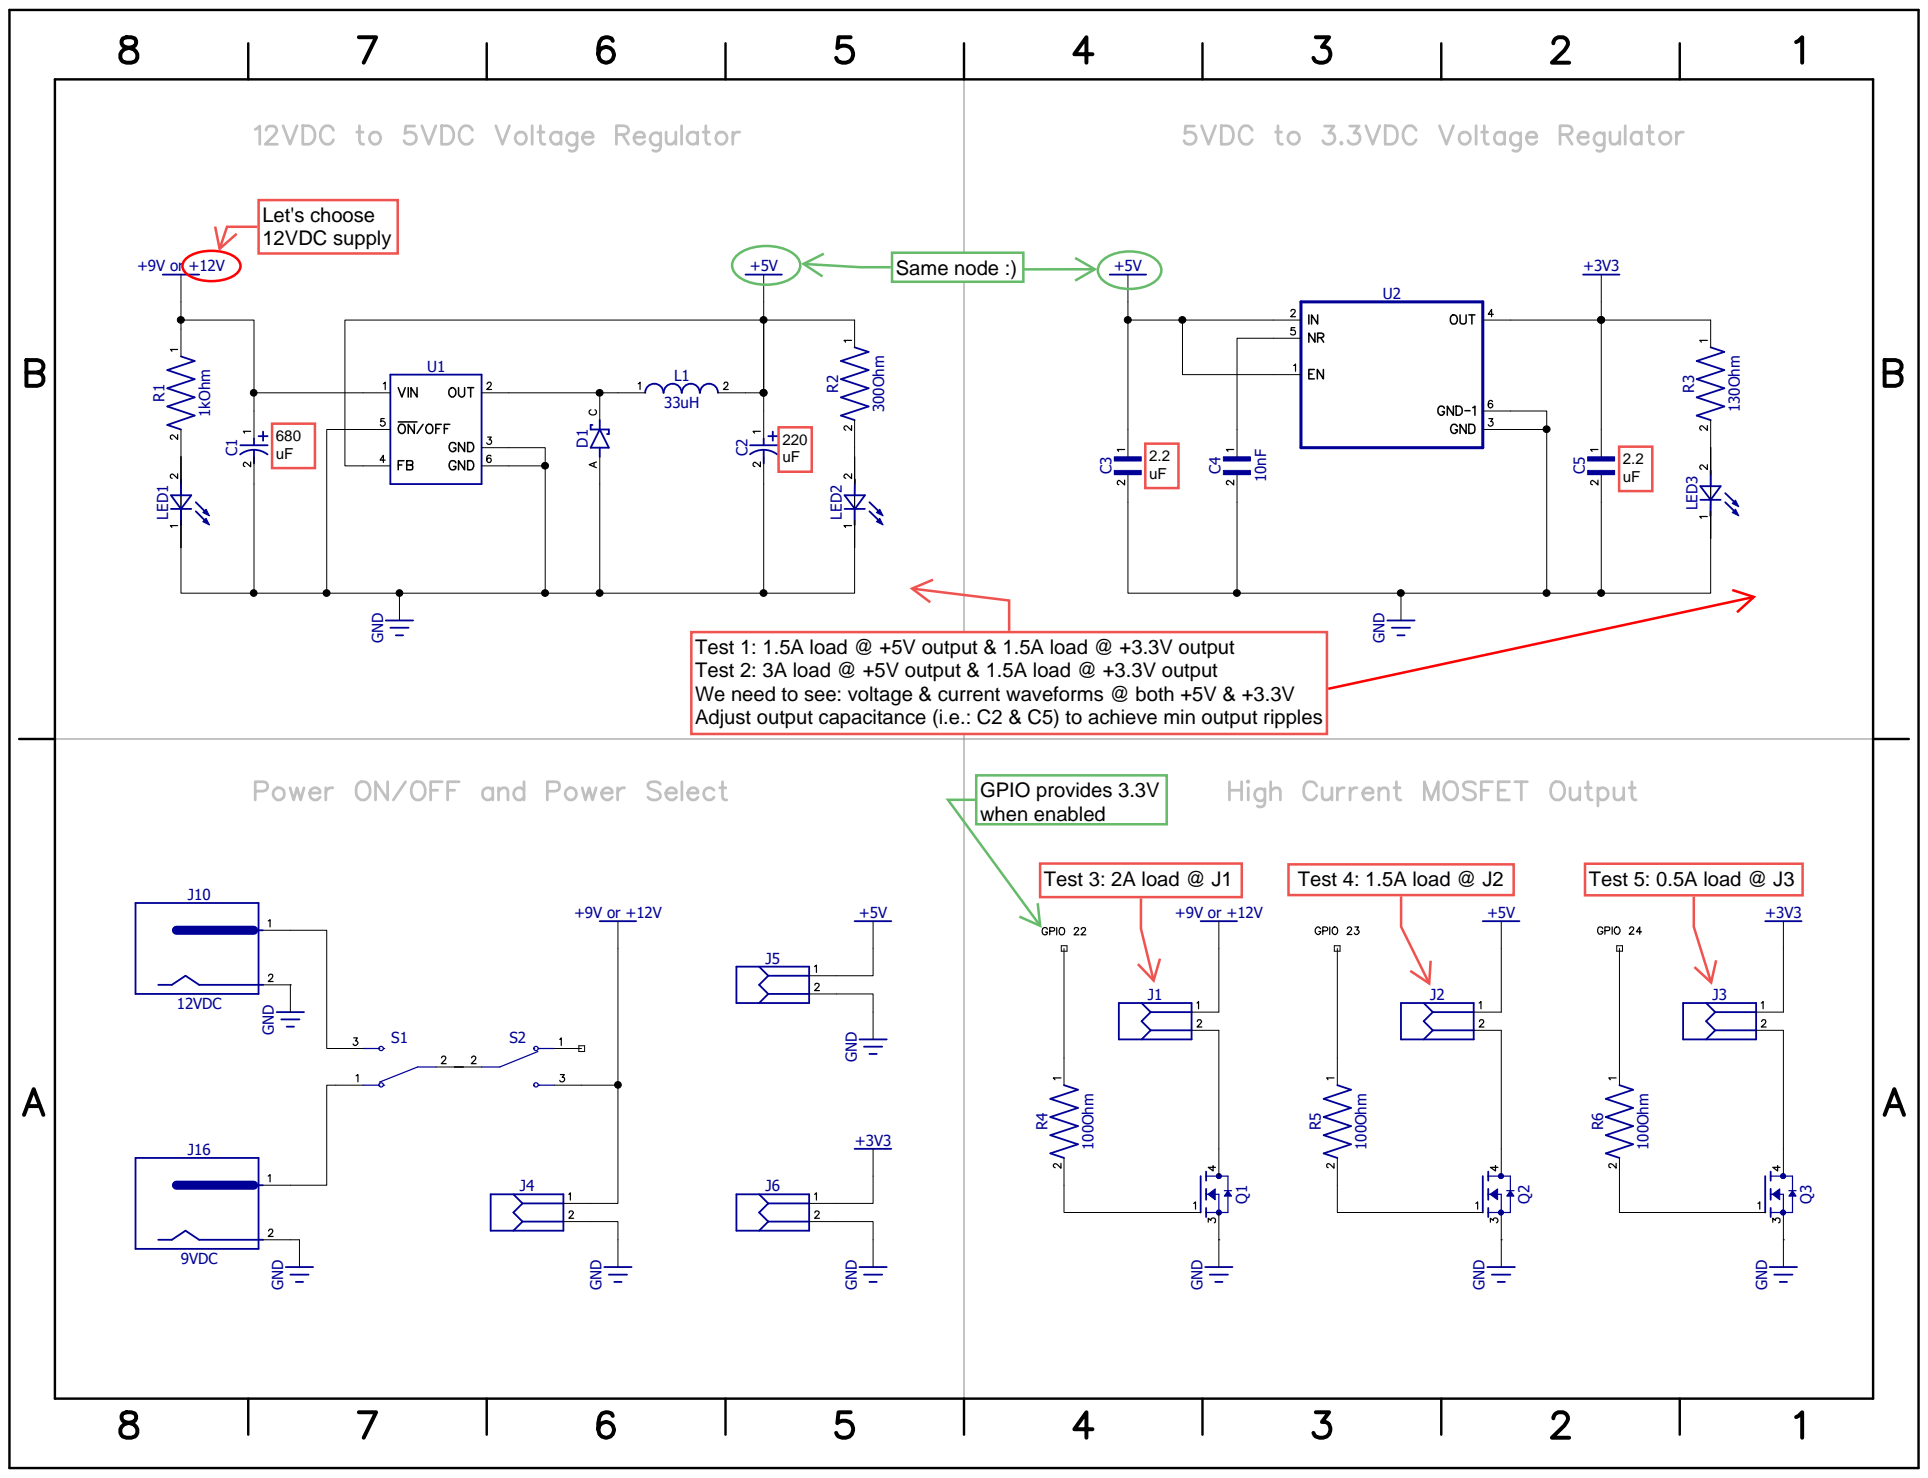
[picture p49: page 1]

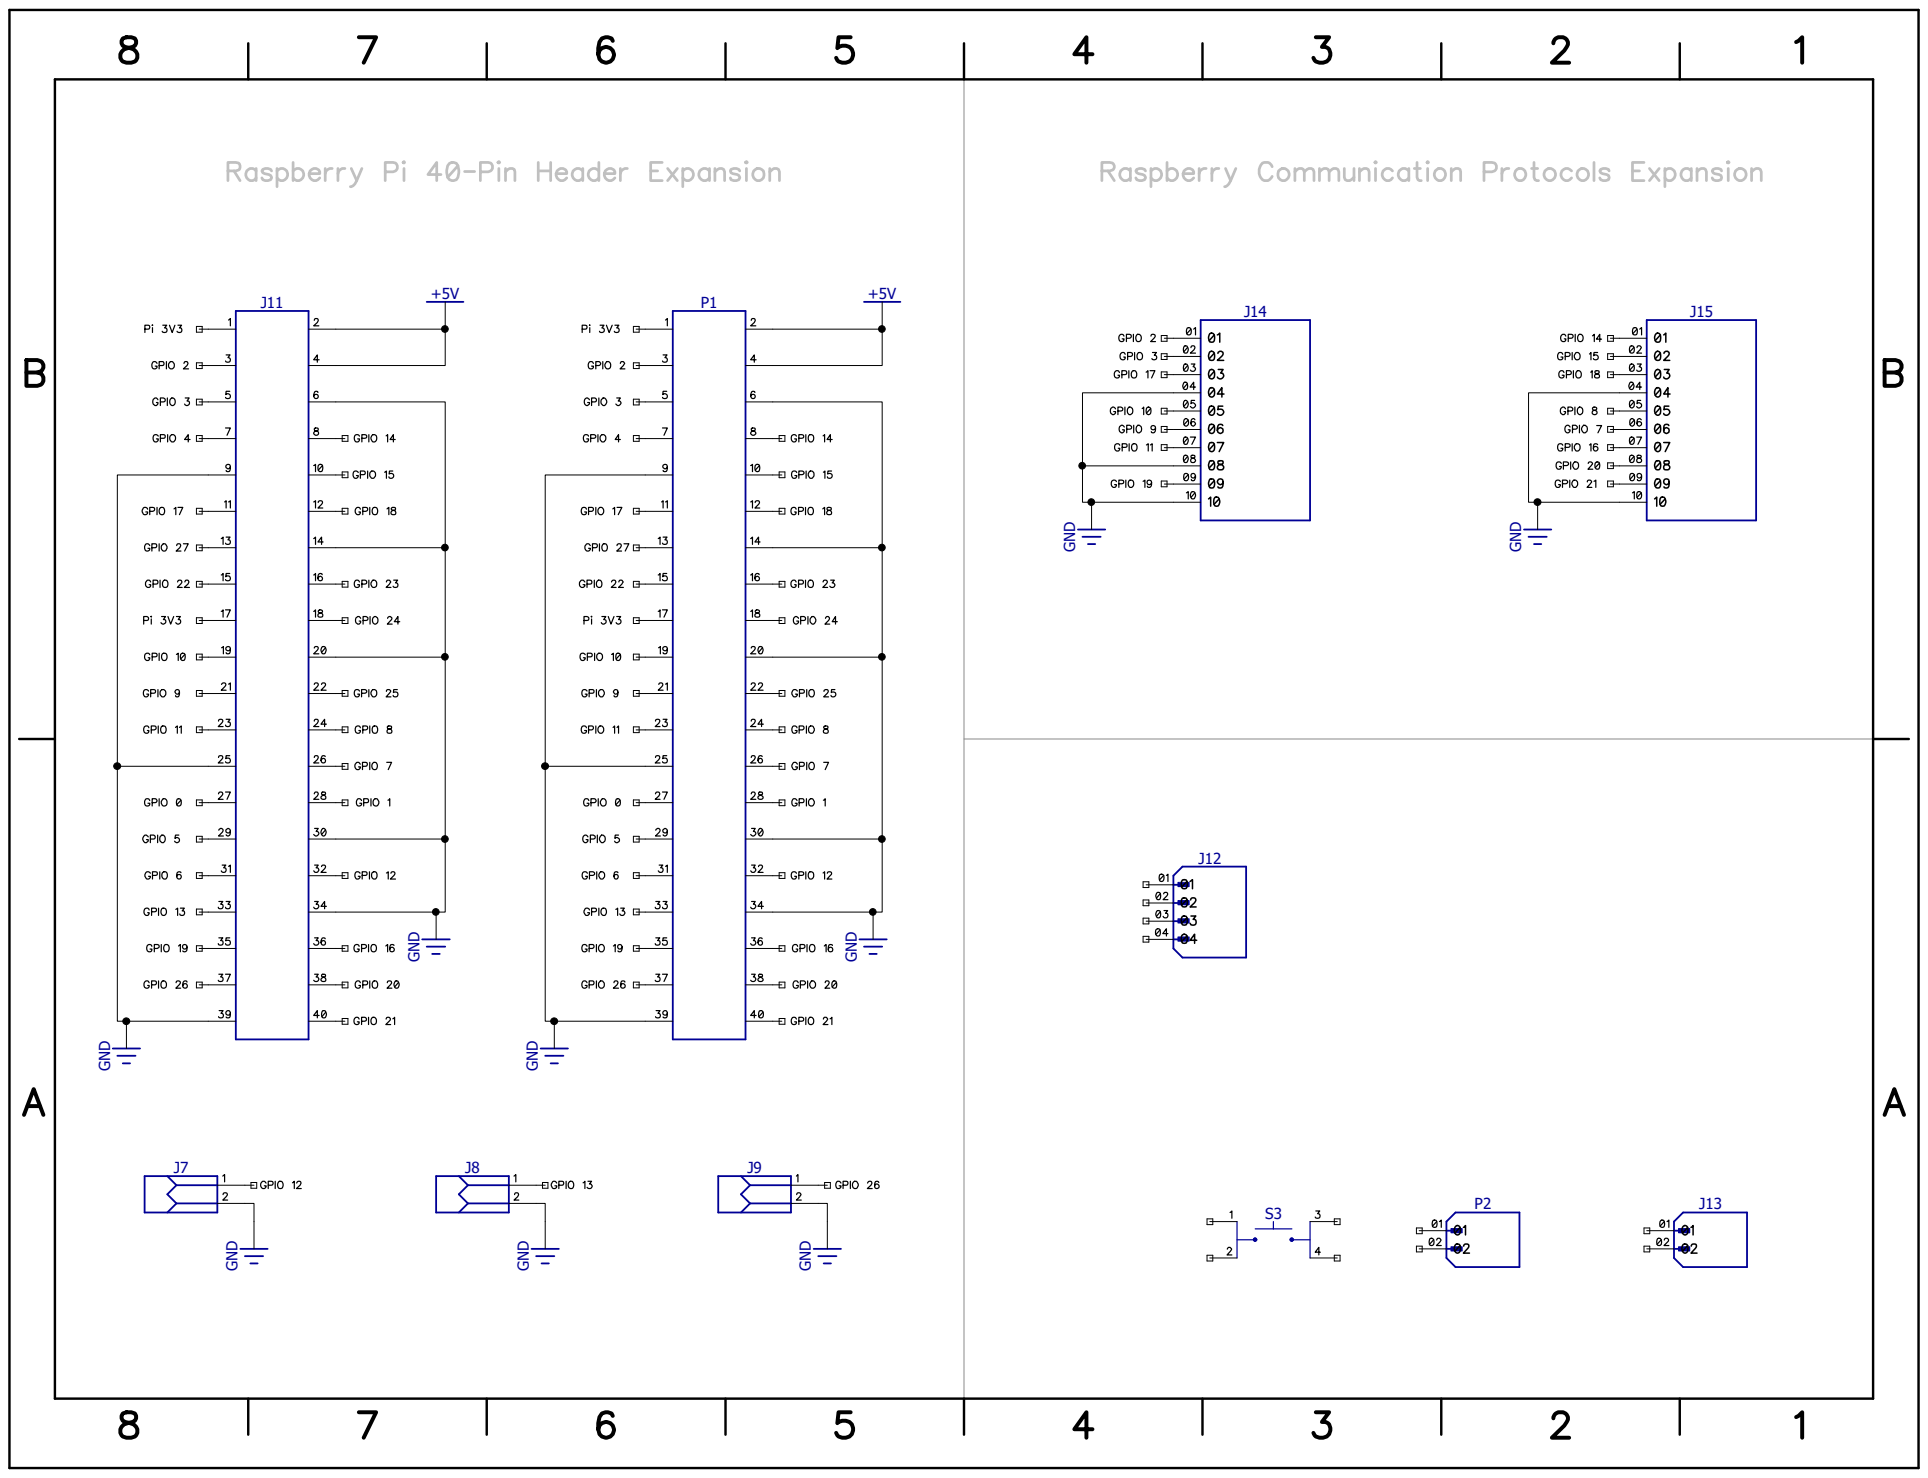
[picture p50: page 2]
