amber-sile-yang/Pi-Hub-PCB/Layout_Rev B/Layout_Rev B.pdf

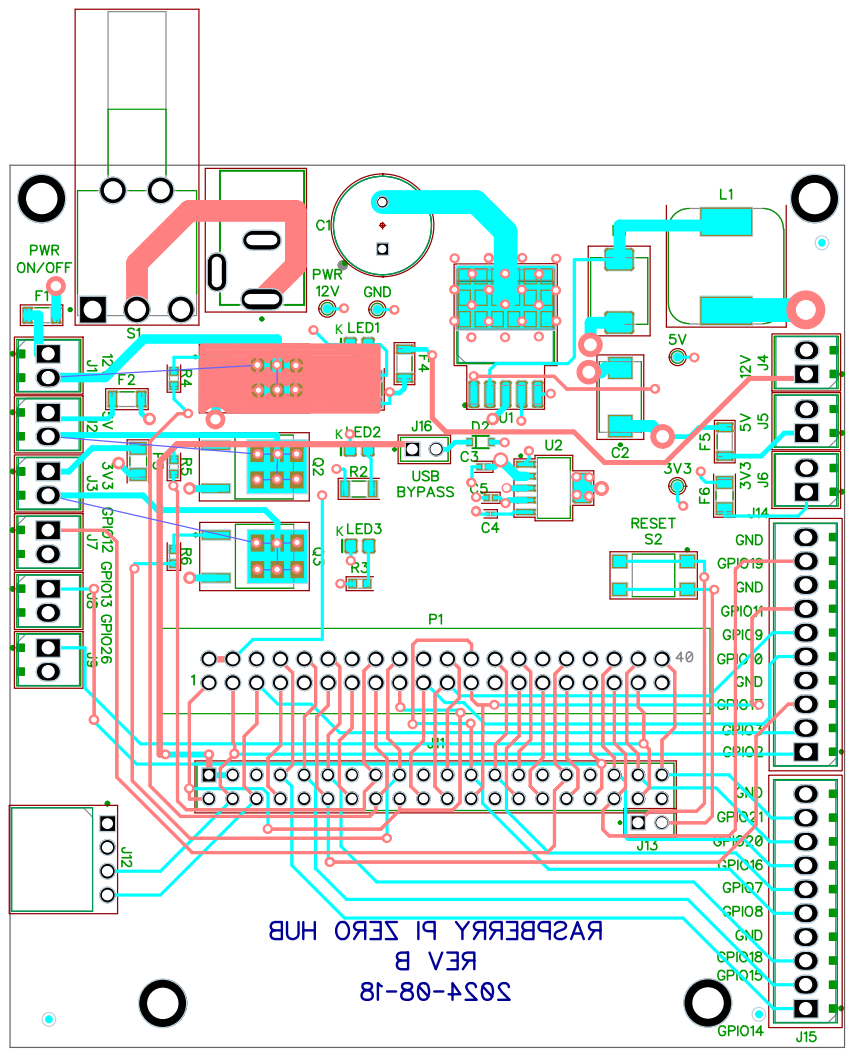
[picture p51: page 1]
KKK
