amber-sile-yang/Pi-Hub-PCB/Rev A/Schematic_Rev A/Pi-Hub Schematic_v00_For Spice.pdf

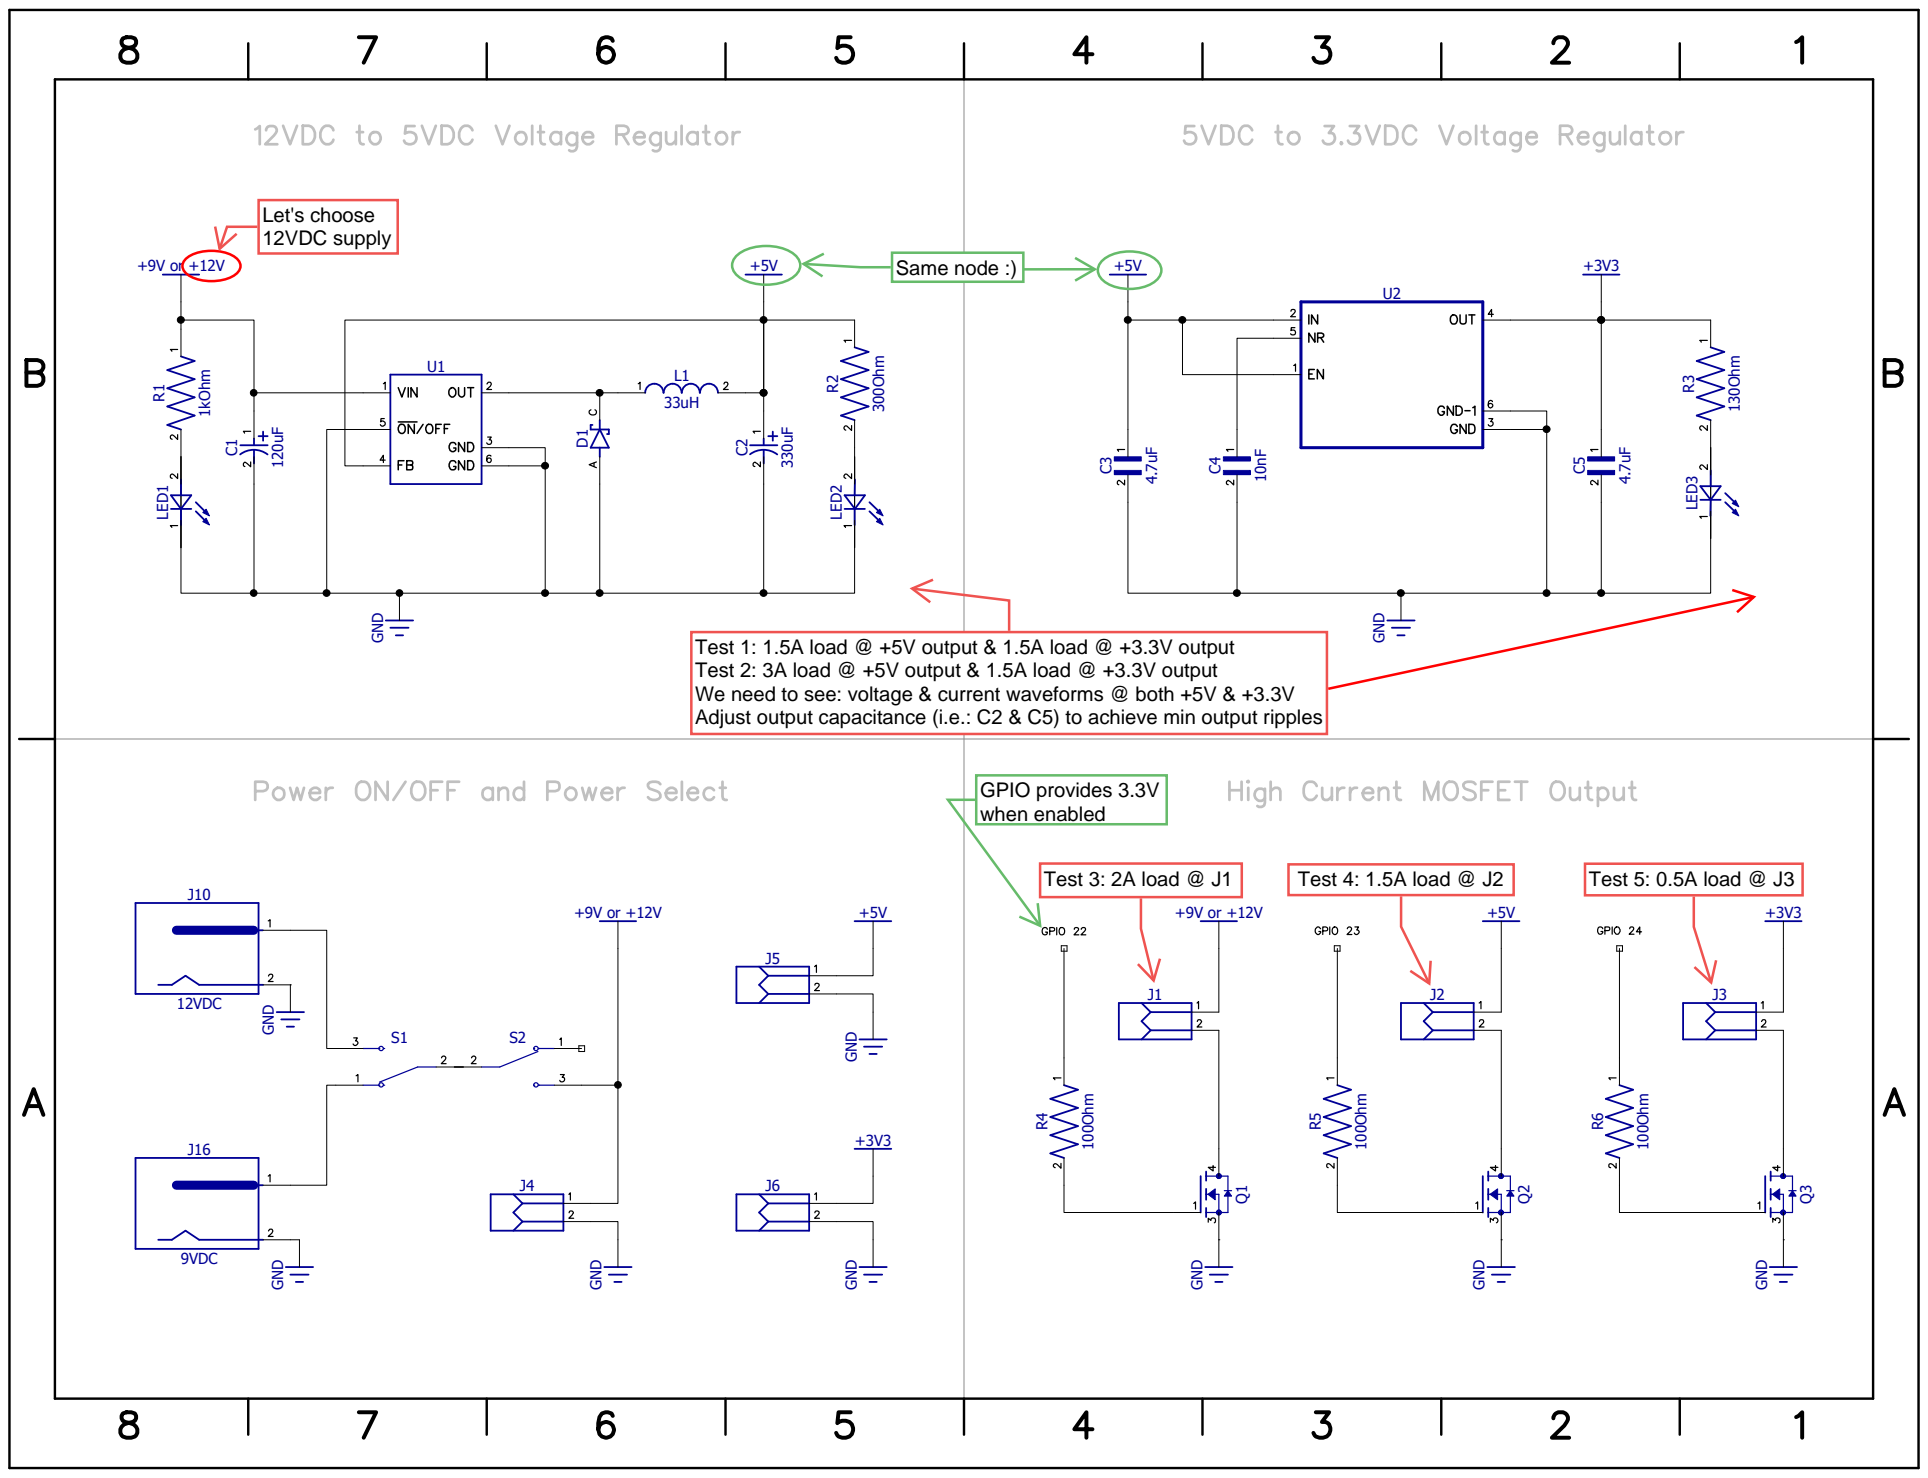
[picture p52: page 1]
