amber-sile-yang/Pi-Hub-PCB/(list of files, drawings)

Other design files:
Layout_Rev B/Pi-Hub_PCB_Rev B.dip
Rev A/History/Pi-Hub PCB_Layout_v01 - Copy (2).dip
Rev A/History/Pi-Hub PCB_Layout_v01 - Copy.dip
Rev A/History/Pi-Hub PCB_Layout_v01.dip
Rev A/History/Pi-Hub PCB_Layout_v02.dip
Rev A/History/Pi-Hub PCB_Layout_v03 - Copy.dip
Rev A/History/Pi-Hub PCB_Layout_v03.dip
Rev A/History/Pi-Hub PCB_Layout_v04 - Copy (2).dip
Rev A/History/Pi-Hub PCB_Layout_v04 - Copy (3).dip
Rev A/History/Pi-Hub PCB_Layout_v04 - Copy.dip
Rev A/History/Pi-Hub PCB_Layout_v05.dip
Rev A/History/Pi-Hub PCB_Layout_v06 - Copy.dip
Rev A/History/Pi-Hub PCB_Layout_v06.dip
Rev A/History/Pi-Hub PCB_Layout_v07 - Copy.dip
Rev A/History/Pi-Hub PCB_Layout_v07.dip
Rev A/History/Pi-Hub PCB_Rev A.dch
Rev A/History/Pi-Hub PCB_Rev-- - Copy.dch
Rev A/History/Pi-Hub PCB_Rev--.dch
Rev A/History/Pi-Hub PCB_ver01 - Copy.dch
Rev A/History/Pi-Hub PCB_ver01.dch
Rev A/History/Pi-Hub PCB_ver02.dch
Rev A/History/Pi-Hub PCB_ver03 - Copy.dch
Rev A/History/Pi-Hub PCB_ver03.dch
Rev A/History/Pi-Hub PCB_ver04 - Copy (2).dch
Rev A/History/Pi-Hub PCB_ver04 - Copy (3).dch
Rev A/History/Pi-Hub PCB_ver04 - Copy.dch
Rev A/History/Pi-Hub PCB_ver05.dch
Rev A/History/Pi-Hub PCB_ver06.dch
Rev A/History/Pi-Hub PCB_ver07.dch
Rev A/History/Pi-Hub PCB_ver08.dip
Rev A/History/Pi-Hub PCB_ver09.dch
Rev A/History/Pi-Hub_PCB_Rev ---.dip
Rev A/History/Pi-Hub_PCB_Rev A - Copy.dip
Rev A/History/Pi-Hub_PCB_Rev A.dip
Rev A/History/Pi-Hub_PCB_Rev-- - Copy.dip
Rev A/History/Pi-Hub_PCB_Rev---.dip
Rev A/History/Pi-Hub_PCB_Rev--.dip
Rev A/History/Pi-Hub_PCB_ver09.dip
Rev A/Layout_Rev A/Pi-Hub PCB_Layout_v02.dip
Rev A/Layout_Rev A/Pi-Hub PCB_Layout_v03.dip
Rev A/Layout_Rev A/Pi-Hub PCB_Layout_v04.dip
Rev A/Layout_Rev A/Pi-Hub PCB_Layout_v05.dip
Rev A/Layout_Rev A/Pi-Hub PCB_Layout_v06.dip
Rev A/Layout_Rev A/Pi-Hub PCB_ver08.dip
Rev A/Layout_Rev A/Pi-Hub_PCB_Rev ---.dip
Rev A/Layout_Rev A/Pi-Hub_PCB_Rev A.dip
Rev A/Layout_Rev A/Pi-Hub_PCB_Rev--.dip
Rev A/Layout_Rev A/Pi-Hub_PCB_ver09.dip
Rev A/Schematic_Rev A/Pi-Hub PCB_Rev A.dch
Rev A/Schematic_Rev A/Pi-Hub PCB_Rev--.dch
Rev A/Schematic_Rev A/Pi-Hub PCB_ver00.dch
Rev A/Schematic_Rev A/Pi-Hub PCB_ver01.dch
Rev A/Schematic_Rev A/Pi-Hub PCB_ver02.dch
Rev A/Schematic_Rev A/Pi-Hub PCB_ver03.dch
Rev A/Schematic_Rev A/Pi-Hub PCB_ver04.dch
Rev A/Schematic_Rev A/Pi-Hub PCB_ver05.dch
Rev A/Schematic_Rev A/Pi-Hub PCB_ver06.dch
Rev A/Schematic_Rev A/Pi-Hub PCB_ver08.dch
Rev A/Schematic_Rev A/Pi-Hub PCB_ver09.dch
Schematic_Rev B/Pi-Hub PCB_Rev B.dch
