amber-sile-yang/Pi-Hub-PCB/(commit log)

2024-08-15 Pi-Hub PCB Rev A documentations and Gerber file completed. Rev B is wip.
    [BOM.xlsx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]
2024-08-16 rev B schematic done, rev B layout wip.
    [BOM.xlsx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]
2024-08-18 Rev B completed.
    [1 - Top.gbr, 2 - Ground Plane.gbr, 3 - Power Plane.gbr, 4 - Bottom.gbr, BoardOutline.gbr, BottomAssembly.gbr, BottomDimension.gbr, BottomMask.gbr]
